bogdan-tirzioru/Powersupply/piesedisponibile.docx

1) INA 169NA

2) STM32F767ZIT

3) LT490CN8

4) MCP794124

5) MCP6491T

6) OPA134PA

7) MCP6001T

8) LM35CZ

9) ADC121S021

10) IRL640PBF

11) POT10K

12) MCP795W1O5

13) POWER REZISTOR 0.01

14) 4GBJ/4005

15) MCP6P22 1G AMP 21H
