bogdan-tirzioru/Powersupply/reaserch/alice/sapt2.docx

Orar:

Luni -

Marti 8-12 / 8-5

Miercuri 8-5

Joi 13-5/-

Vineri 8-12/8-5

- Revad partea electrica si o sa tin cont si de ce sfaturi mai primesc de la indrumatorul de licenta
- Testez partea de soft pentru buck
- Incep sa fac functionala partea de boost
- Maresc frecventa de lucru
