bogdan-tirzioru/Powersupply/reaserch/service_manual/HP_6234A_-_PWB_schematic.pdf

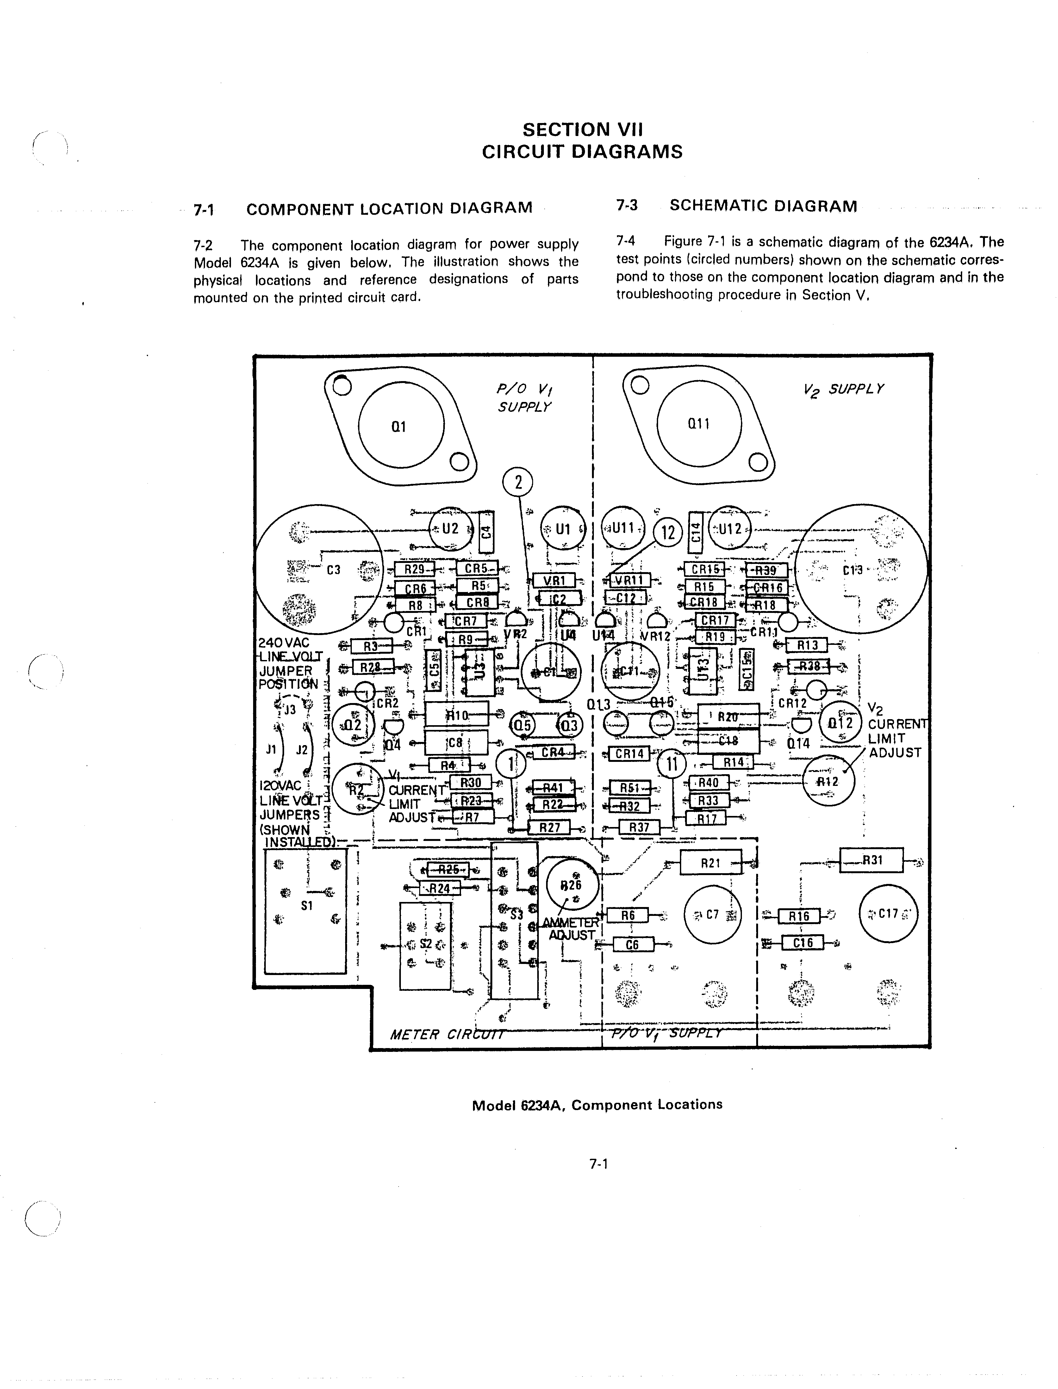
[picture p31: page 1]
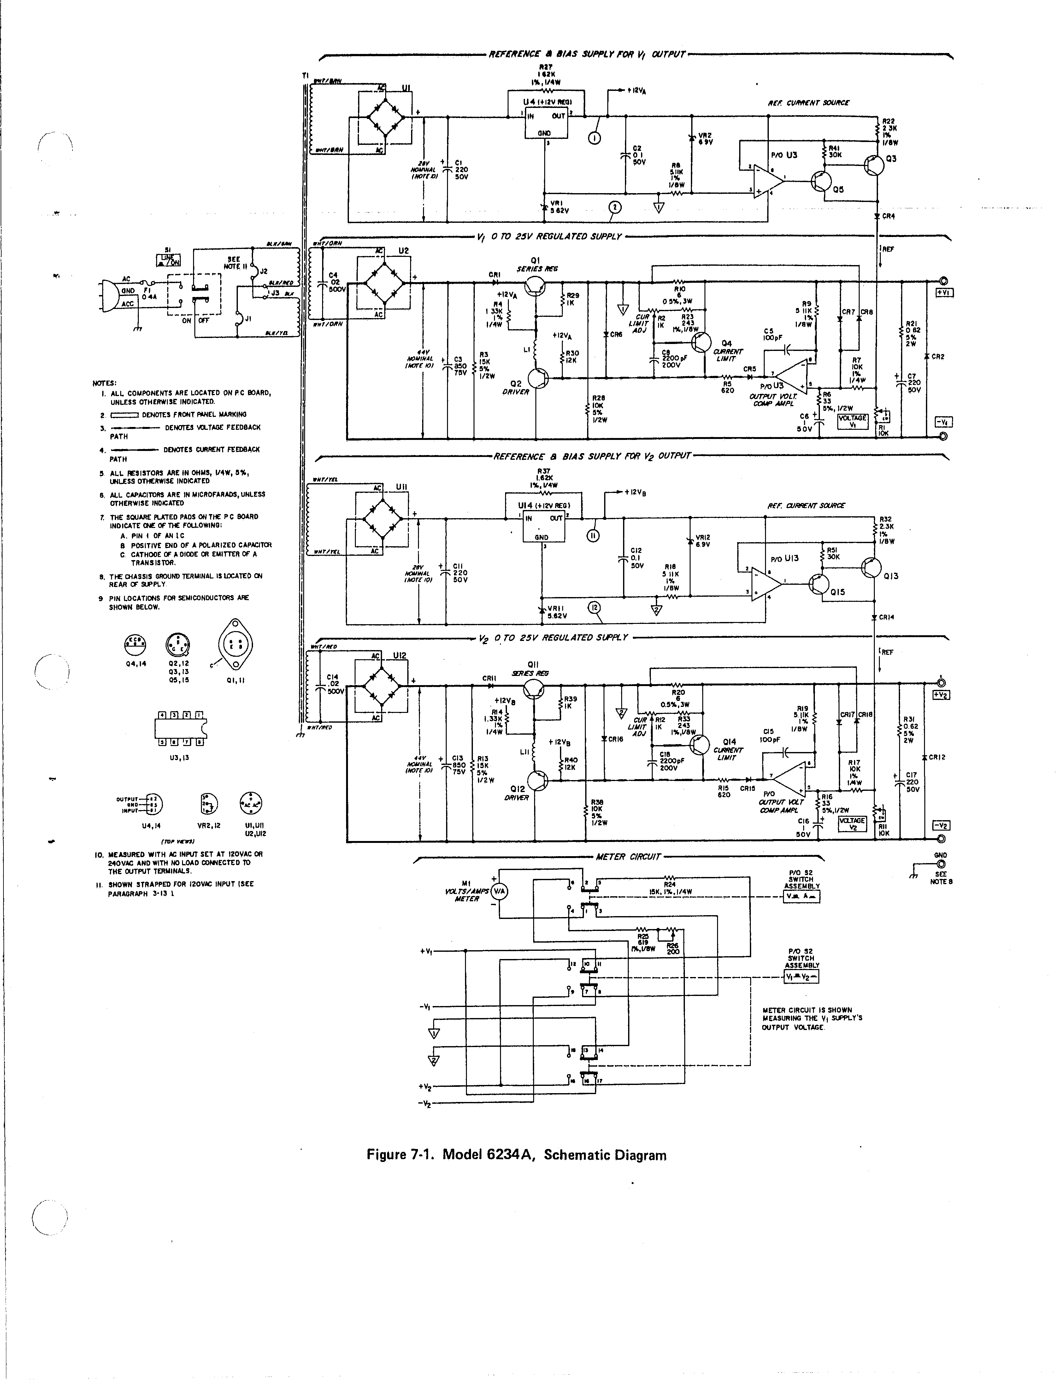
[picture p32: page 2]
