bogdan-tirzioru/Powersupply/AN/81038392_2620358008079881_7438287777852030976_n.jpg

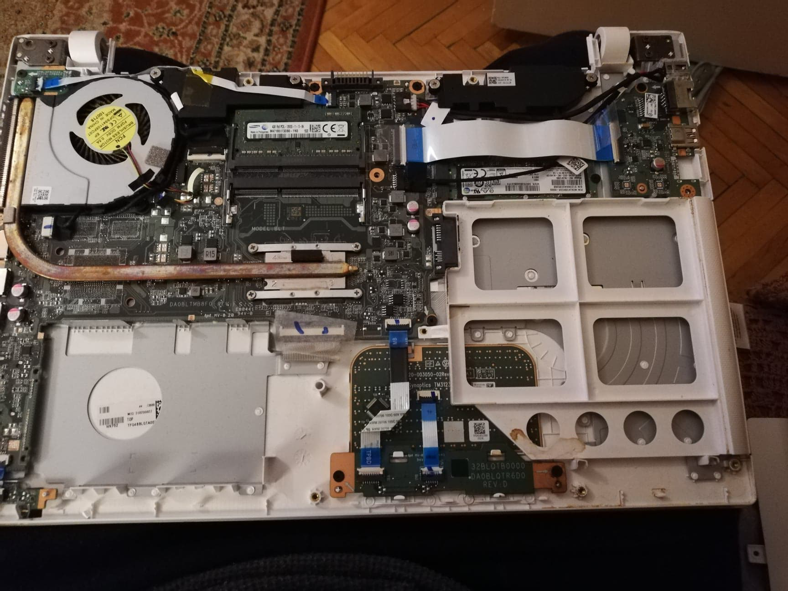
AN/81038392_2620358008079881_7438287777852030976_n.jpg
