bogdan-tirzioru/Powersupply/currentsense/Capture1.JPG

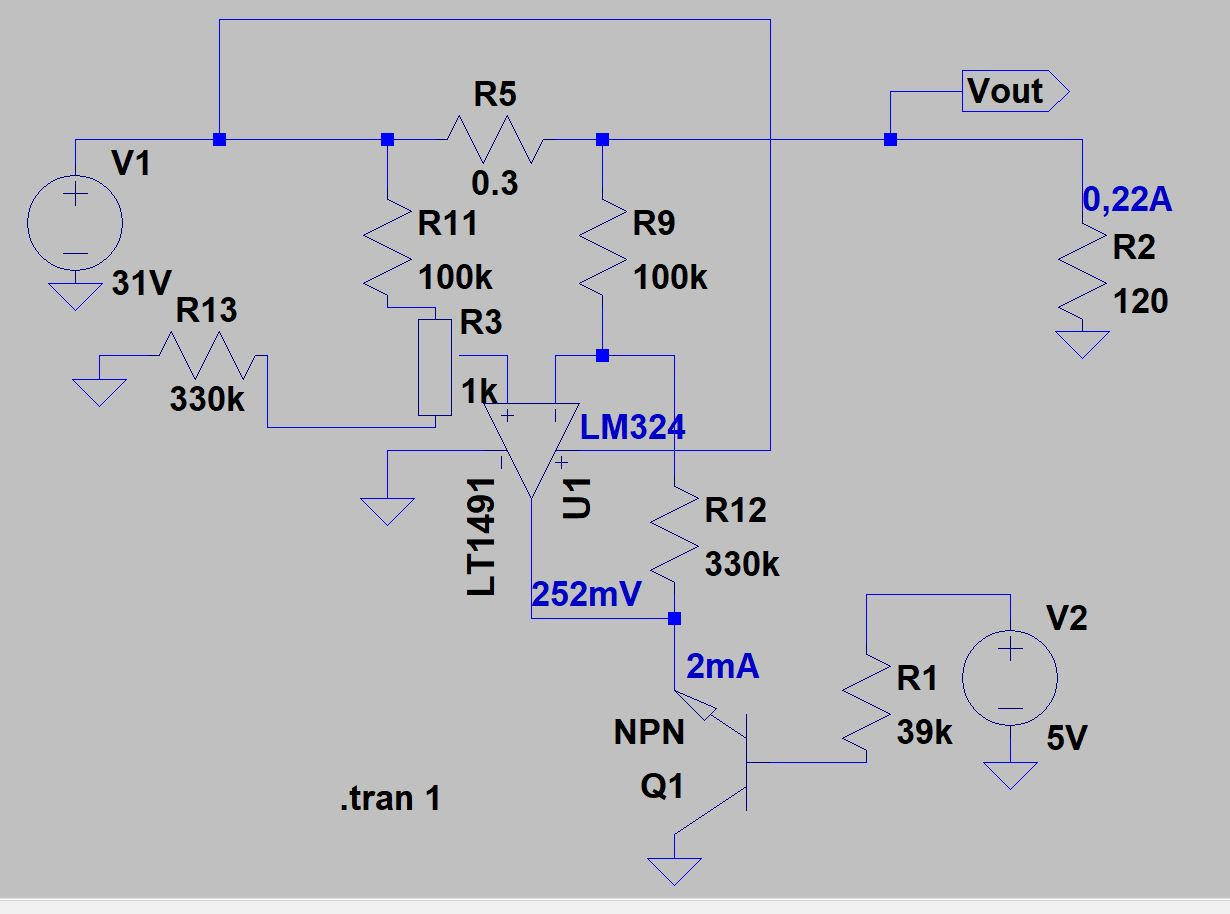
currentsense/Capture1.JPG
