bogdan-tirzioru/Powersupply/currentsense/Capture.JPG

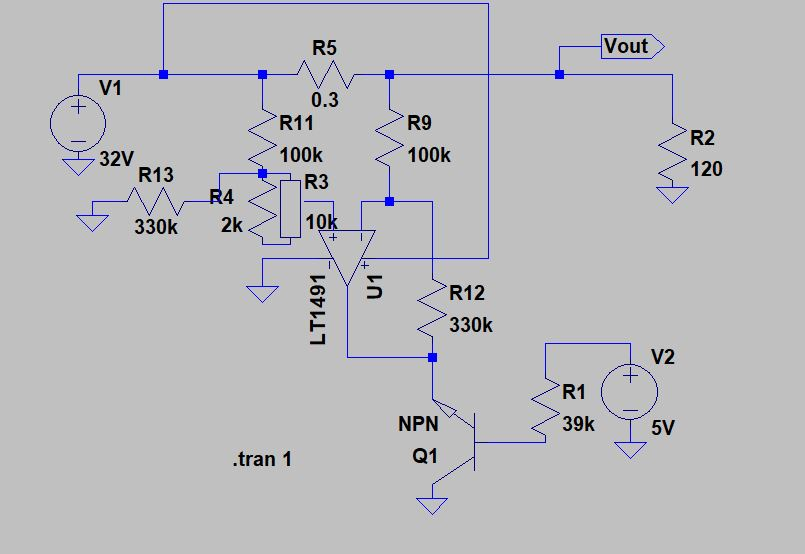
currentsense/Capture.JPG
