bogdan-tirzioru/Powersupply/reaserch/lm337/9978061434596733221.png

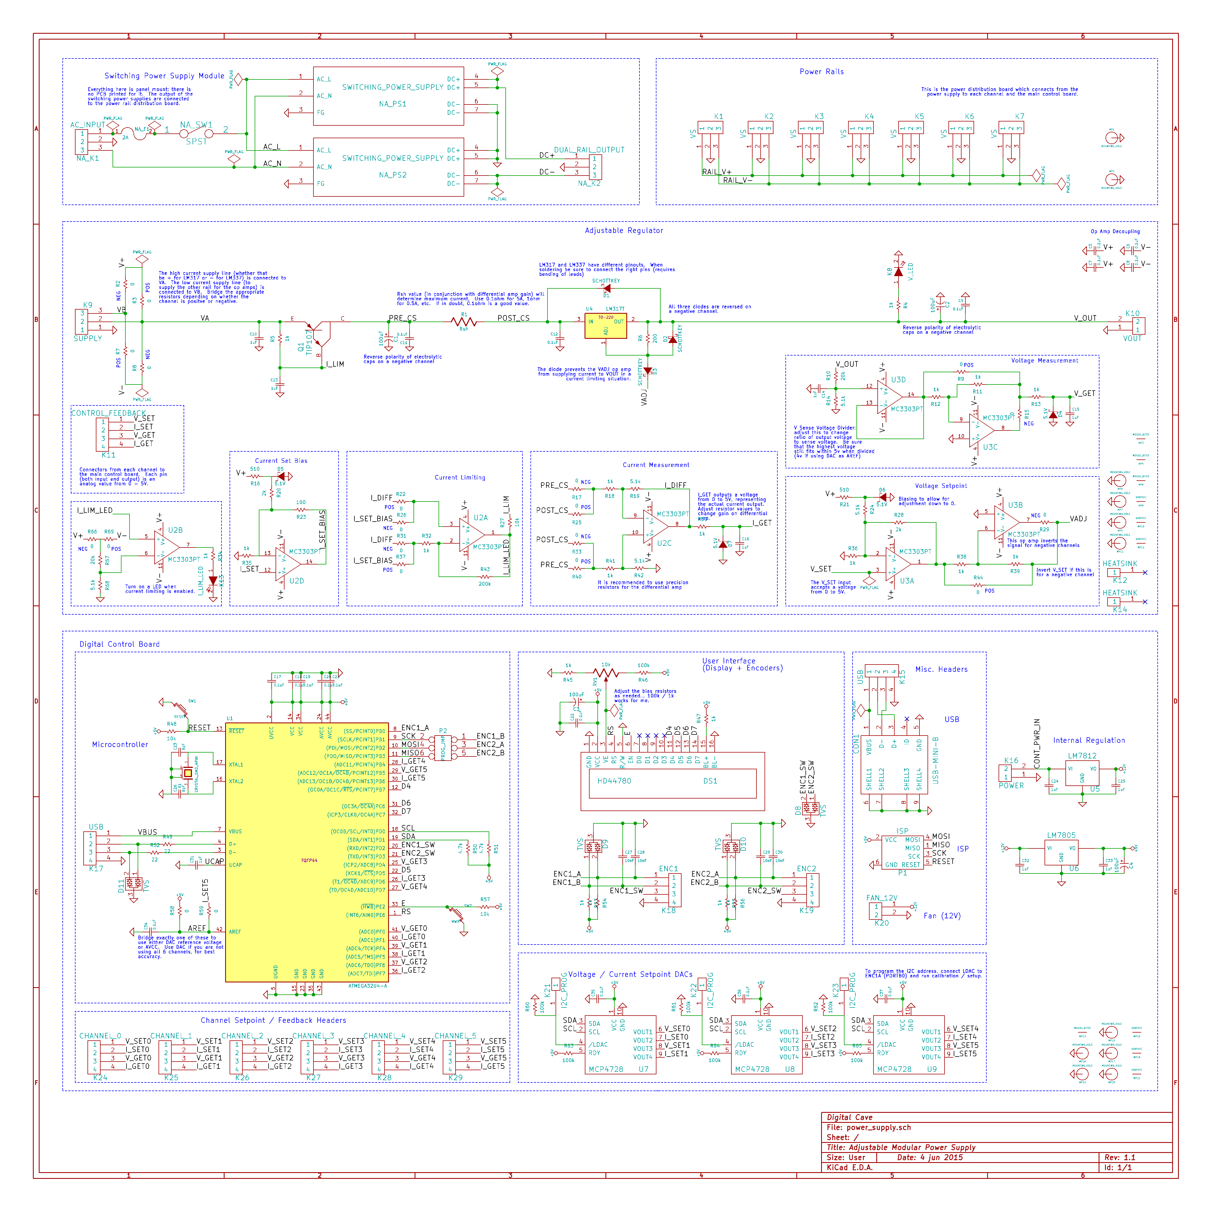
reaserch/lm337/9978061434596733221.png
