bogdan-tirzioru/Powersupply/reaserch/service_manual/HP_715A_Klystron_Power_Supply_Schematic.gif

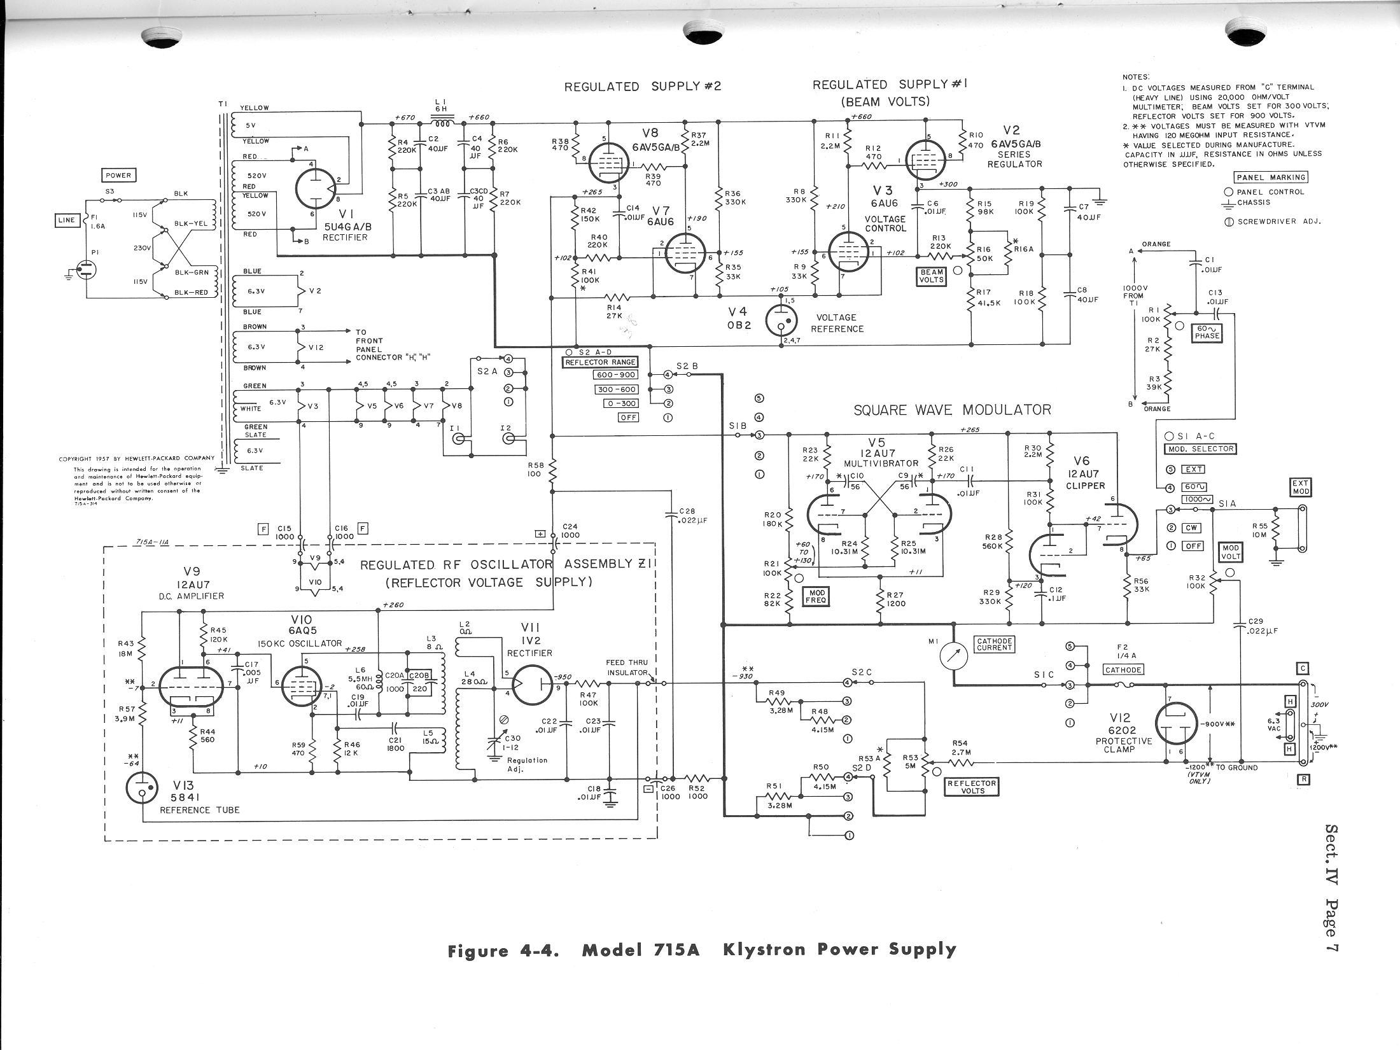
reaserch/service_manual/HP_715A_Klystron_Power_Supply_Schematic.gif
