bogdan-tirzioru/Powersupply/reaserch/service_manual/HP_6129_Schematic.gif

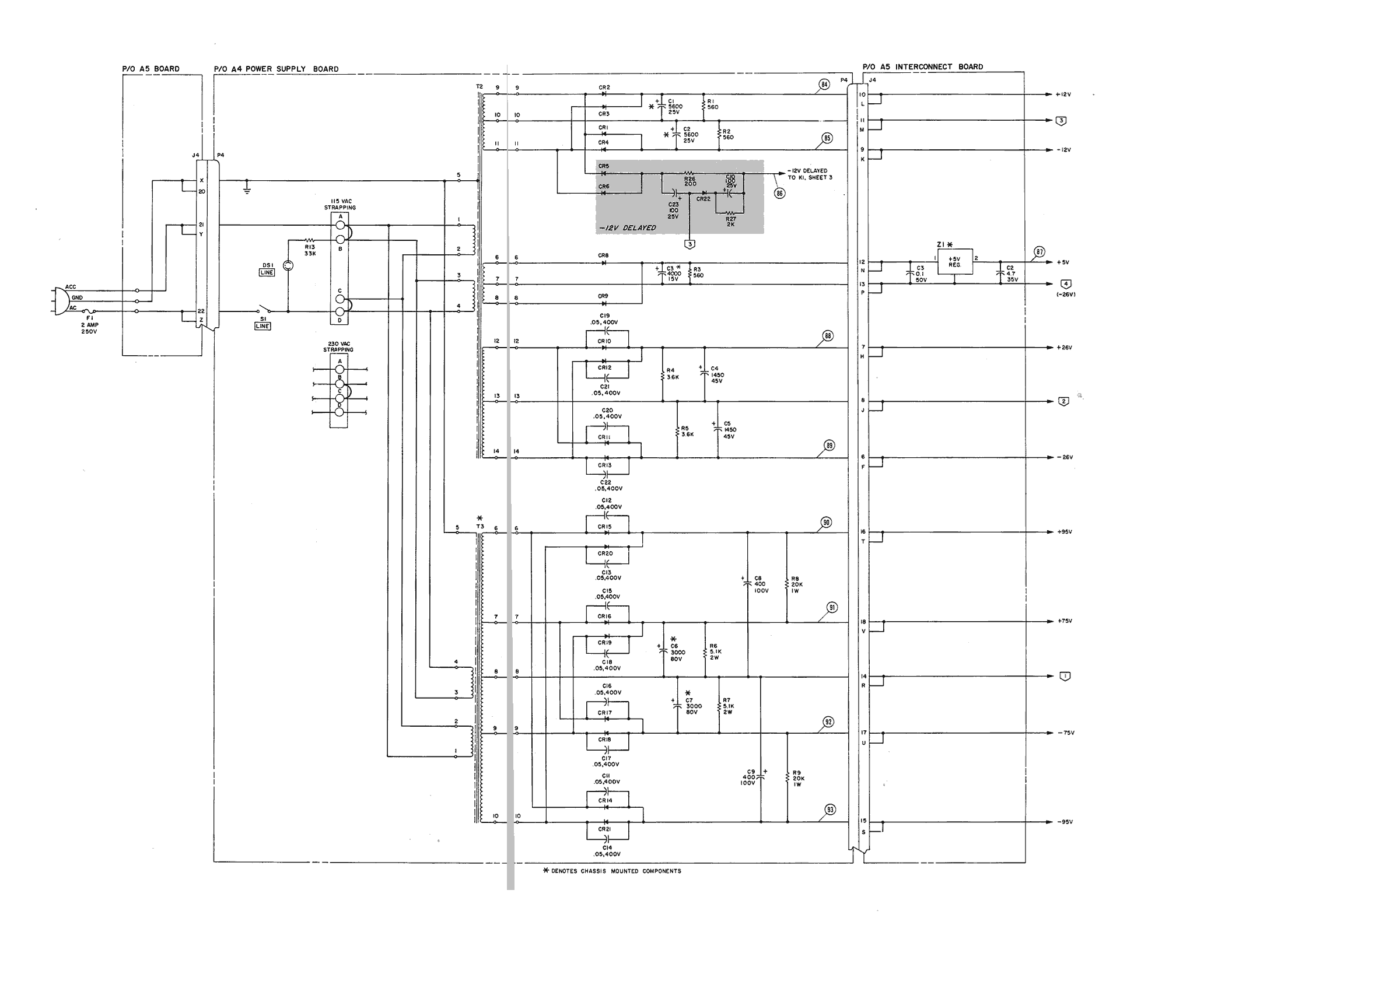
reaserch/service_manual/HP_6129_Schematic.gif
