bogdan-tirzioru/Powersupply/reaserch/psu-hw-master/Arduino shield/BOM/EEZ PSU Arduino shield+BP r3B4 BOM.pdf

EEZ PSU Arduino Shield BOM (r3B4, 2016-08-23) Project source code at https://github.com/eez-open
| | | | | | | | | | GBP/EUR ratio: | 1,19457
| | | | | | Farnell | | | TME
Qty | Part name | Package | Reference designator | Qty | Code | Unit price | Total | Code | Unit price | Total | Combined | THT SMD
1 2x3-pin socket | THT | MCU-ICSP | 1 7991983 | 0,605 | £0,61 | ZL262-6DG | 0,071 | 0,07 € | 0,071 € | 1
2 470n | 0805, 50V | C104, C109 | 2 2470492 | 0,043 | £0,09 | CL21B474KBFNNNG | 0,015 | 0,03 € | 0,031 € | 2
8 10n | 0805 | 8 1759246 | 0,011 | £0,09 | CL31B103KBCNNNC | 0,012 | 0,10 € | 0,096 € | 8
2 UPW1J150MED | SMD; Ø6.3x5.8mm | C106, C111 | 2 2326151 | 0,222 | £0,44 | UWT1H220MCL6GS | 0,088 | 0,18 € | 0,176 € | 2
2 10u | C107, C125 | 2 2362133 | 0,995 | £1,99 | CL32B106KBJNNNE | 0,203 | 0,41 € | 0,406 € | 2
27 100n | 0603 | 27 2496832 | 0,006 | £0,16 | CL10B104KO8NNNC | 0,004 | 0,12 € | 0,119 € | 27
1 47u | SMD, Ø6.3 x 5.8mm | C119 | 1 9695850 | 0,247 | £0,25 | EEEFK1V470P | 0,153 | 0,15 € | 0,153 € | 1
1 10u | SMD; Ø5 x 5.8mm | C120 | 1 1850112 | 0,206 | £0,21 | EEEFK1V100R | 0,200 | 0,20 € | 0,200 € | 1
1 EECS5R5H105 | THT | C127 | 1 9697497 | 2,780 | £2,78 | EECS5R5H105 | 2,190 | 2,19 € | 2,190 € | 1
1 22n | 0805 | C130 | 1 1759252 | 0,021 | £0,02 | CL21B223KBANNNC | 0,008 | 0,01 € | 0,008 € | 1
2 18p | 0805 | C131, C135 | 2 2320820 | 0,038 | £0,08 | CL21C180JBANNNC | 0,010 | 0,02 € | 0,019 € | 2
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
C113, C114, C115, C116, C117, C118, C121, C122, C123, C124, C126, C128, C129, C136, C137, C138, C139, C140, C141, C142, C143, C147, C149, C150, C151, C153, C156

LED_CC1, LED_CC2, LED_PROG1, LED_PROG2, LED_SP
LED_CV1, LED_CV2, LED_S1,
LED_S2

R134, R135, R137, R139, R141, R144, R145, R169, R171

4 180R | 0805 | R142, R155, R156, R158 | 4 2447583 | 0,005 | £0,02 | SMD0805-180R-1% | 0,008 | 0,03 € | 0,024 € | | 4
2 100K | 0805 | R143, R154 | 2 2352619 | 0,063 | £0,13 | SMD0805-100K-1% | 0,008 | 0,02 € | 0,016 € | | 2
4 49R9 | 0805 | R146, R148, R149, R150 | 4 2141727 | 0,016 | £0,06 | RC0805FR-0749R9 | 0,007 | 0,03 € | 0,029 € | | 4
5 10K | 0805 | R147, R153, R157, R170, R172 | 5 9237755 | 0,009 | £0,05 | RC0805FR-0710K | 0,007 | 0,03 € | 0,033 € | | 5
1 10R | 1206 | R151 | 1 9236643 | 0,013 | £0,01 | CRCW120610R0FKTABC | 0,014 | 0,01 € | 0,014 € | | 1
1 12K4 | 0805 | R152 | 1 2141850 | 0,002 | £0,00 | - | | | 0,002 € | | 1
2 750R | 0805 | R160, R161 | 2 9333525 | 0,016 | £0,03 | CRCW0805750RFKTABC | 0,012 | 0,02 € | 0,023 € | | 2
2 47K | 0805 | R162, R163 | 2 2447664 | 0,005 | £0,01 | RC0805FR-0747K | 0,007 | 0,01 € | 0,012 € | | 2
1 100R | 0805 | R164 | 1 1759246 | 0,011 | £0,01 | RC0805FR-07100R | 0,007 | 0,01 € | 0,007 € | | 1
2 5K1 | 0805 | R165, R166 | 2 9333320 | 0,016 | £0,03 | RC0805FR-075K1 | 0,007 | 0,01 € | 0,013 € | | 2
2 1K | 0805 | R167, R168 | 2 1099800 | 0,009 | £0,02 | RC0805FR-071K | 0,007 | 0,01 € | 0,013 € | | 2
2 4x10K | 1206; resistor array | RN1, RN2 | 2 1770137 | 0,088 | £0,18 | DR1206-10K-4/8 | 0,007 | 0,01 € | 0,013 € | | 2
1 LD-BZEN-0903 | THT | SP1 | 1 - | | | LD-BZEN-0903 | 0,508 | 0,51 € | 0,508 € | 1
1 A101SYCQ04 | THT | SW1 | 1 2292959 | 1,960 | £1,96 | - | | | 2,341 € | 1
1 1301.9316 | SMD; tactile switch | SW2 | 1 1217765 | 0,510 | £0,51 | 1301.9316 | 0,220 | 0,22 € | 0,220 € | | 1
1 MC000006 | | X12 | 1 2007972 | 1,530 | £1,53 | - | | | 1,828 € | 1
2 TSW-113-07-F-D | THT | X13, X15 | 2 2025182 | 1,640 | £3,28 | - | | | 3,918 € | 2
1 MC000005 | | X14 | 1 2007971 | 1,190 | £1,19 | - | | | 1,422 € | 1
1 9185067324 | THT | X16 | 1 1096984 | 0,745 | £0,75 | T821-1-10-S1 | 0,290 | 0,29 € | 0,290 € | 1
1 22-23-2021 | THT | X17 | 1 1462926 | 0,040 | £0,04 | MX-22-23-2021 | 0,070 | 0,07 € | 0,048 € | 1
1 MC34753 | THT | X18 | 1 1593431 | 0,331 | £0,33 | - | | | 0,395 € | 1
5 826629-8 | THT | | 5 1022256 | 0,084 | £0,42 | ZL201-08G | 0,065 | 0,32 € | 0,324 € | 5
1 22-23-2041 | THT | X19 | 1 1462920 | 0,130 | £0,13 | MX-22-23-2041 | 0,106 | 0,11 € | 0,106 € | 1
1 32,768kHz | THT | Y1 | 1 1611828 | 0,131 | £0,13 | 32.768K-TC38 | 0,144 | 0,14 € | 0,144 € | 1
1 25MHz | SMD, 11.5mm x 4.7mm | Y2 | 1 2467741 | 0,111 | £0,11 | 25.00M-SMDHC49S | 0,373 | 0,37 € | 0,133 € | | 1
2 SMAJ18A | DO-214AC | ZD10, ZD11 | 2 1749305 | 0,040 | £0,08 | P4SMAJ18A-DIO | 0,105 | 0,21 € | 0,095 € | | 2
1 BZX384-C4V3 | SOD-323 | ZD12 | 1 8735697 | 0,133 | £0,13 | BZT52C4V3-DIO | 0,019 | 0,02 € | 0,019 € | | 1
2 P4SMAJ48A | DO-214AC | ZD8, ZD9 | 2 1749310 | 0,157 | £0,31 | P4SMAJ48A-DIO | 0,102 | 0,20 € | 0,204 € | | 2
£51,74 | 20,89 € | 46,62 € 21 | 153

Not installed
1 826926-2 | THT | JP3 | 1 - | | | - | | | | - | -
1 NRF24L01 module | THT | WIFI | 1 - | | | - | | | | - | -
1 SSW-105-02-S-D | THT | X20 | 1 - | | | - | | | | - | -

Other
2 BS-244DSM-R | Binding post 4mm, red | J1, J4 | 2 1815818 | 2,120 | £4,24 | BS-244DSM-R | 1,120 | 2,24 € | 2,240 € | - | -
1 BS-244DSM-G | Binding post 4mm, green | J2 | 1 1815820 | 2,170 | £2,17 | BS-244DSM-G | 1,120 | 1,12 € | 1,120 € | - | -
2 BS-244DSM-B | Binding post 4mm, black | J3, J5 | 2 1815819 | 2,110 | £4,22 | BS-244DSM-B | 1,140 | 2,28 € | 2,280 € | - | -
1 Arduino Due | | | 1 - | | | Eckstein | 19,480 | 19,48 € | 19,480 € | - | -
1 3.2" TFT LCD | | | 1 - | | | Eckstein | 12,140 | 12,14 € | 12,140 € | - | -
1 USB adapter cable | | | 1 | | | | | | | - | -
2 NSR-08 | | 2 - | NSR-08 | 0,086 | 0,17 € | 0,171 € | - | -
1 NSR-05 | | 1 - | NSR-05 | 0,026 | 0,03 € | 0,026 € | - | -
21 NDR-T | | 21 - | NDR-T | 0,026 | 0,55 € | 0,554 € | - | -
9 | n/a | 9 - | TFM-M5X8/DR218 | 0,187 | 1,68 € | 1,681 € | - | -

THT, solder on bottom layer!

THT, solder on bottom layer!

MCU-ADCL, MCU-ADCH, MCU-COMM, MCU-PWML, MCU-PWMH

Search for micro usb 5pin male to 1x 5Pin Female 0.1" USB (e.g.
http://www.aliexpress.com/store/product/Free-Shipping-50CMmicro-usb-5pin-male-to-1x-5Pin-Female-0-1-USB-header-PCB/1171008_32233605468.ht ml)

Plug; female; PIN:8 w/o
terminals for Ethernet cable Plug; female; PIN:5 w/o
terminals for USB cable
Contact; female; 28÷22AWG; NSR/NDR; tinned
Screwed spacer sleeve;
M5; 8mm; brass

Extend binding post for PCB mounting

4 | n/a | 4 1733405 | 0,065 | £0,26 | DR316/3.2X5 | 0,057 | 0,23 € | 0,228 € | - | -
4 | n/a | 4 2494576 | 0,238 | £0,95 | - | | | 1,137 € | - | -
4 Plastic washer; round; M3 | | 4 - | | | B3/BN1074 | 0,008 | 0,03 € | 0,032 € | - | -
11 Light pipe for LED | n/a | 11 2293496 | 0,362 | £3,98 | PLP2-625 | 0,486 | 5,35 € | 4,757 € | - | -
| | | | £15,82 | | | 45,30 € | 45,85 €
All prices are net prices (without VAT)

Spacer sleeve; 5mm;
cylindrical; brass

5 mm between TFT display and front panel
Screwed spacer sleeve;
hexagonal; polyamide; M3

11 mm between TFT display and PCB

Round; Ø3mm; Front: convex; straight
