bogdan-tirzioru/Powersupply/reaserch/alice/To_Do_List_PowerSupply.xlsx

Sheet: TODOs
To Do List
Power Supply
No. | Date | Topic / Item | T | Description / Comment / Result | P | Due Date | Start Date | Completion Date | Status | Duration (mh) | Delay (md)
 |  |  |  | FIRST ROW
 |  |  | S |  | P |  |  |  | grau
 |  |  |  |  |  |  |  |  | grau
 |  |  | S |  | P |  |  |  | grau
1 |  | prototype | A | - Revad partea electrica si o sa tin cont si de ce sfaturi mai primesc de la indrumatorul de licenta [11.01] Dn Ursarul , revenim in al doilea semestru. Am luat legatura cu Costel Cristea HW developer. Documentatie primita. | 1 | 2017-12-23 |  | 2017-12-23 | grün
2 |  | prototype | A | - Testez partea de soft pentru buck | 1 | 2017-12-23 |  | 2017-12-23 | grün
3 |  | prototype | A | - Incep sa fac functionala partea de boost | 1 | 2017-12-24 |  |  | rot
4 |  | prototype | A | - Maresc frecventa de lucru - calcul din soft, modul de PWM( din datash pare ca se poate) | 1 | 2017-02-17 |  |  | rot
5 |  | prototype | A | -> Cristea Costel -> recalculezi piesele bobina si condesator pe partea de buck si boost. | 1 | 2017-02-17 |  |  | rot
6 |  | prototype | A | -> Cristea Costel -> actualizare schema licenta cu remarcile de la Costel | 1 | 2017-02-17 |  |  | rot
7 |  | licenta | A | primul draft e gata, inclusiv un drapt de layout. Costel a revizuit aceasta schema. | 1 | 2017-01-13 |  | 2017-12-23 | grün
8 |  | licenta | A | Partea scrisa pentru licenta, de tradus in limba romana. | 1 | 2017-02-17 |  |  | rot
9 |  | licenta | A | De luat template de licenta pentru carte scrisa de la profesor. | 1 | 2017-02-17 |  |  | rot
10 |  | licenta | D | Partea de boost test doar pe placa de licenta | 1 | 2017-01-11 |  |  | grau
11 |  | licenta | D | Labview pentru interfata cu calculatorul | 1 | 2017-01-11 |  |  | grau
 |  |  |  | LAST ROW

Sheet: Orar
Orar:
Luni -
Marti 8-12 / 8-5
Miercuri 8-5
Joi 13-5/-
Vineri 8-12/8-5
