bogdan-tirzioru/Powersupply/shopping_card/lista_parts2.PNG

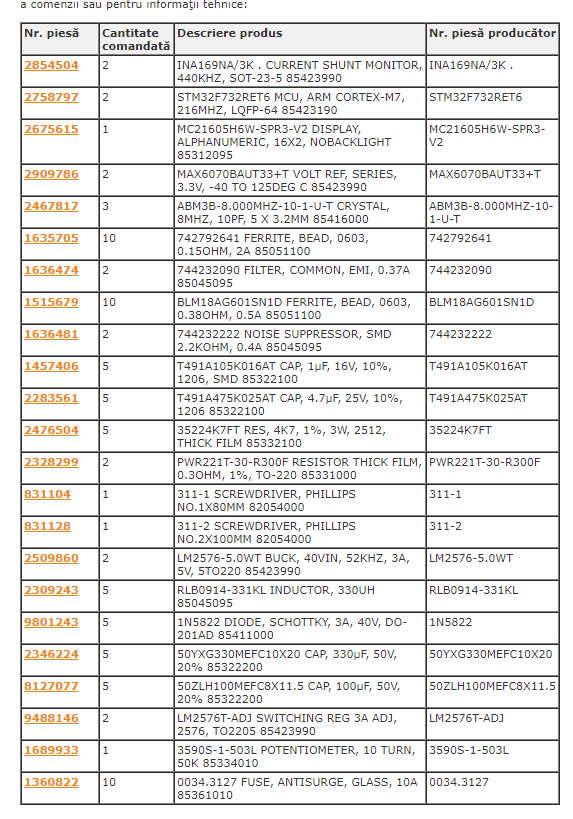
shopping_card/lista_parts2.PNG
