bogdan-tirzioru/Powersupply/reaserch/psu-hw-master/Mechanical/EEZ PSU H24005 enclosure r4.6.dxf

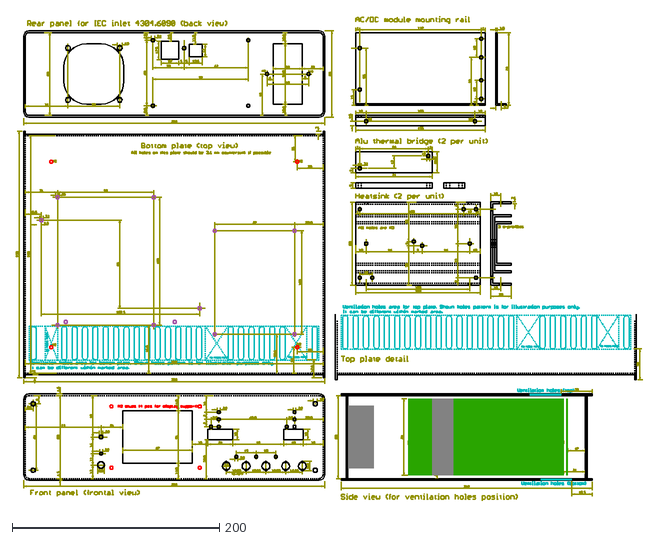
[picture p40: CAD file, 2020-10-24]
reaserch/psu-hw-master/Mechanical/EEZ PSU H24005 enclosure r4.6.dxf
603.5 x 466.7
