bogdan-tirzioru/Powersupply/reaserch/psu-hw-master/Mechanical/EEZ PSU H24005 enclosure r4.5a (for 4mm acryl).dxf

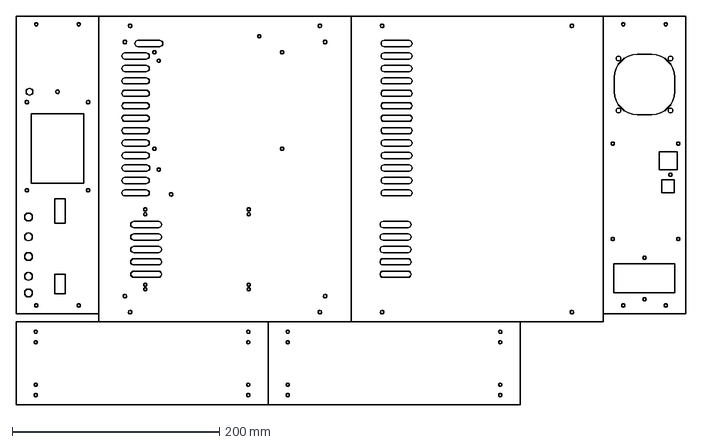
[picture p41: CAD file, 2020-10-24]
reaserch/psu-hw-master/Mechanical/EEZ PSU H24005 enclosure r4.5a (for 4mm acryl).dxf
646.0 x 375.0 mm
