bogdan-tirzioru/Powersupply/(list of files, cad)

Other CAD files:
powersupply_frimware_pic/software/power.obj
