bogdan-tirzioru/Powersupply/reaserch/service_manual/link.txt.txt

http://www.ko4bb.com/manuals/index.php?dir=HP_Agilent
