bogdan-tirzioru/Powersupply/reaserch/service_manual/rgh1254454039j.jpg

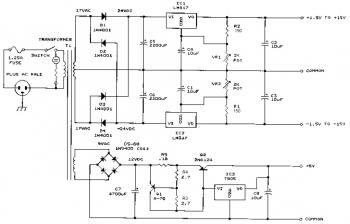
reaserch/service_manual/rgh1254454039j.jpg
