bogdan-tirzioru/Powersupply/reaserch/service_manual/U8002A.jpg

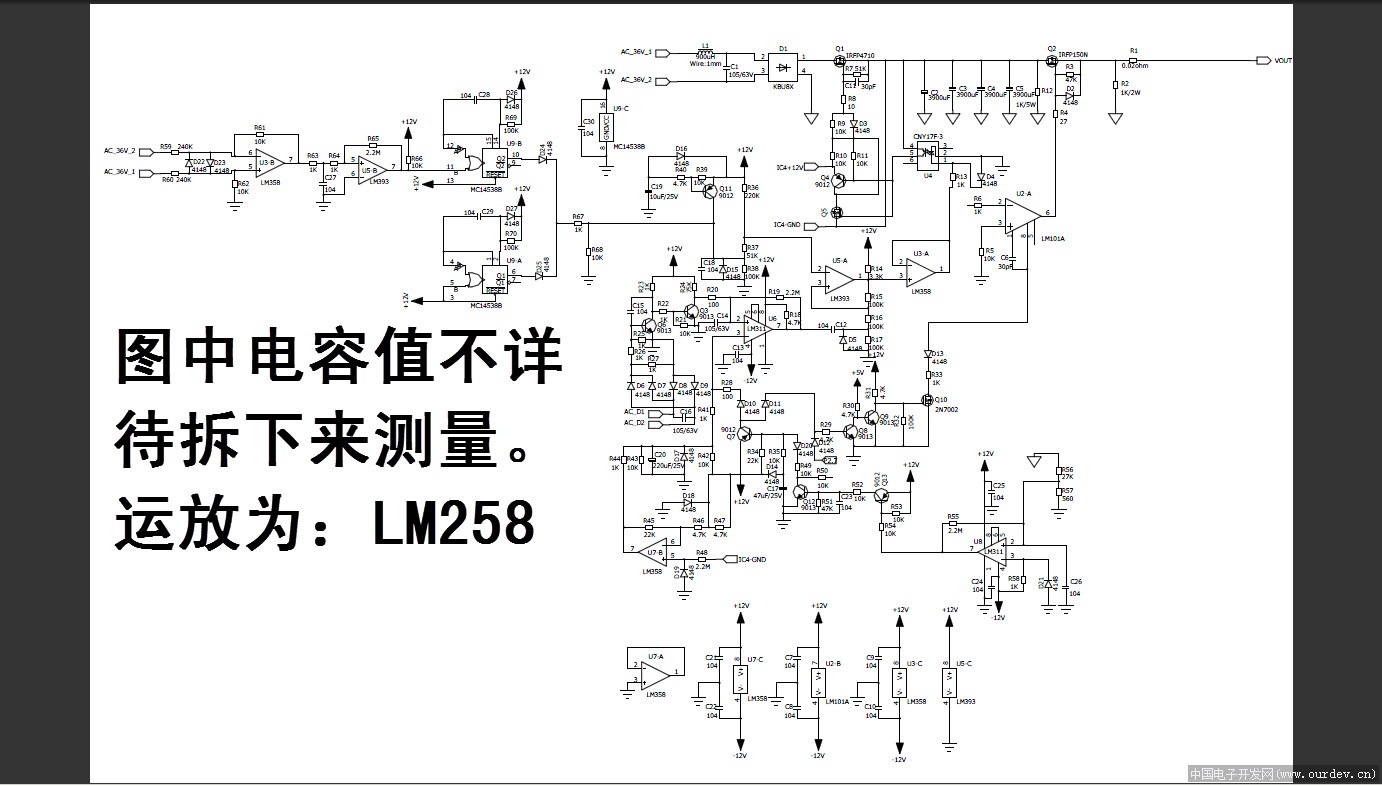
reaserch/service_manual/U8002A.jpg
