bogdan-tirzioru/Powersupply/testresults/sampleB/NewFile0_10V.bmp

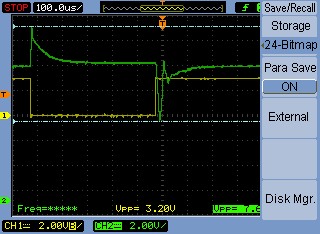
testresults/sampleB/NewFile0_10V.bmp
