bogdan-tirzioru/Powersupply/testresults/sampleB/NewFile1_10v.bmp

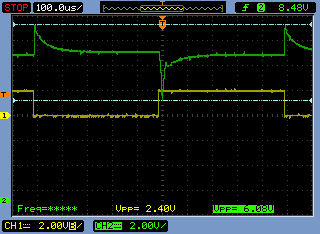
testresults/sampleB/NewFile1_10v.bmp
