bogdan-tirzioru/Powersupply/testresults/sampleB/NewFile2_10V.bmp

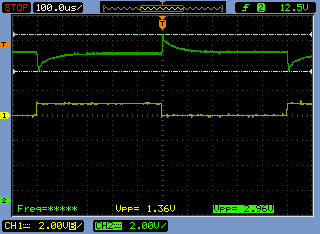
testresults/sampleB/NewFile2_10V.bmp
