bogdan-tirzioru/Powersupply/testresults/sampleB/NewFile3_5V.bmp

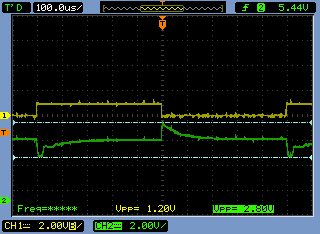
testresults/sampleB/NewFile3_5V.bmp
