bogdan-tirzioru/Powersupply/testresults/sampleB/NewFile5_5V.bmp

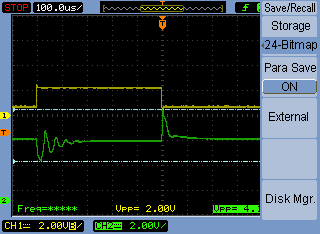
testresults/sampleB/NewFile5_5V.bmp
