bogdan-tirzioru/Powersupply/testresults/sampleB/NewFile6_20V.bmp

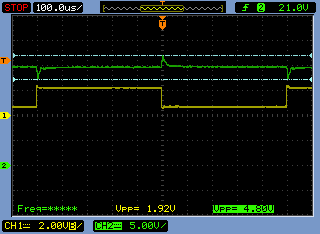
testresults/sampleB/NewFile6_20V.bmp
