bogdan-tirzioru/Powersupply/testresults/sampleB/NewFile8_20V.bmp

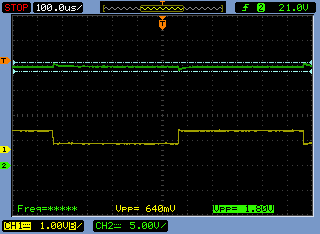
testresults/sampleB/NewFile8_20V.bmp
