bogdan-tirzioru/Powersupply/testresults/sampleB/NewFile9_3V.bmp

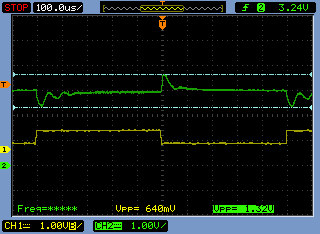
testresults/sampleB/NewFile9_3V.bmp
