bogdan-tirzioru/Powersupply/testresults/sampleB/NewFile11_3V.bmp

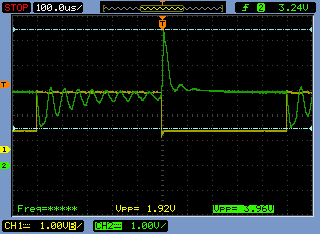
testresults/sampleB/NewFile11_3V.bmp
