bogdan-tirzioru/Powersupply/reaserch/service_manual/HP_6289A.changes.pdf

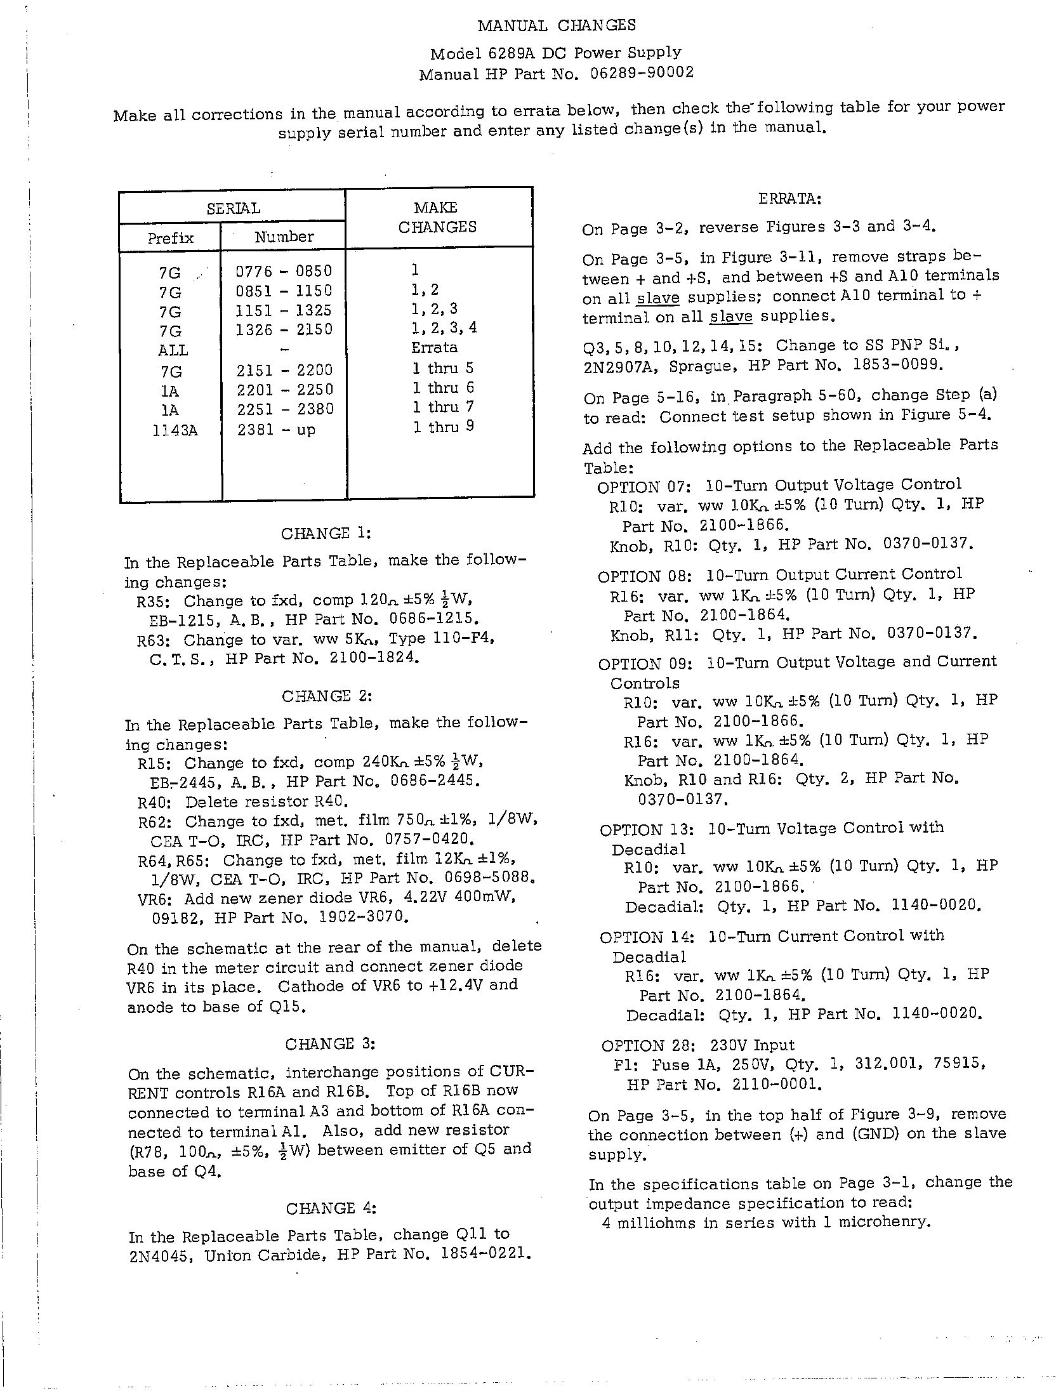
[picture p54: page 1]
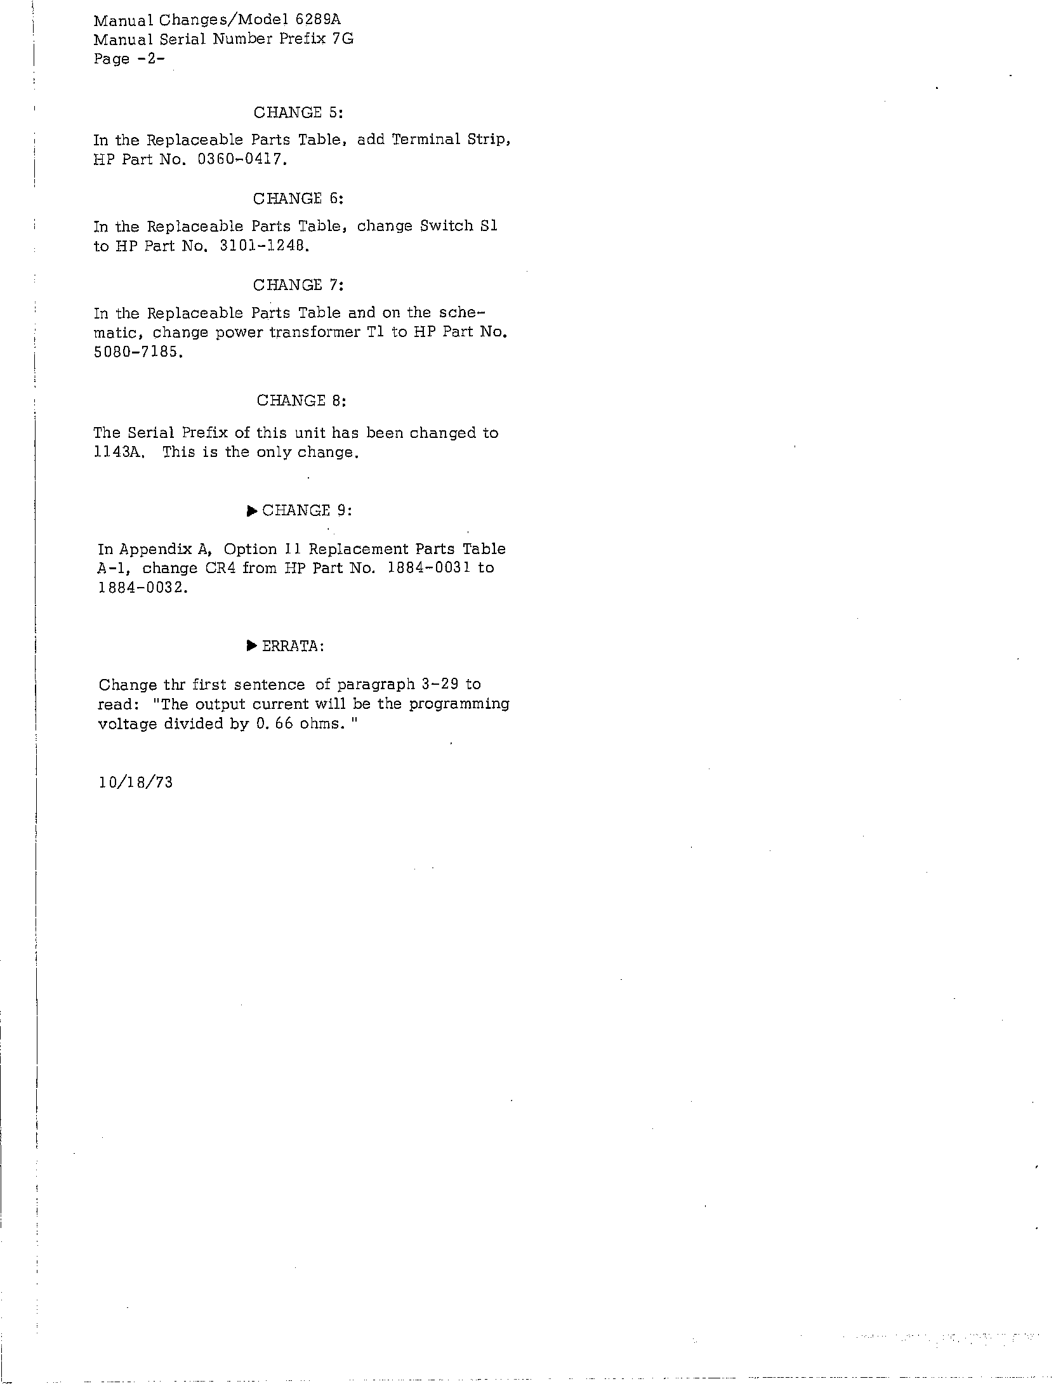
[picture p55: page 2]
