bogdan-tirzioru/Powersupply/factory/sampleB/Job2.PDF

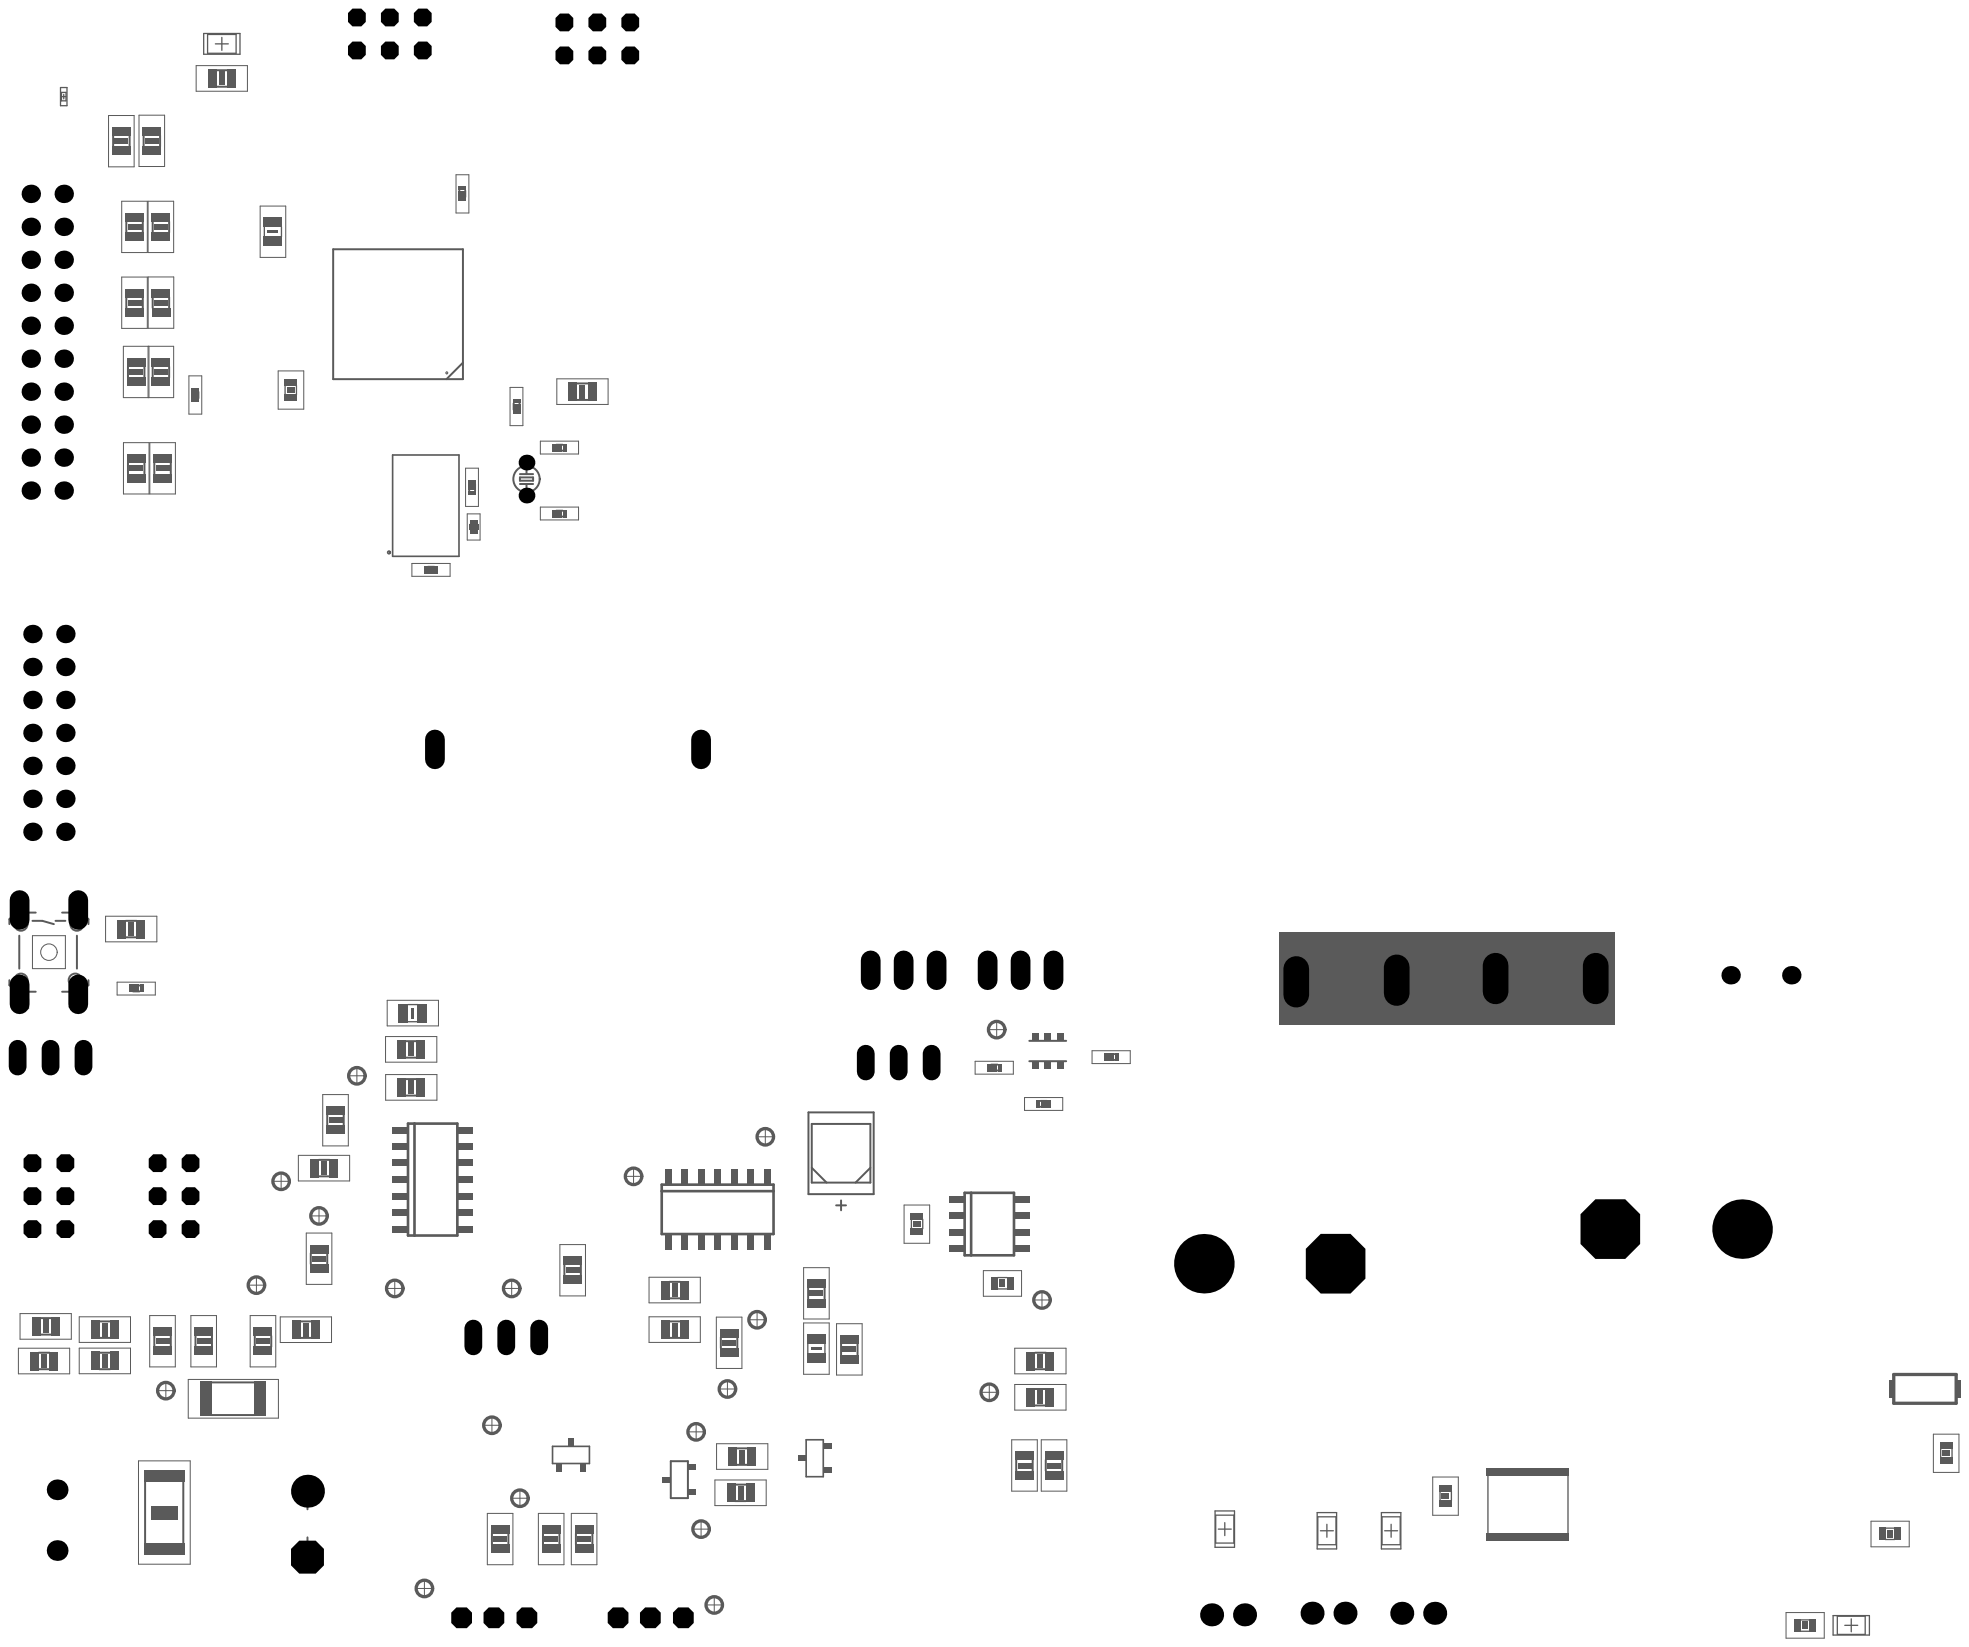
[picture p56: page 1]

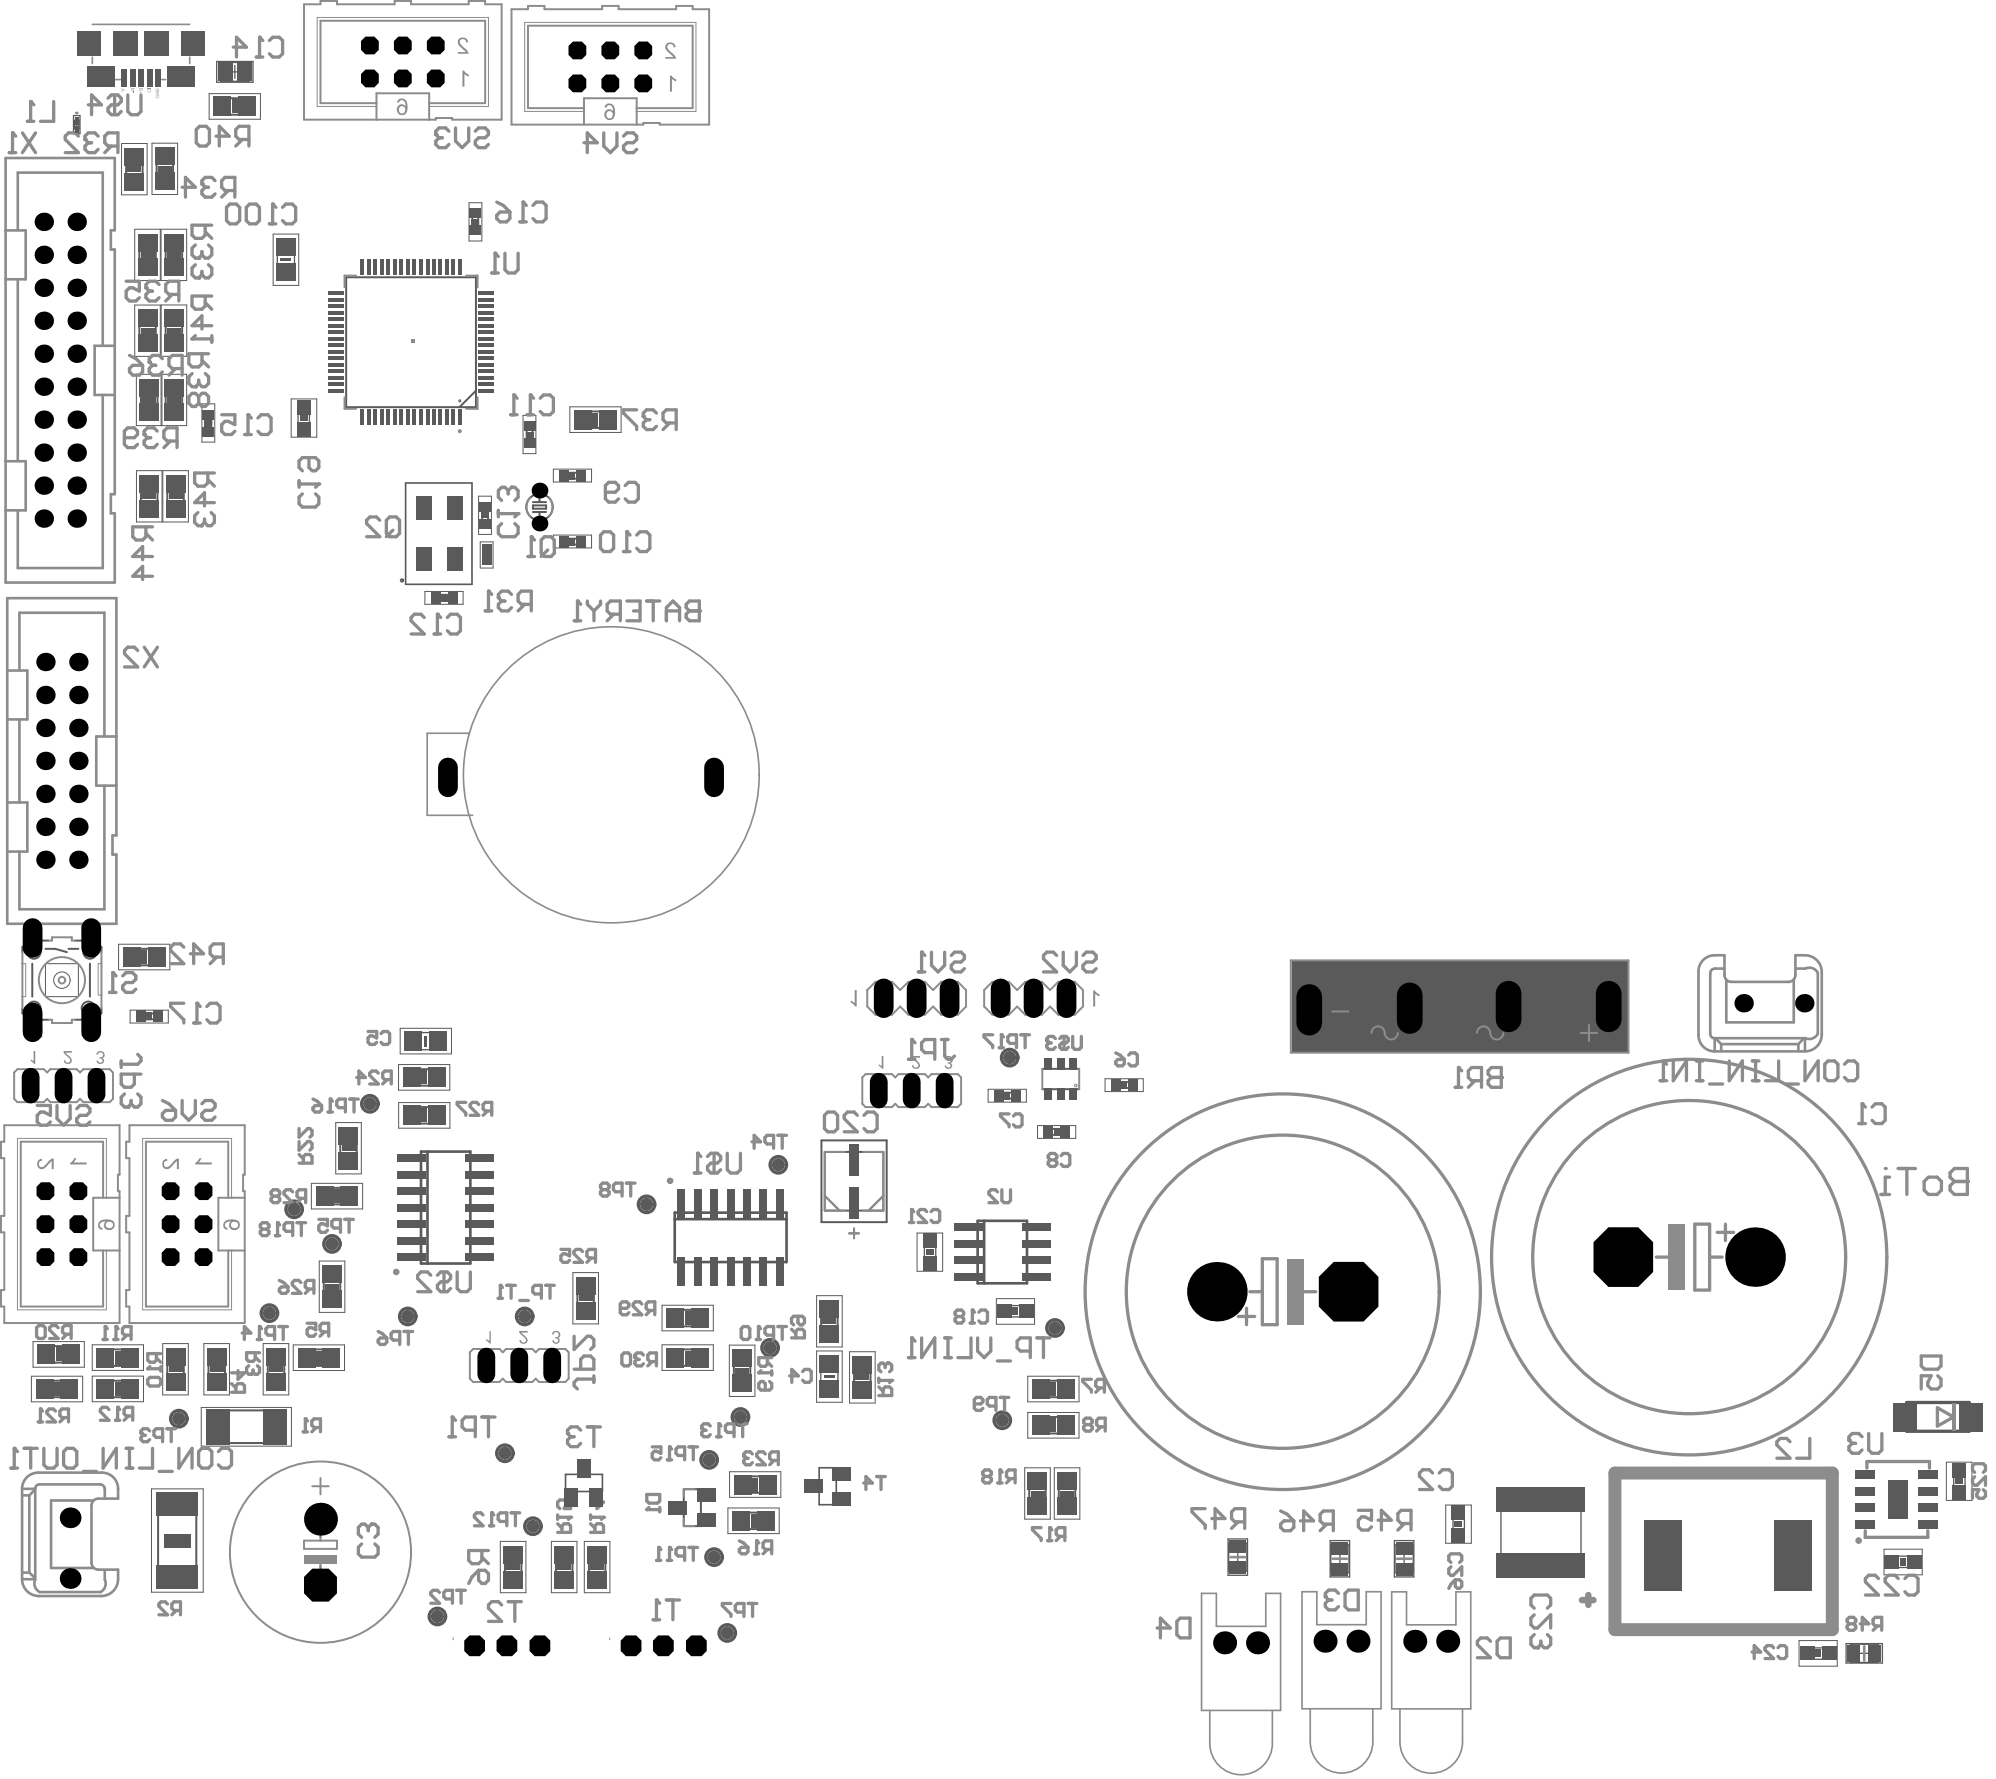
[picture p57: page 2]

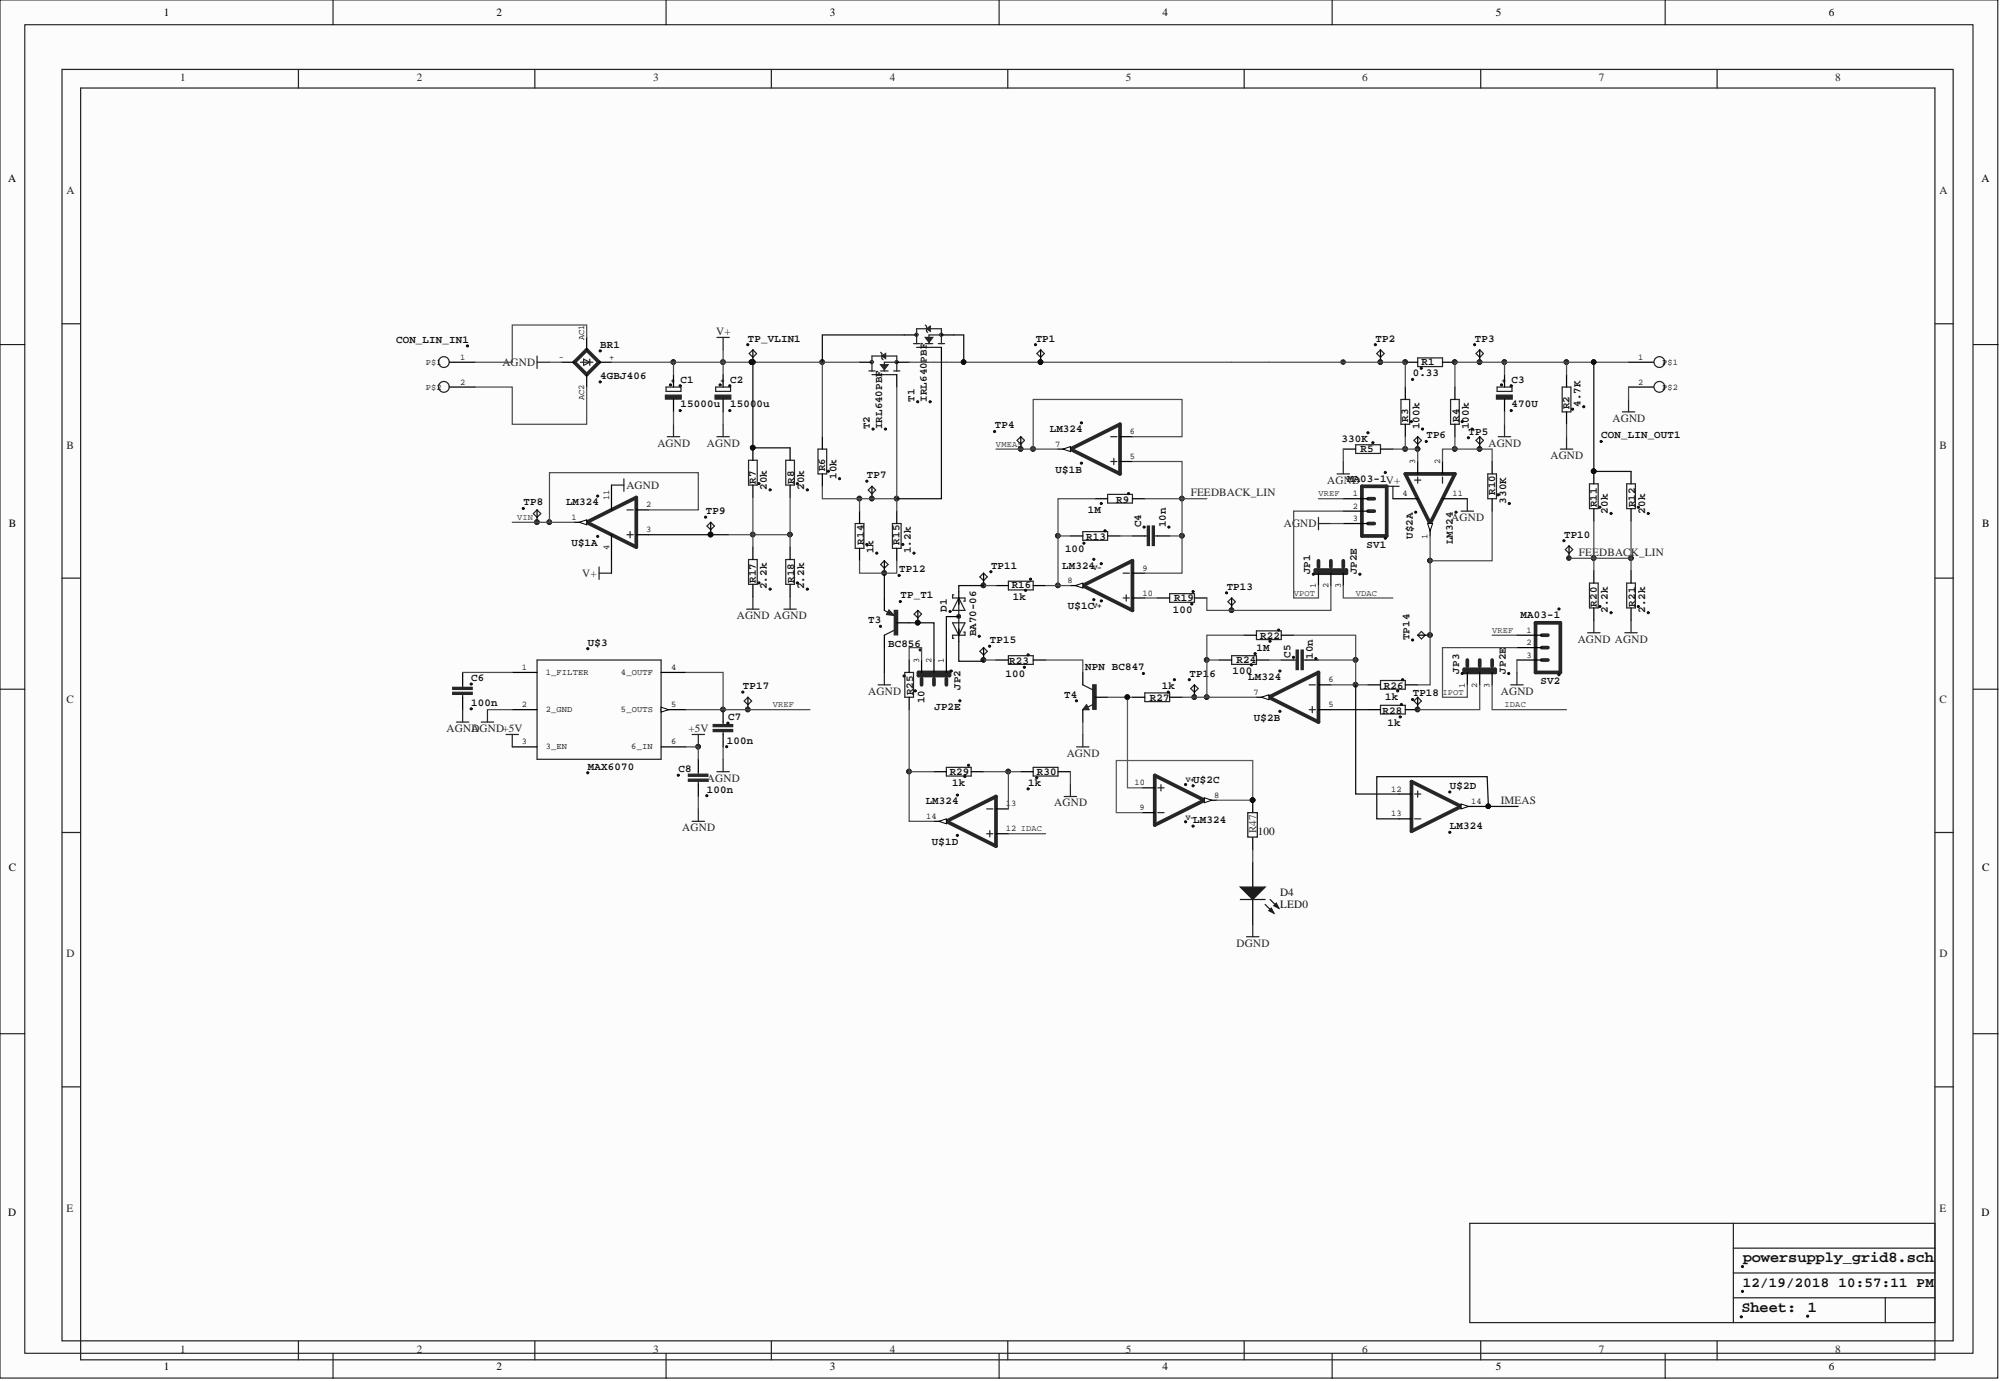
[picture p58: page 3]

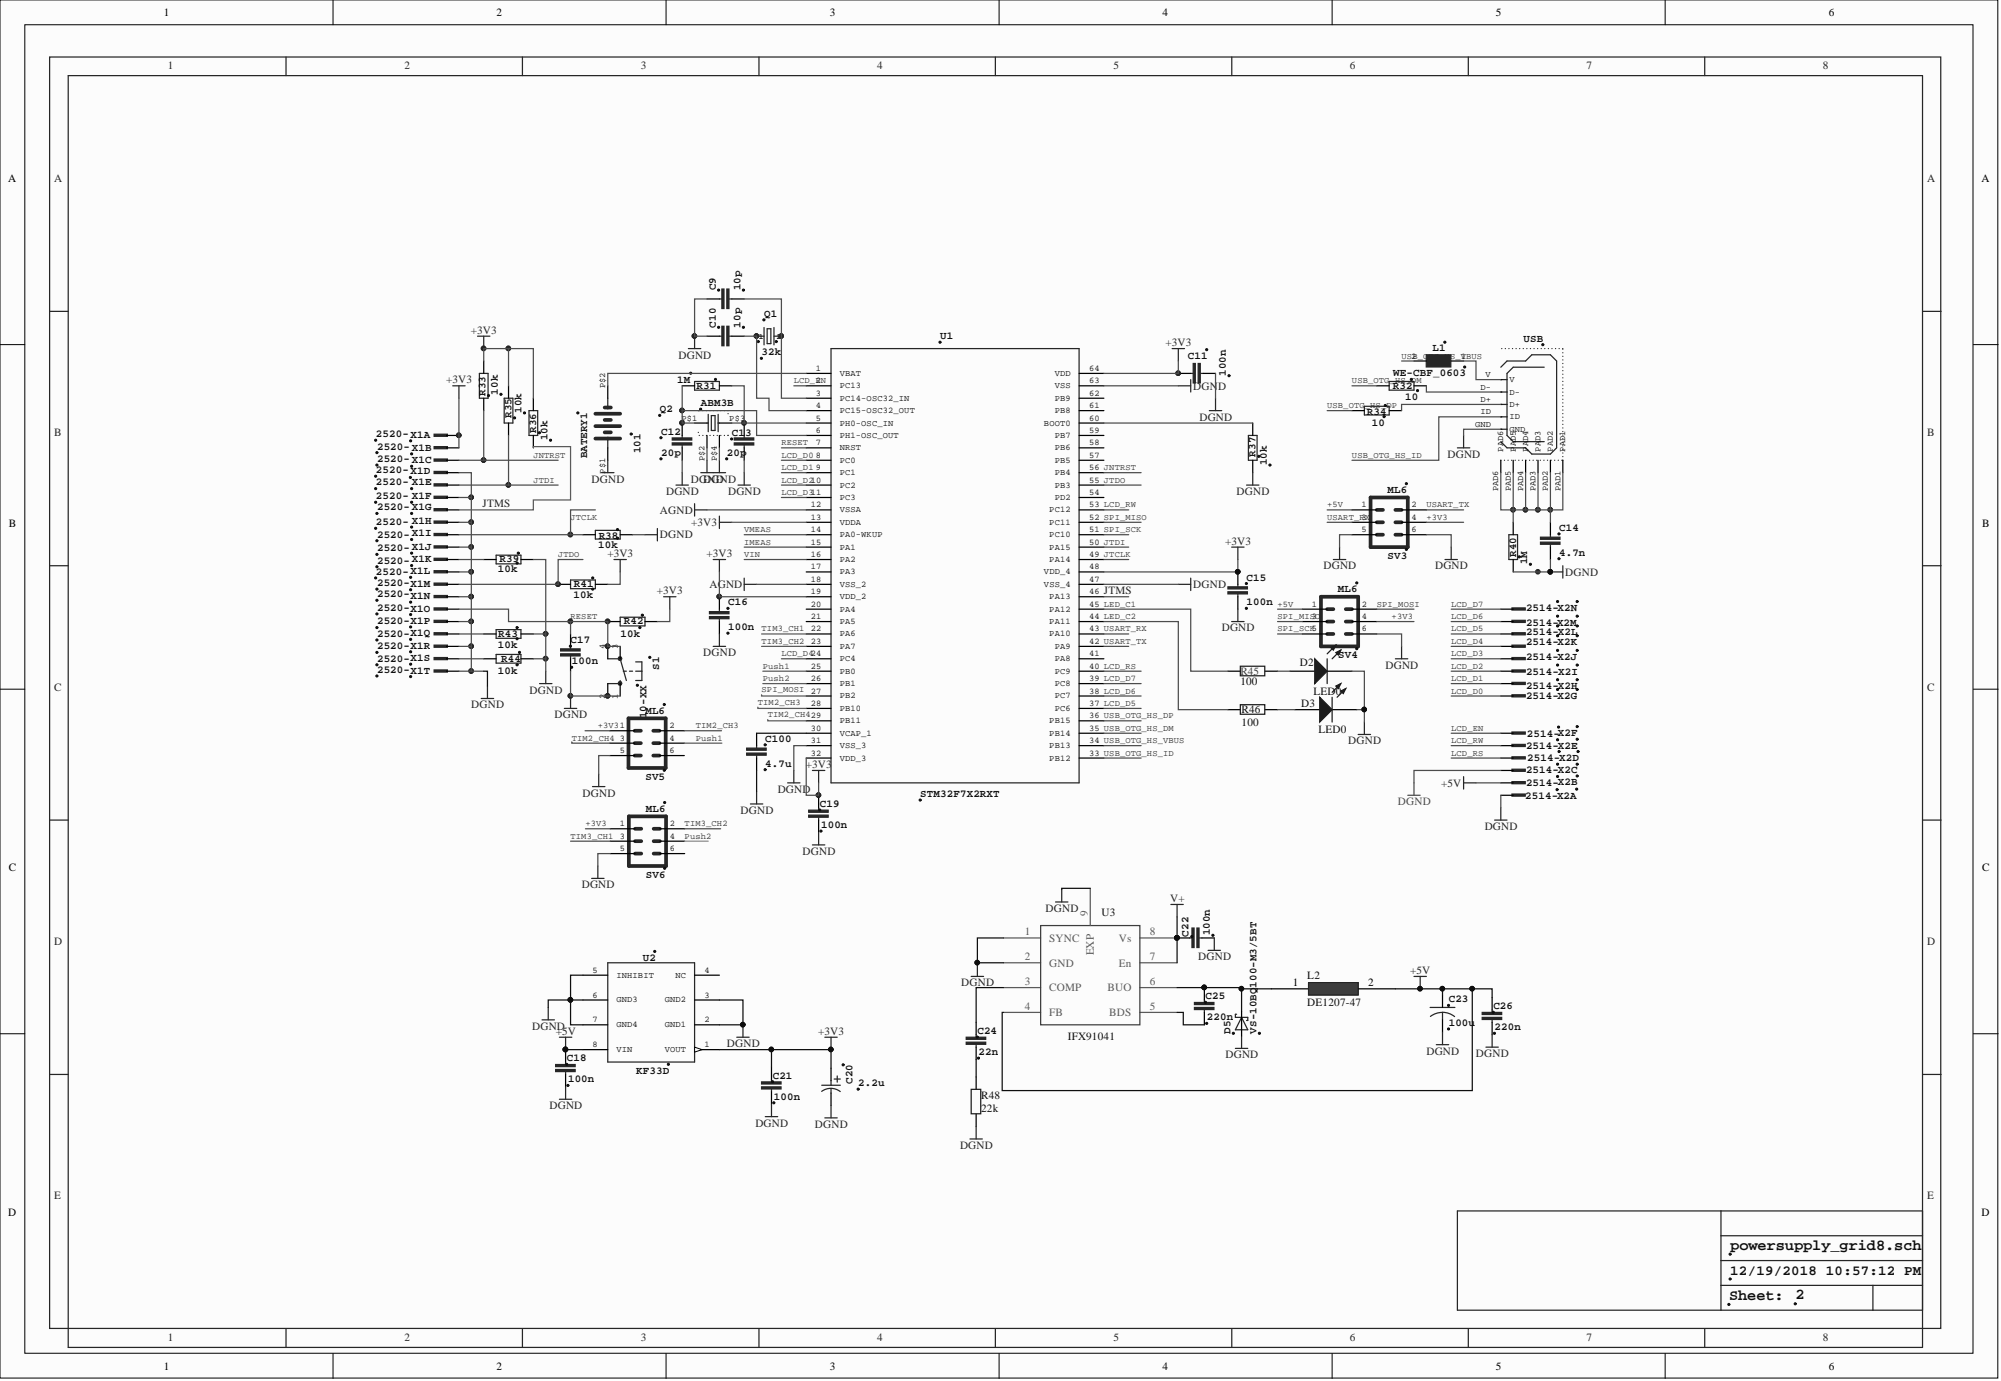
[picture p59: page 4]

LCD_EN | PC13 2

PC14-OSC32_IN 3 | D- D-10 D+ D+ USB_OTG_HS_DP

C13 | | | PH1-OSC_OUT 6

RESET | NRST 7

GND 2

GND3 6 | DGND
