bogdan-tirzioru/Powersupply/reaserch/psu-hw-master/Aux power/EEZ PSU AUX PS r5B9.pdf

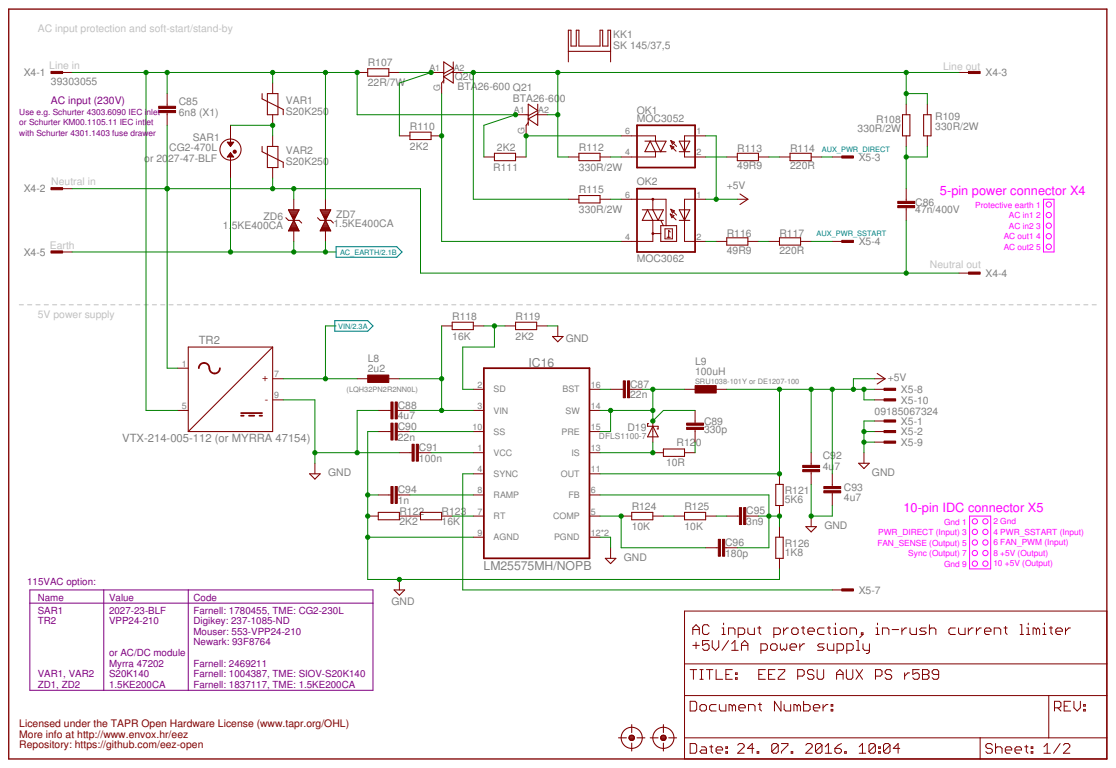
[picture p60: page 1]

AC input protection and soft-start/stand-by

BTA26-600

Use e.g. Schurter 4303.6090 IEC inlet or Schurter KM00.1105.11 IEC intlet with Schurter 4301.1403 fuse drawer

Protective earth 1 AC in1 2 5-pin power connector X4

PWR_DIRECT (Input) 3 FAN_SENSE (Output) 5 Sync (Output) 7

115VAC option: TR2 Name | Value | Code

SAR1 VAR1, VAR2 ZD1, ZD2 | 2027-23-BLF VPP24-210 or AC/DC module Myrra 47202 S20K140 1.5KE200CA | Farnell: 1780455, TME: CG2-230L Digikey: 237-1085-ND Mouser: 553-VPP24-210 Newark: 93F8764 Farnell: 2469211 Farnell: 1004387, TME: SIOV-S20K140 Farnell: 1837117, TME: 1.5KE200CA

Licensed under the TAPR Open Hardware License (www.tapr.org/OHL)
Repository: https://github.com/eez-open More info at http://www.envox.hr/eez
