bogdan-tirzioru/Powersupply/reaserch/psu-hw-master/Consolidated/EEZ PSU consolidated r5B9.pdf

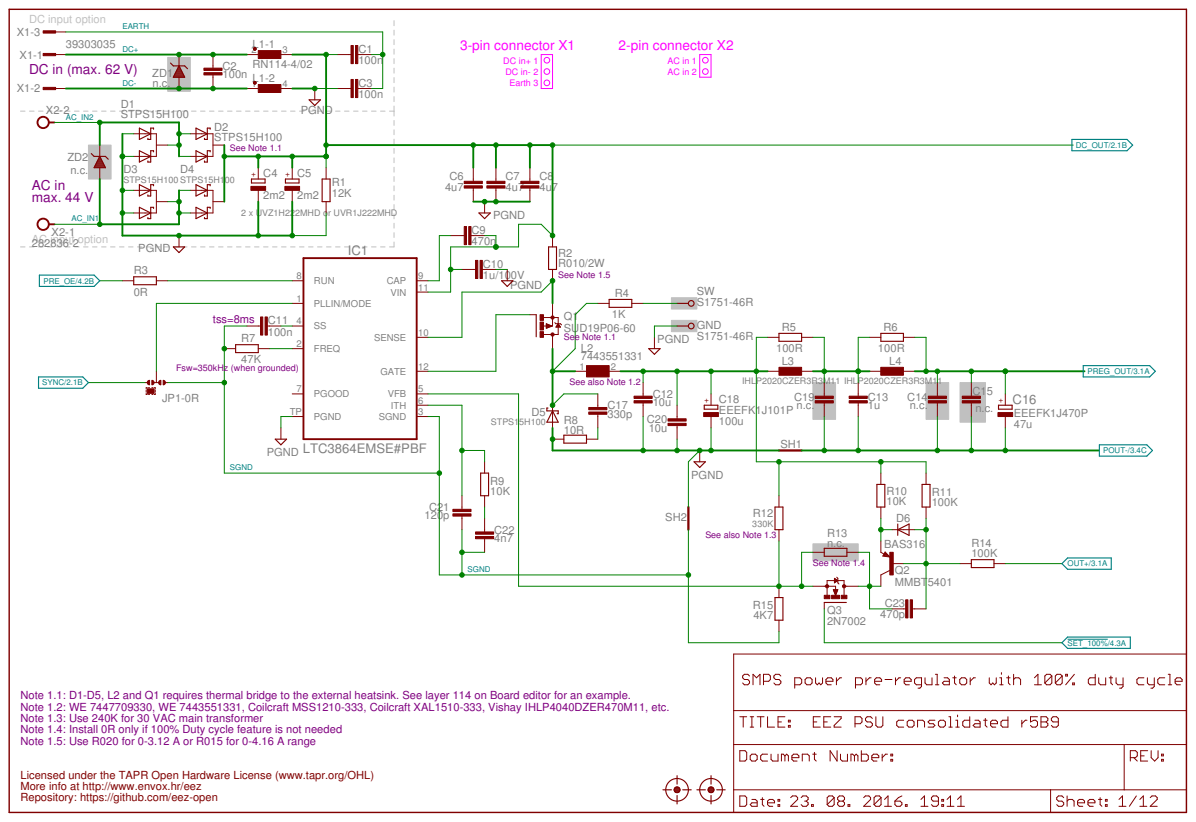
[picture p61: page 1]

DC in- 2 DC in+ 1 3-pin connector X1

Note 1.1: D1-D5, L2 and Q1 requires thermal bridge to the external heatsink. See layer 114 on Board editor for an example.
Note 1.2: WE 7447709330, WE 7443551331, Coilcraft MSS1210-333, Coilcraft XAL1510-333, Vishay IHLP4040DZER470M11, etc. Note 1.3: Use 240K for 30 VAC main transformer
Note 1.4: Install 0R only if 100% Duty cycle feature is not needed
Note 1.5: Use R020 for 0-3.12 A or R015 for 0-4.16 A range

Licensed under the TAPR Open Hardware License (www.tapr.org/OHL)
Repository: https://github.com/eez-open More info at http://www.envox.hr/eez

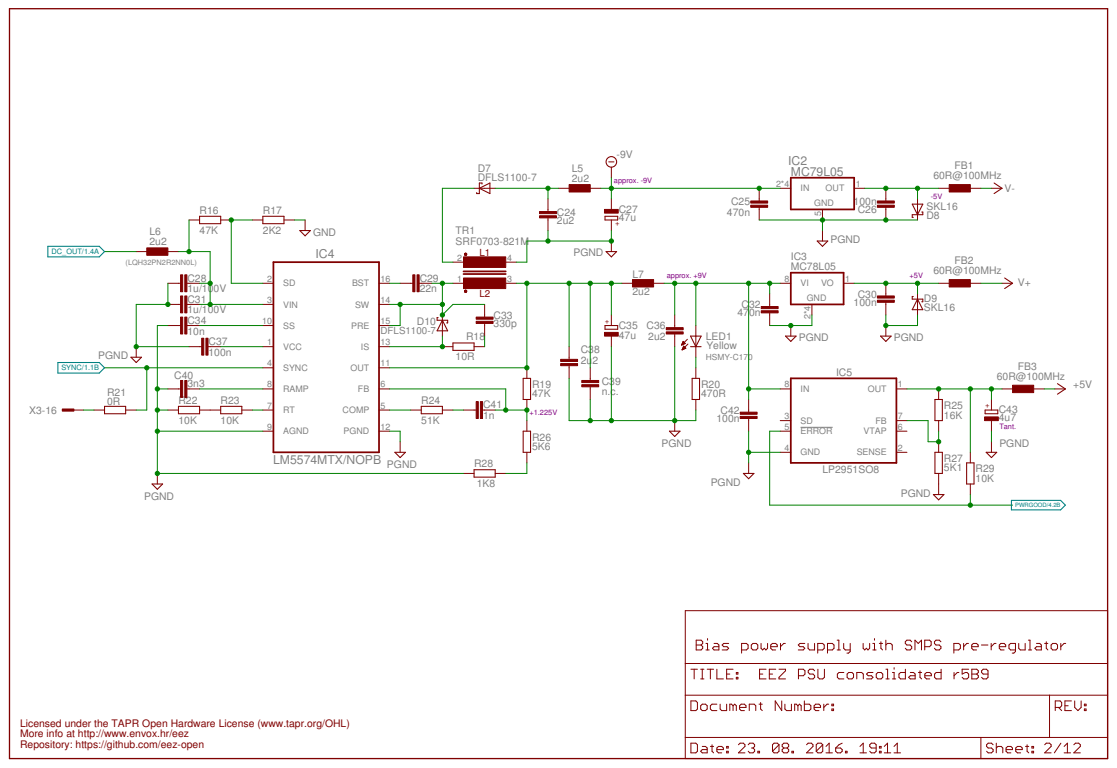
[picture p62: page 2]
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

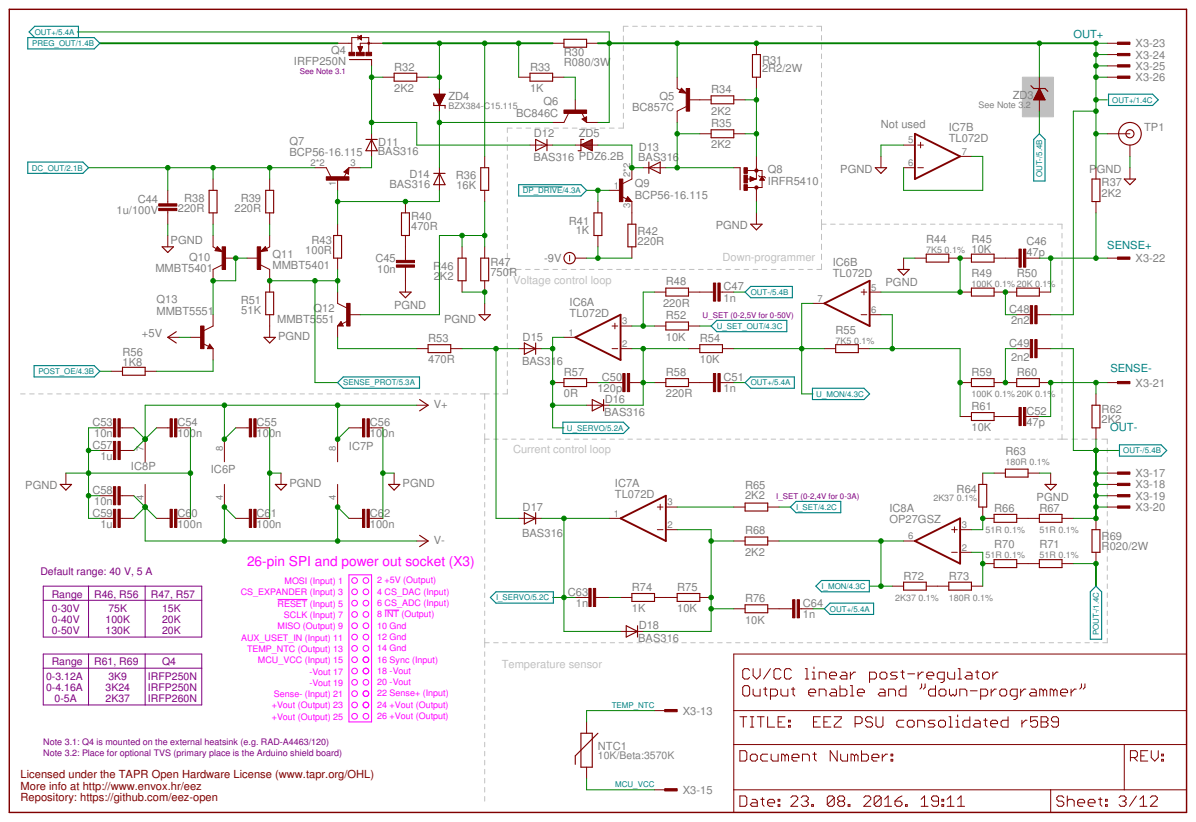
[picture p63: page 3]

18 -Vout 16 Sync (Input) 14 Gnd Sense- (Input) 21 +Vout (Output) 23 +Vout (Output) 25
-Vout 19 TEMP_NTC (Output) 13

0-3.12A 0-4.16A 0-5A | 3K9 3K24 2K37 | IRFP250N IRFP250N IRFP260N

24 +Vout (Output) 26 +Vout (Output) 22 Sense+ (Input) 20 -Vout

Note 3.1: Q4 is mounted on the external heatsink (e.g. RAD-A4463/120)
Note 3.2: Place for optional TVS (primary place is the Arduino shield board)
Licensed under the TAPR Open Hardware License (www.tapr.org/OHL)
Repository: https://github.com/eez-open More info at http://www.envox.hr/eez

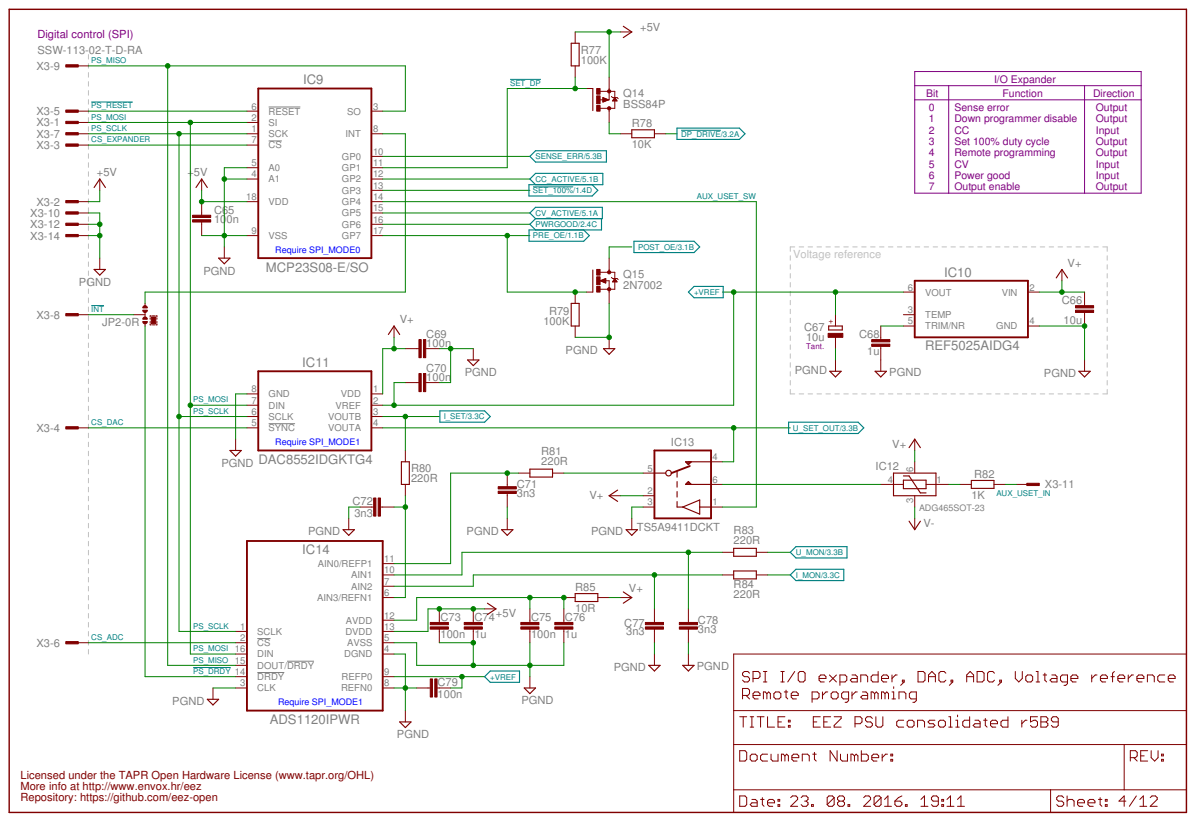
[picture p64: page 4]

Down programmer disable CC
Set 100% duty cycle Remote programming
Power good
Output enable

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

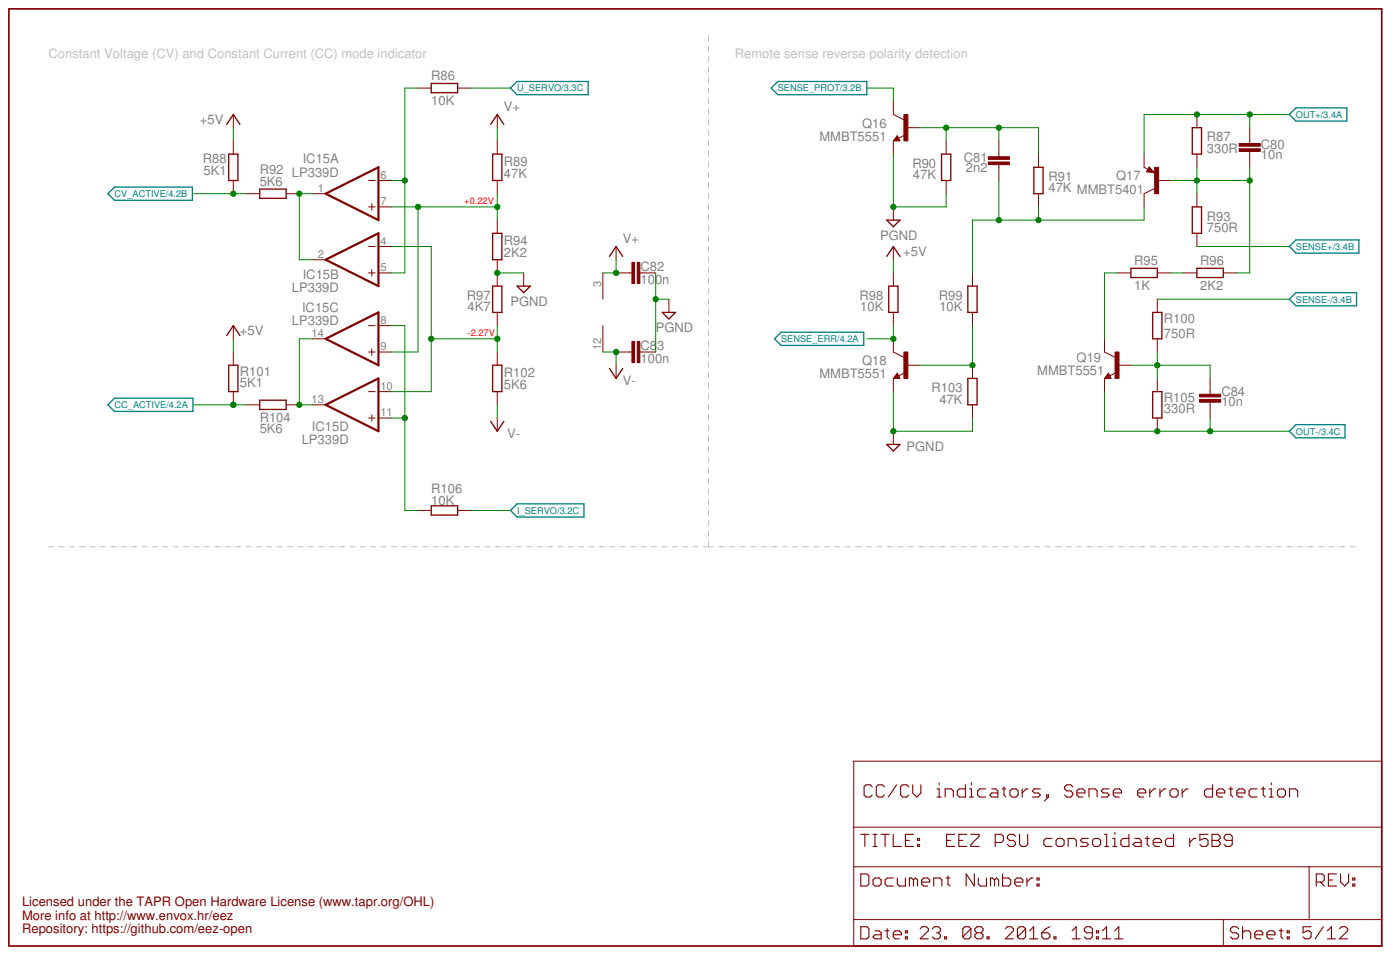
[picture p65: page 5]
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

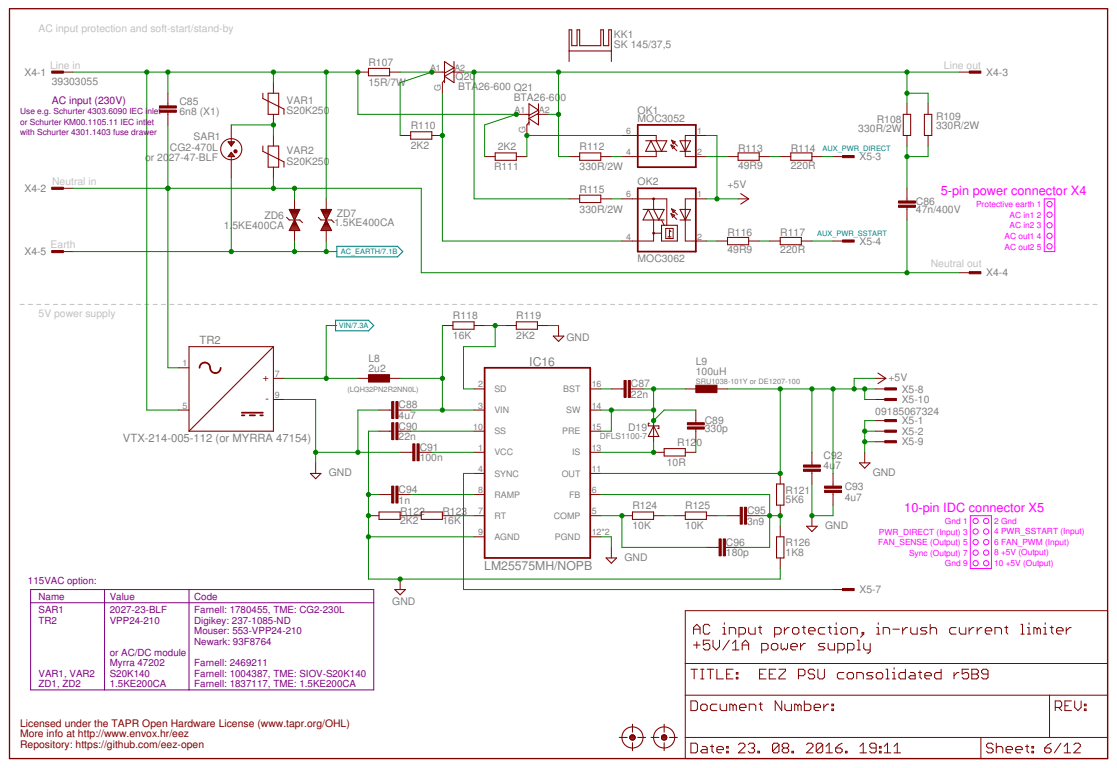
[picture p66: page 6]

AC input protection and soft-start/stand-by

BTA26-600

Use e.g. Schurter 4303.6090 IEC inlet or Schurter KM00.1105.11 IEC intlet with Schurter 4301.1403 fuse drawer

Protective earth 1 AC in1 2 5-pin power connector X4

PWR_DIRECT (Input) 3 FAN_SENSE (Output) 5 Sync (Output) 7

115VAC option: TR2 Name | Value | Code

SAR1 VAR1, VAR2 ZD1, ZD2 | 2027-23-BLF VPP24-210 or AC/DC module Myrra 47202 S20K140 1.5KE200CA | Farnell: 1780455, TME: CG2-230L Digikey: 237-1085-ND Mouser: 553-VPP24-210 Newark: 93F8764 Farnell: 2469211 Farnell: 1004387, TME: SIOV-S20K140 Farnell: 1837117, TME: 1.5KE200CA

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

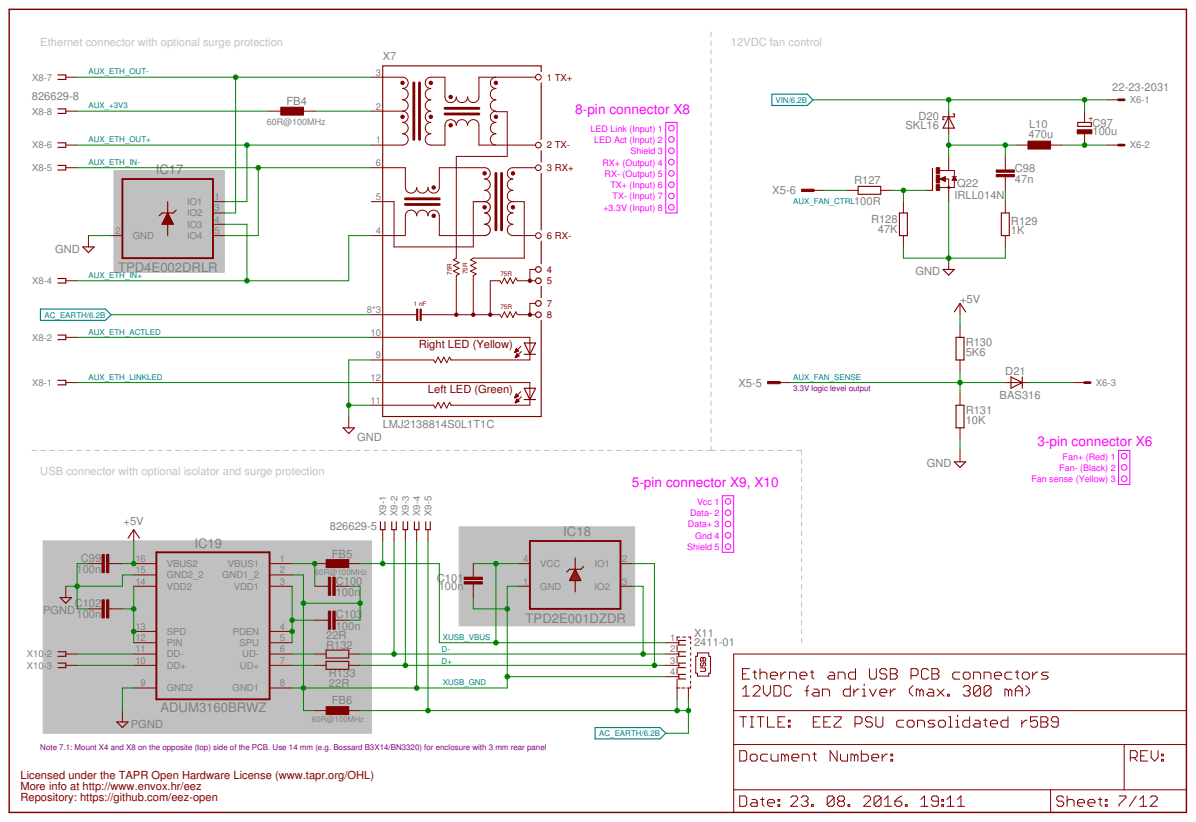
[picture p67: page 7]

LED Link (Input) 1
LED Act (Input) 2 RX+ (Output) 4 RX- (Output) 5 Shield 3

Fan- (Black) 2 Fan+ (Red) 1 3-pin connector X6

USB connector with optional isolator and surge protection

Shield 5 Vcc 1 Data+ 3 Gnd 4

8 | | XUSB_GND

PGND | FB6

Note 7.1: Mount X4 and X8 on the opposite (top) side of the PCB. Use 14 mm (e.g. Bossard B3X14/BN3320) for enclosure with 3 mm rear panel
Licensed under the TAPR Open Hardware License (www.tapr.org/OHL)
Repository: https://github.com/eez-open More info at http://www.envox.hr/eez

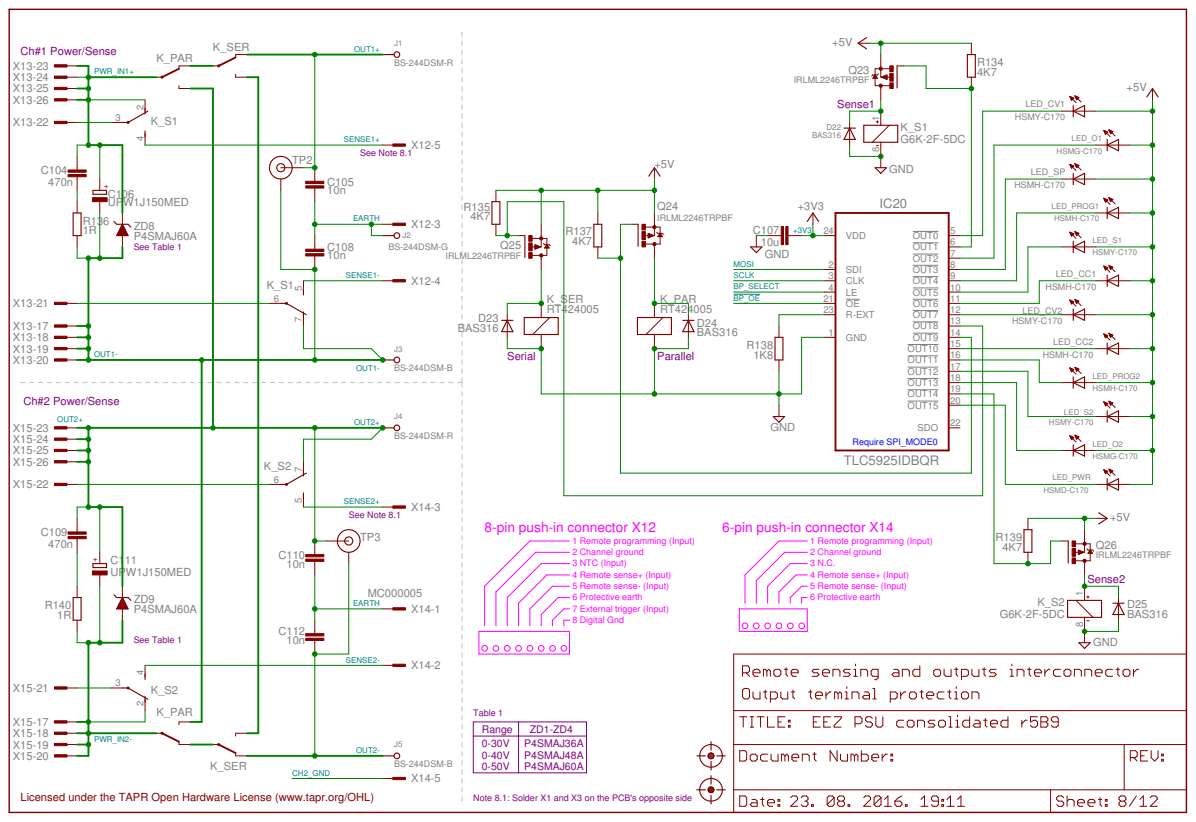
[picture p68: page 8]

8-pin push-in connector X12

1 Remote programming (Input)
5 Remote sense- (Input) 2 Channel ground

3 NTC (Input)
4 Remote sense+ (Input) 6 Protective earth

7 External trigger (Input) 8 Digital Gnd

Range | ZD1-ZD4
0-30V 0-40V 0-50V | P4SMAJ36A P4SMAJ48A P4SMAJ60A

Licensed under the TAPR Open Hardware License (www.tapr.org/OHL)

Note 8.1: Solder X1 and X3 on the PCB's opposite side

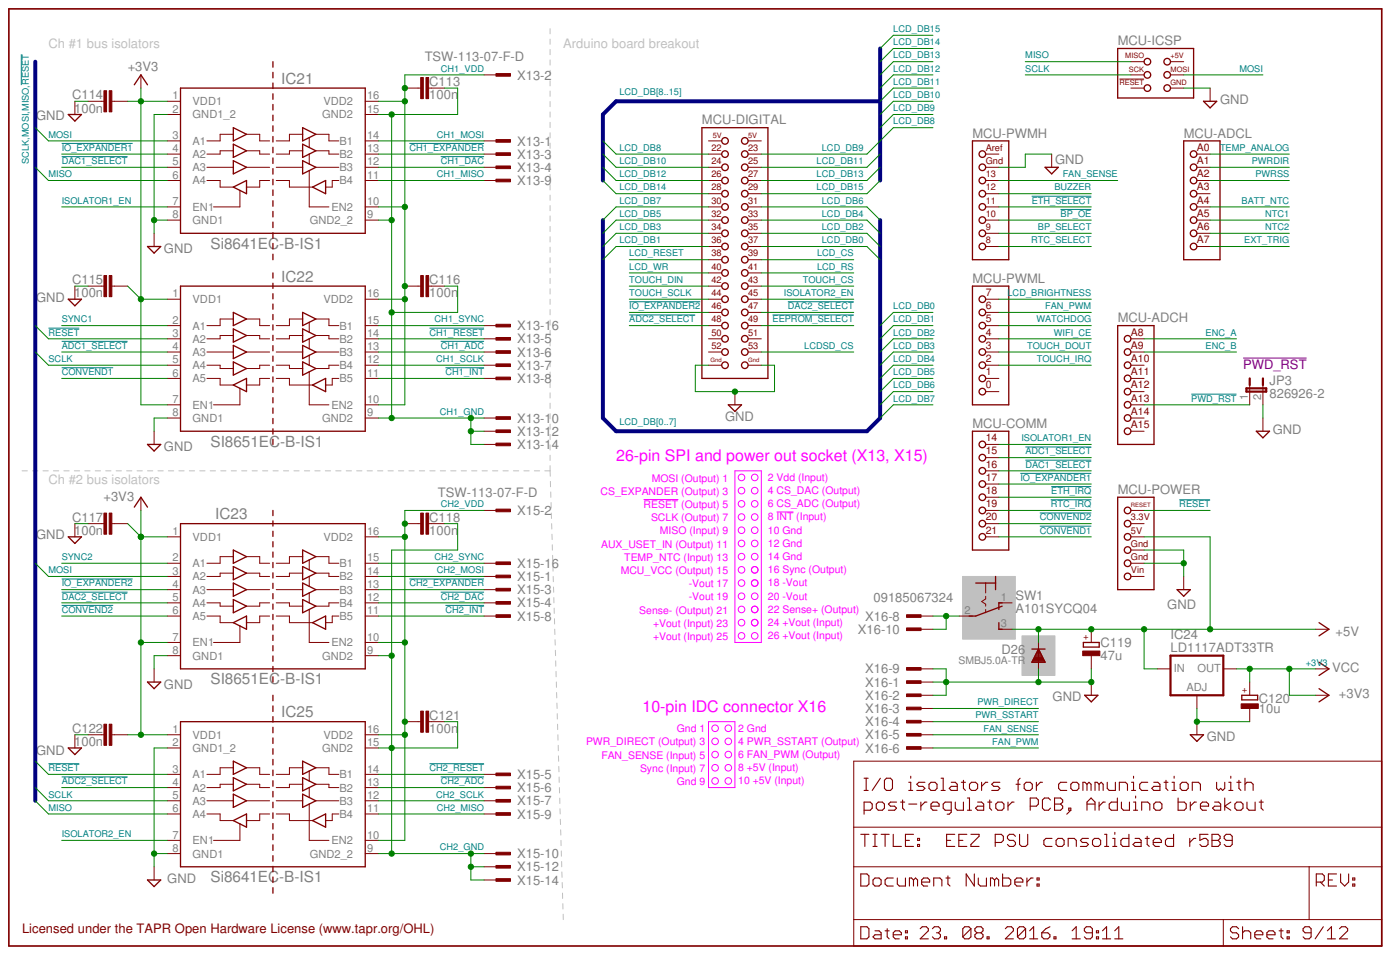
[picture p69: page 9]

SCLK,MOSI,MISO,RESET

2 Vdd (Input) SCLK (Output) 7

18 -Vout 16 Sync (Output) 14 Gnd

24 +Vout (Input) 26 +Vout (Input) 22 Sense+ (Output) 20 -Vout

Sense- (Output) 21 +Vout (Input) 23 +Vout (Input) 25

IC24 LD1117ADT33TR

PWR_DIRECT (Output) 3 FAN_SENSE (Input) 5 10-pin IDC connector X16

Licensed under the TAPR Open Hardware License (www.tapr.org/OHL)

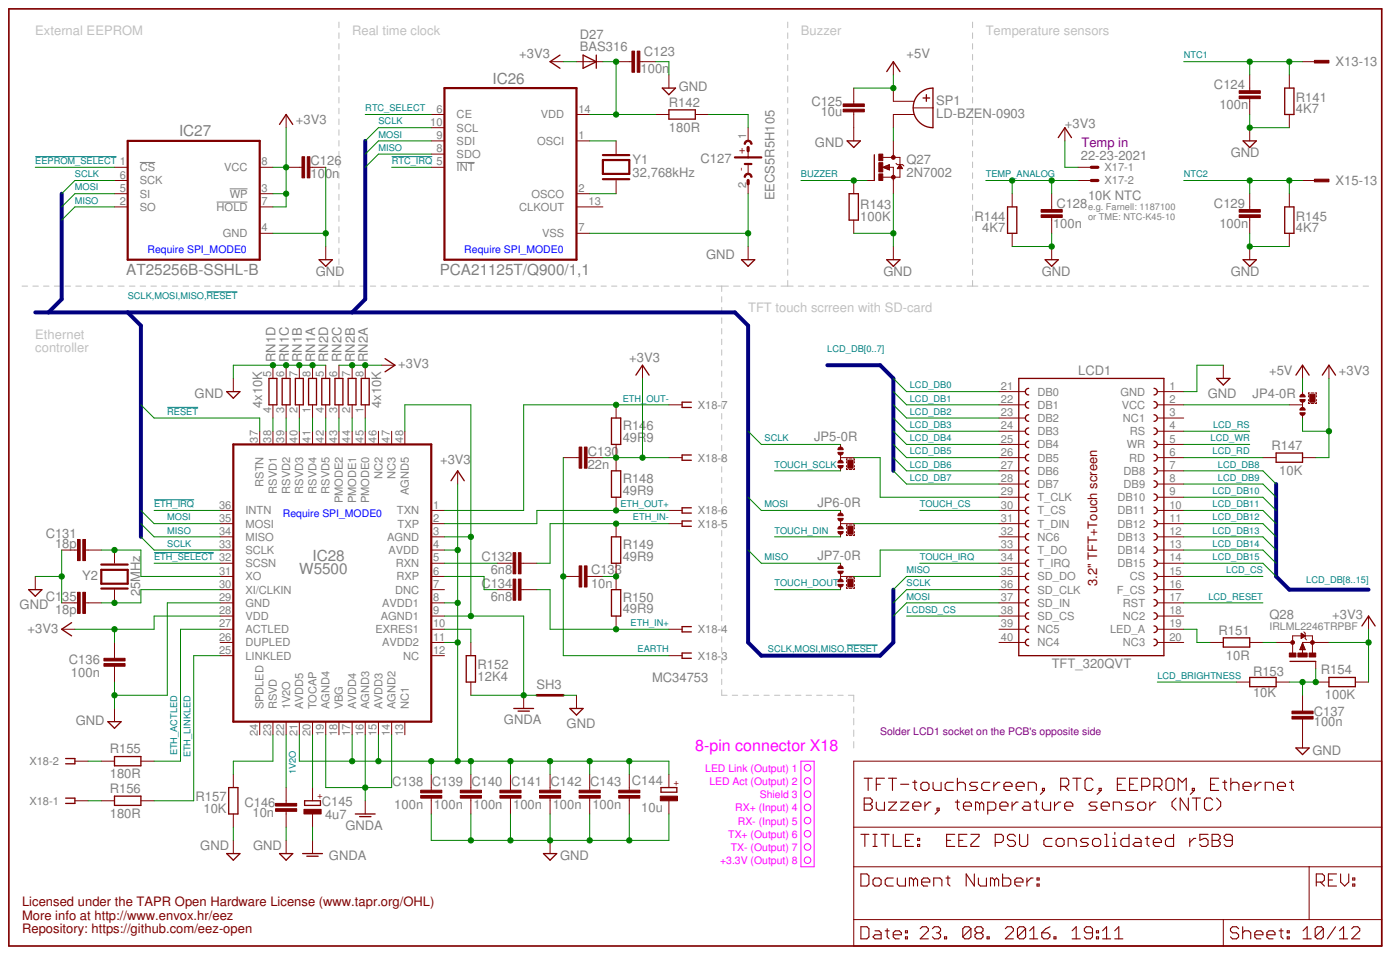
[picture p70: page 10]

SCLK,MOSI,MISO,RESET

TFT touch scrreen with SD-card

Solder LCD1 socket on the PCB's opposite side

LED Link (Output) 1
LED Act (Output) 2 RX+ (Input) 4 RX- (Input) 5 Shield 3

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

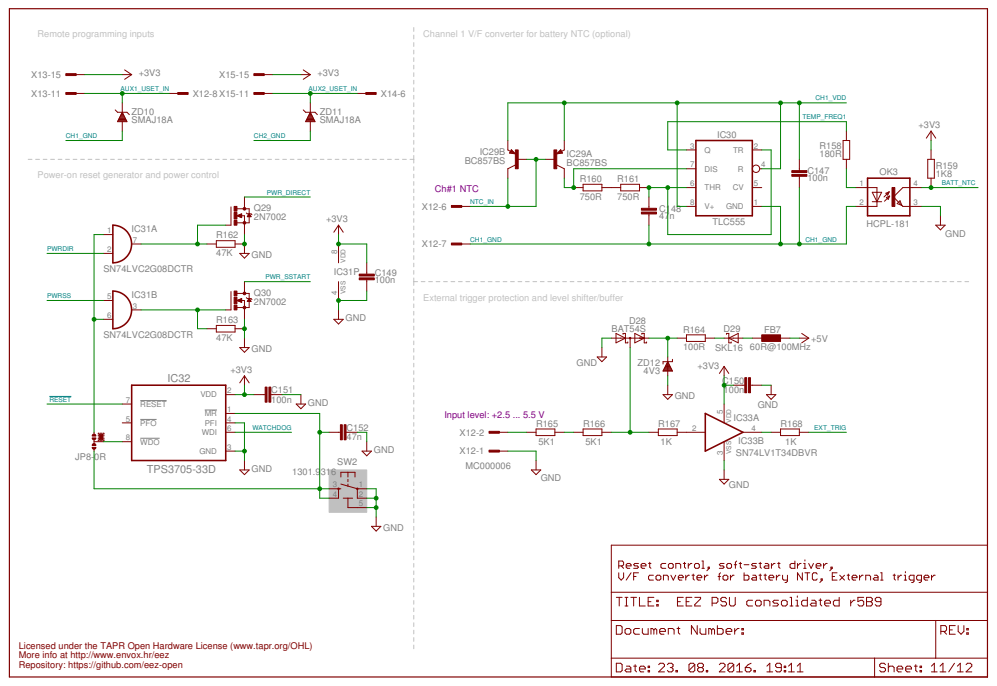
[picture p71: page 11]

Channel 1 V/F converter for battery NTC (optional)

TEMP_FREQ1

Power-on reset generator and power control

External trigger protection and level shifter/buffer

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

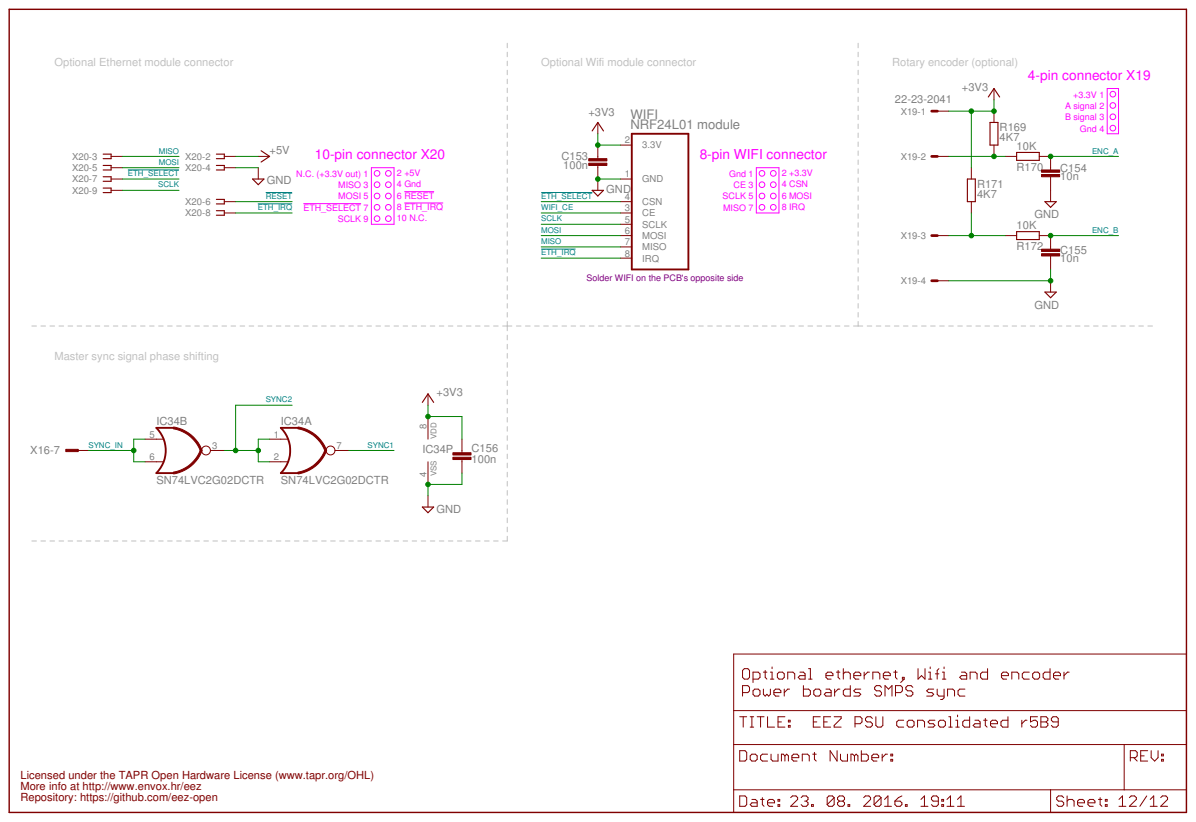
[picture p72: page 12]

N.C. (+3.3V out) 1 MISO 3 10-pin connector X20

Solder WIFI on the PCB's opposite side

Master sync signal phase shifting

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
