bogdan-tirzioru/Powersupply/reaserch/psu-hw-master/Power board/EEZ PSU power board r5B9.pdf

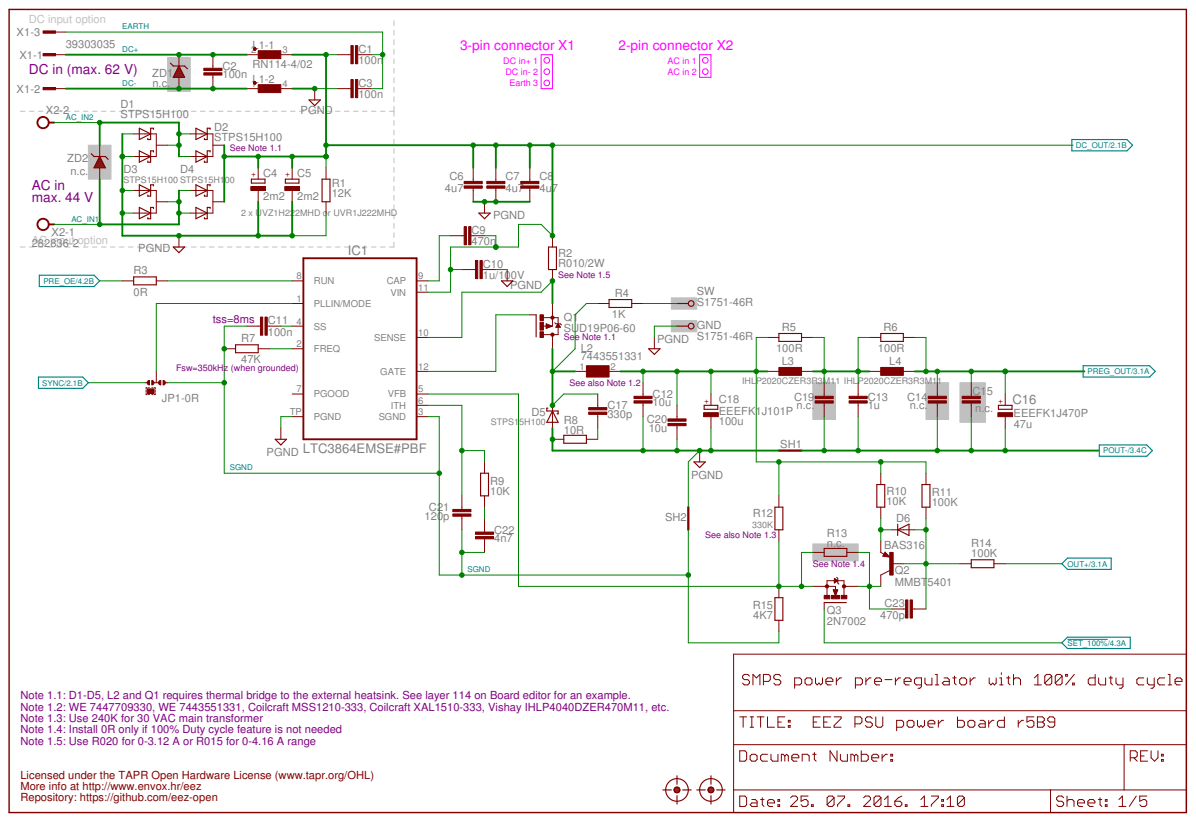
[picture p73: page 1]

DC in- 2 DC in+ 1 3-pin connector X1

Note 1.1: D1-D5, L2 and Q1 requires thermal bridge to the external heatsink. See layer 114 on Board editor for an example.
Note 1.2: WE 7447709330, WE 7443551331, Coilcraft MSS1210-333, Coilcraft XAL1510-333, Vishay IHLP4040DZER470M11, etc. Note 1.3: Use 240K for 30 VAC main transformer
Note 1.4: Install 0R only if 100% Duty cycle feature is not needed
Note 1.5: Use R020 for 0-3.12 A or R015 for 0-4.16 A range

Licensed under the TAPR Open Hardware License (www.tapr.org/OHL)
Repository: https://github.com/eez-open More info at http://www.envox.hr/eez

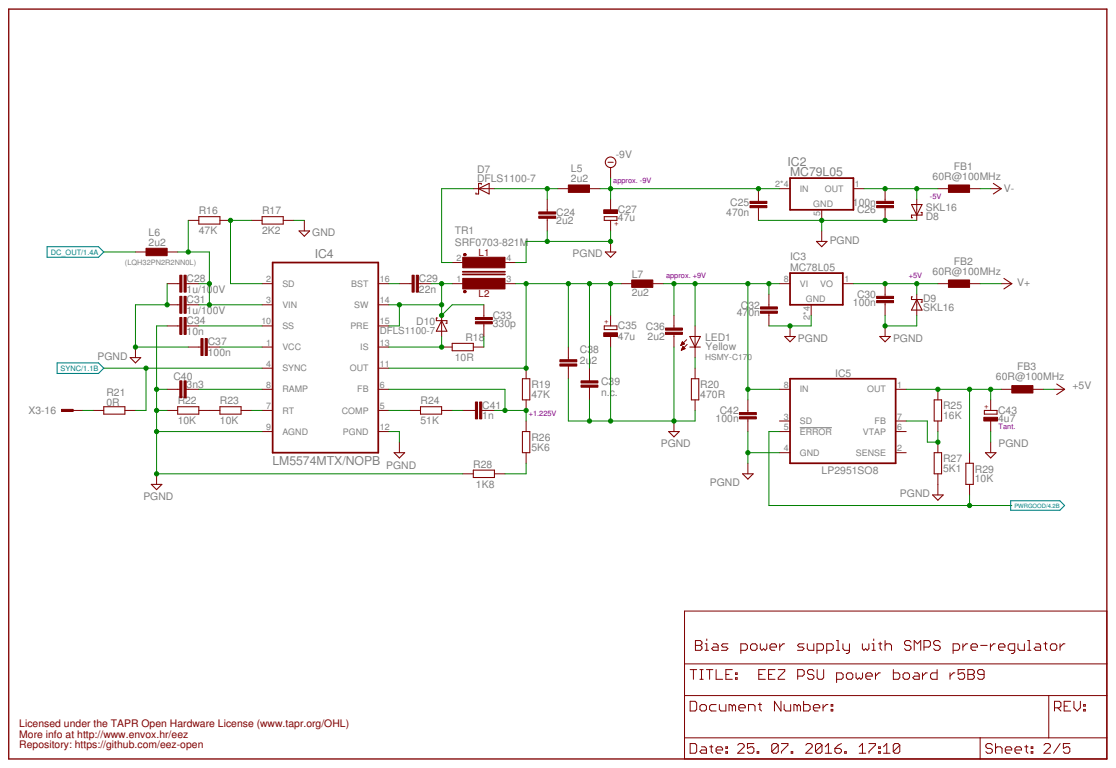
[picture p74: page 2]
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

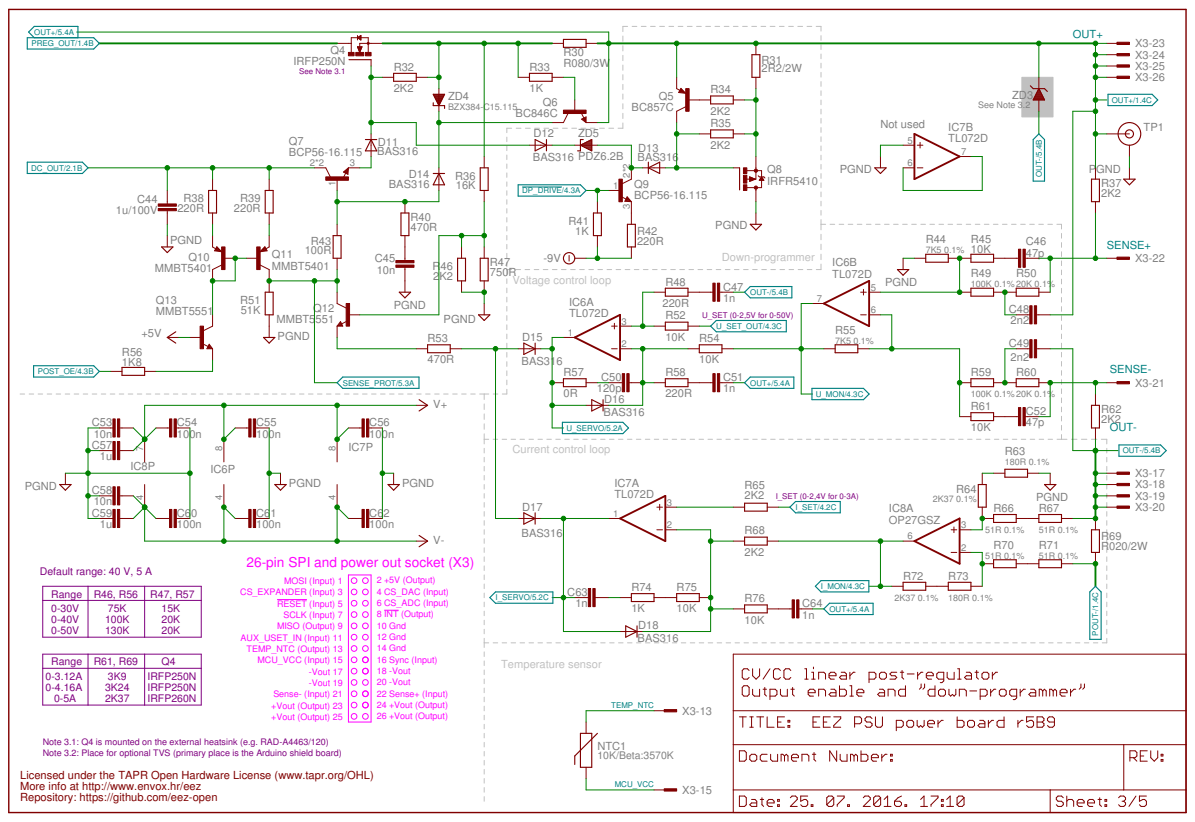
[picture p75: page 3]

18 -Vout 16 Sync (Input) 14 Gnd Sense- (Input) 21 +Vout (Output) 23 +Vout (Output) 25
-Vout 19 TEMP_NTC (Output) 13

0-3.12A 0-4.16A 0-5A | 3K9 3K24 2K37 | IRFP250N IRFP250N IRFP260N

24 +Vout (Output) 26 +Vout (Output) 22 Sense+ (Input) 20 -Vout

Note 3.1: Q4 is mounted on the external heatsink (e.g. RAD-A4463/120)
Note 3.2: Place for optional TVS (primary place is the Arduino shield board)
Licensed under the TAPR Open Hardware License (www.tapr.org/OHL)
Repository: https://github.com/eez-open More info at http://www.envox.hr/eez

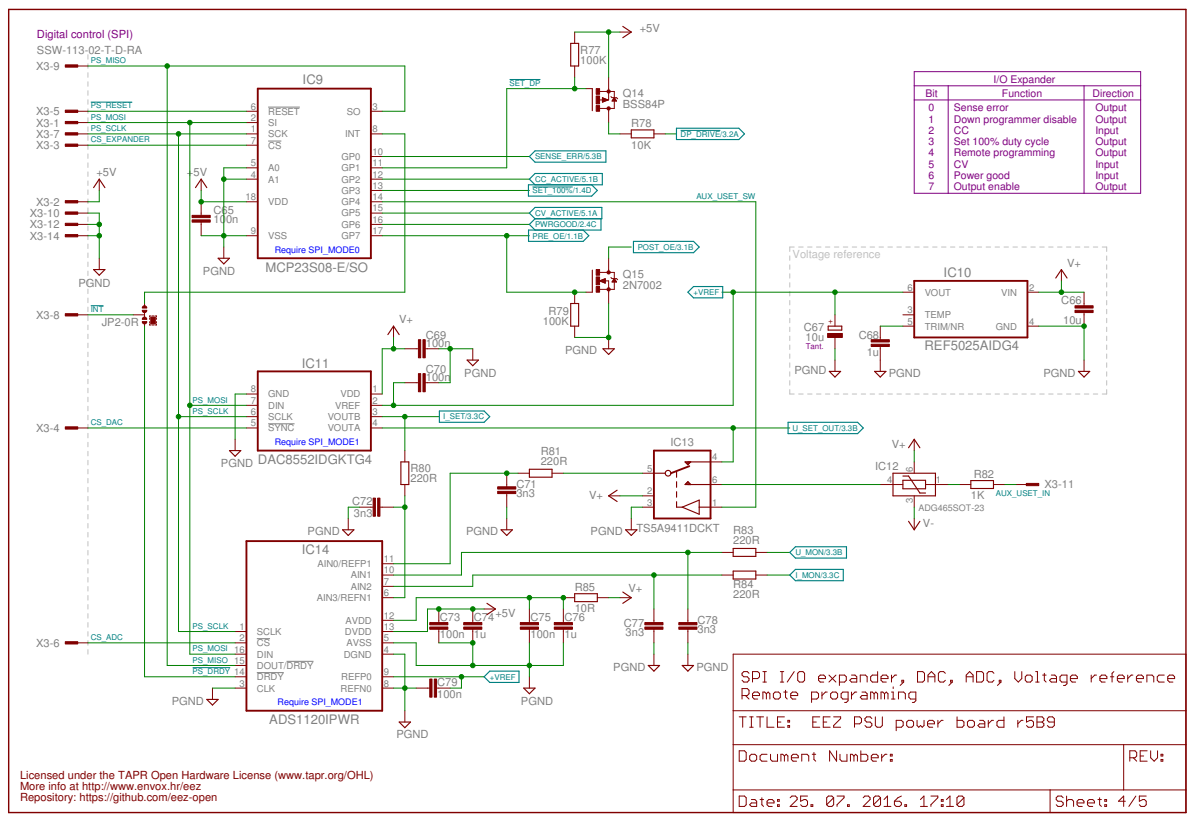
[picture p76: page 4]

Down programmer disable CC
Set 100% duty cycle Remote programming
Power good
Output enable

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

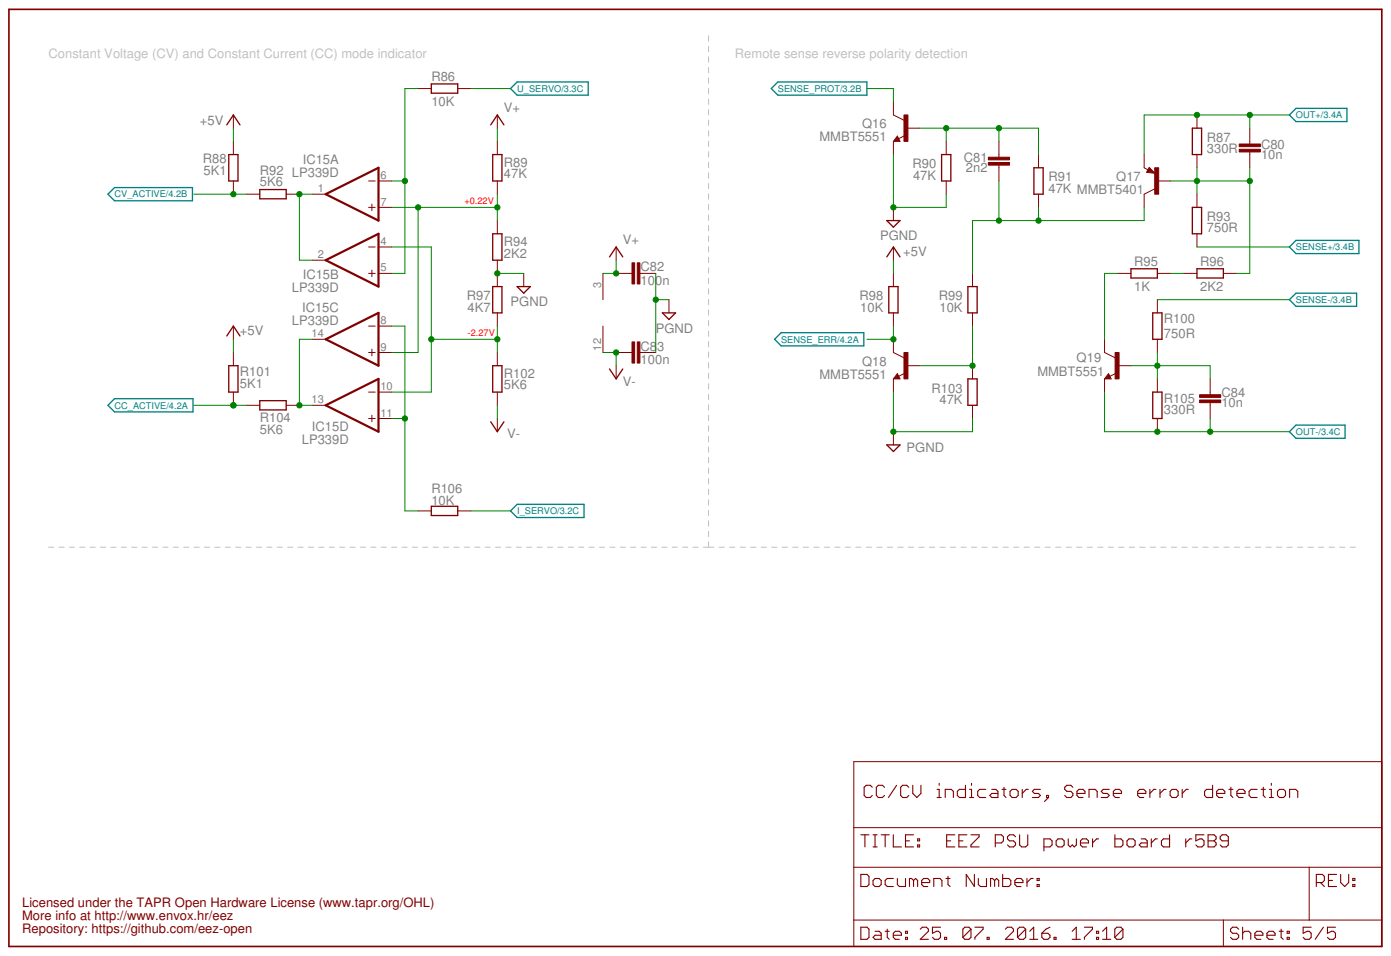
[picture p77: page 5]
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
