bogdan-tirzioru/Powersupply/shopping_card/Farnell element14powersupply.pdf

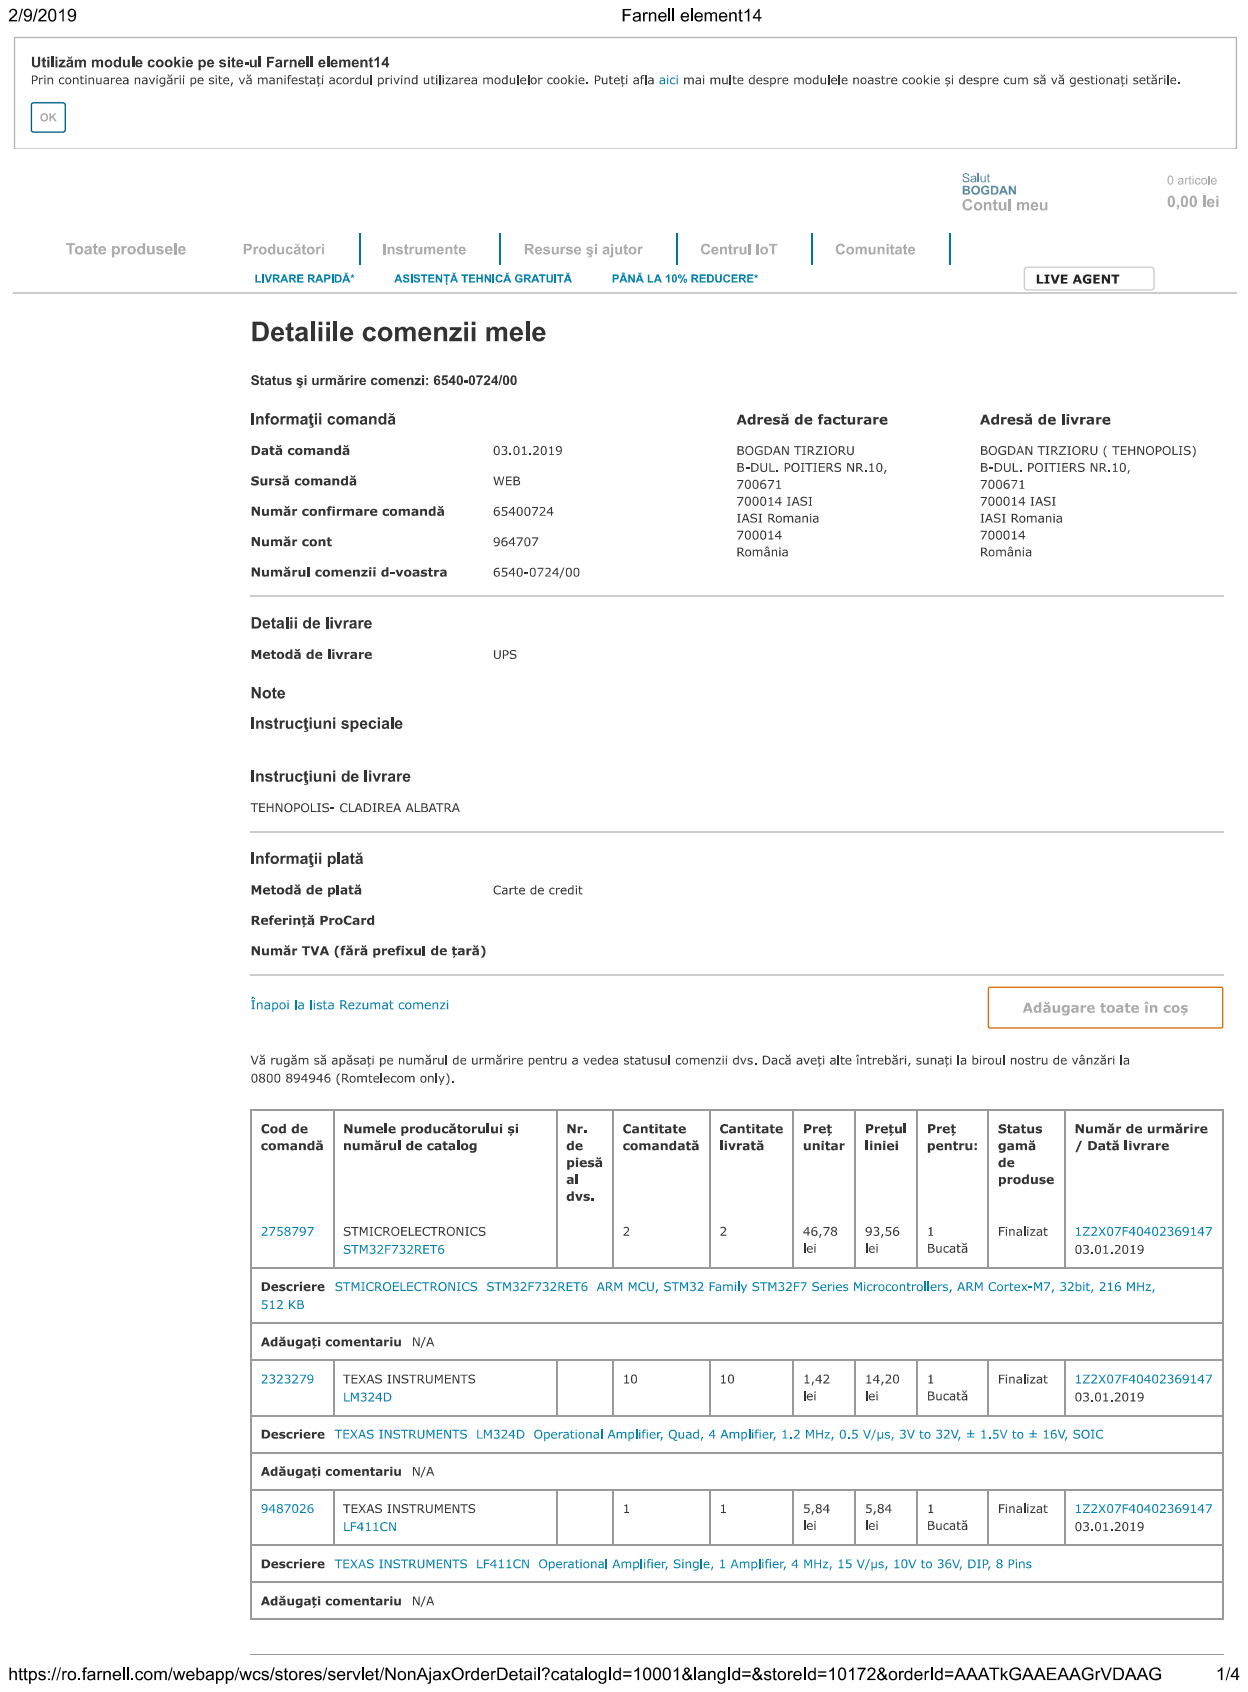
[picture p78: page 1]

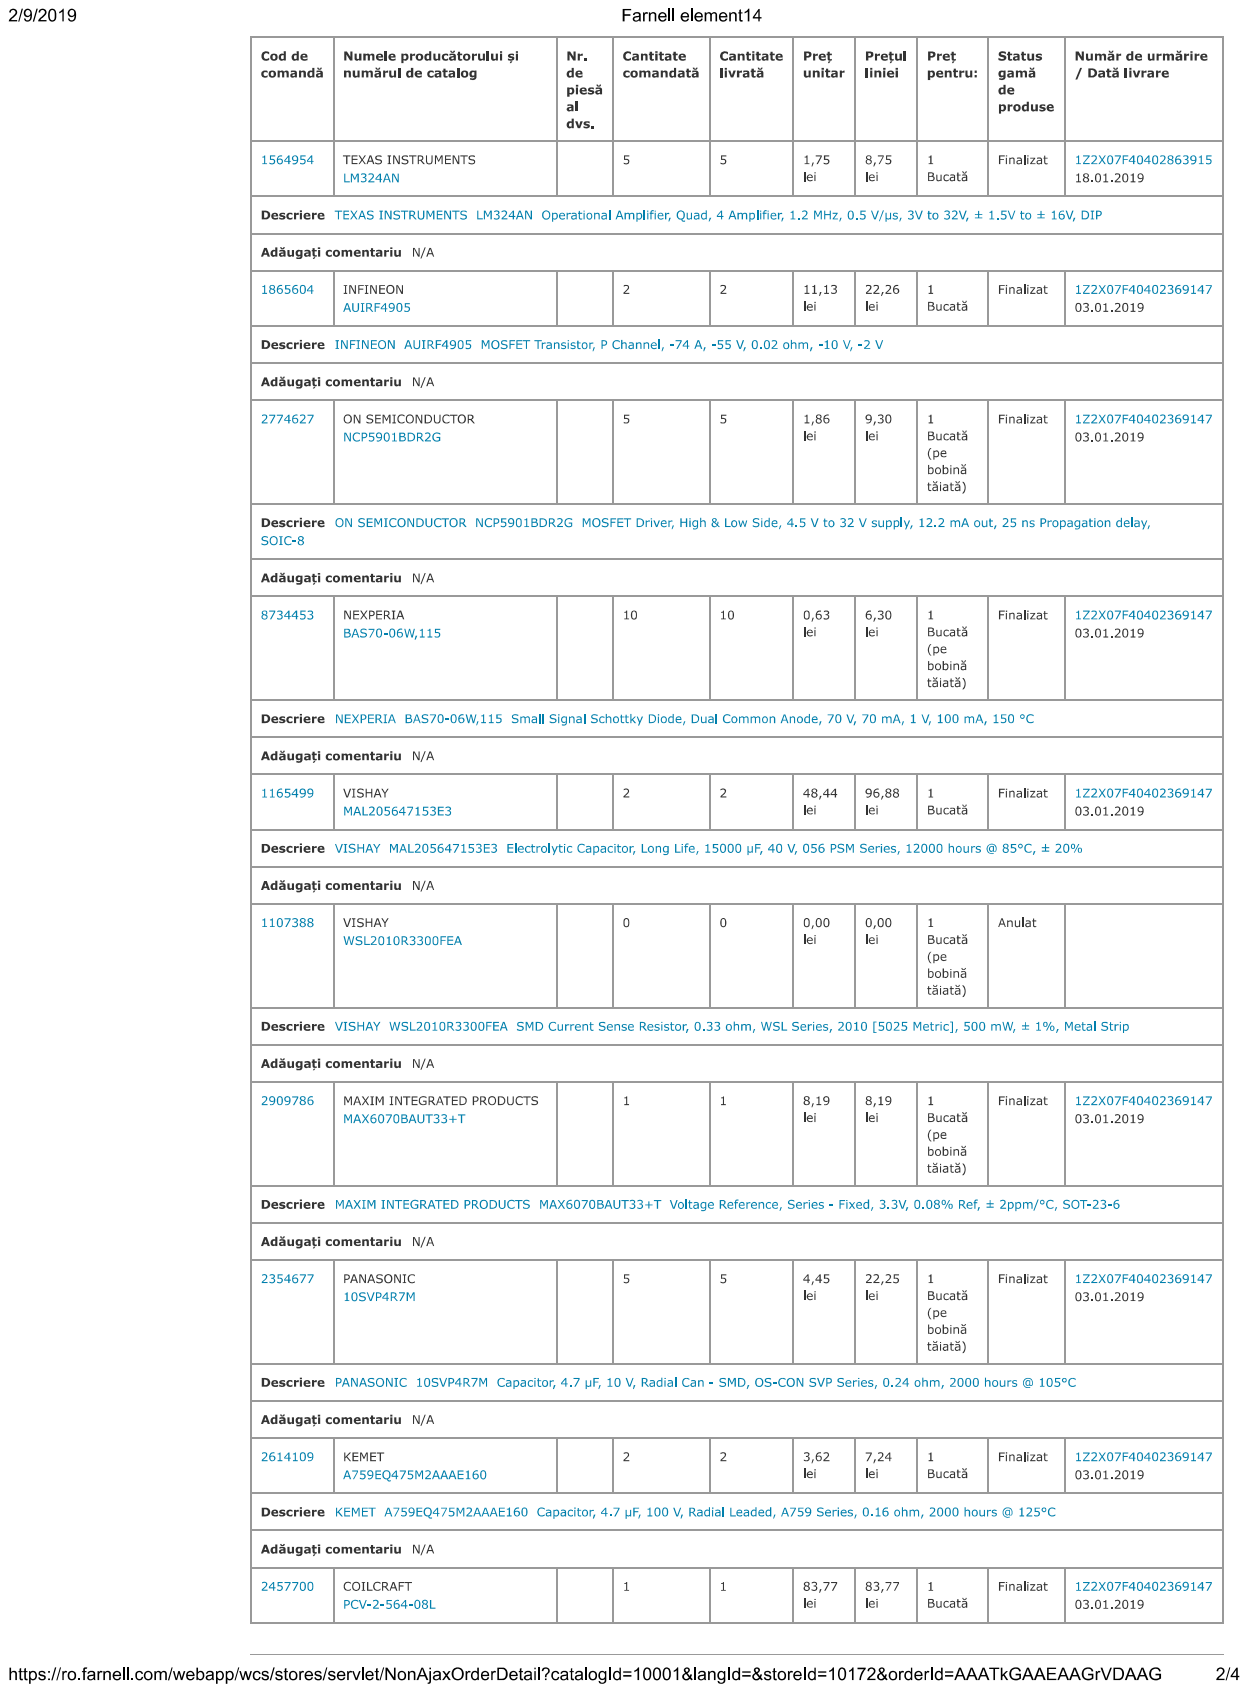
[picture p79: page 2]

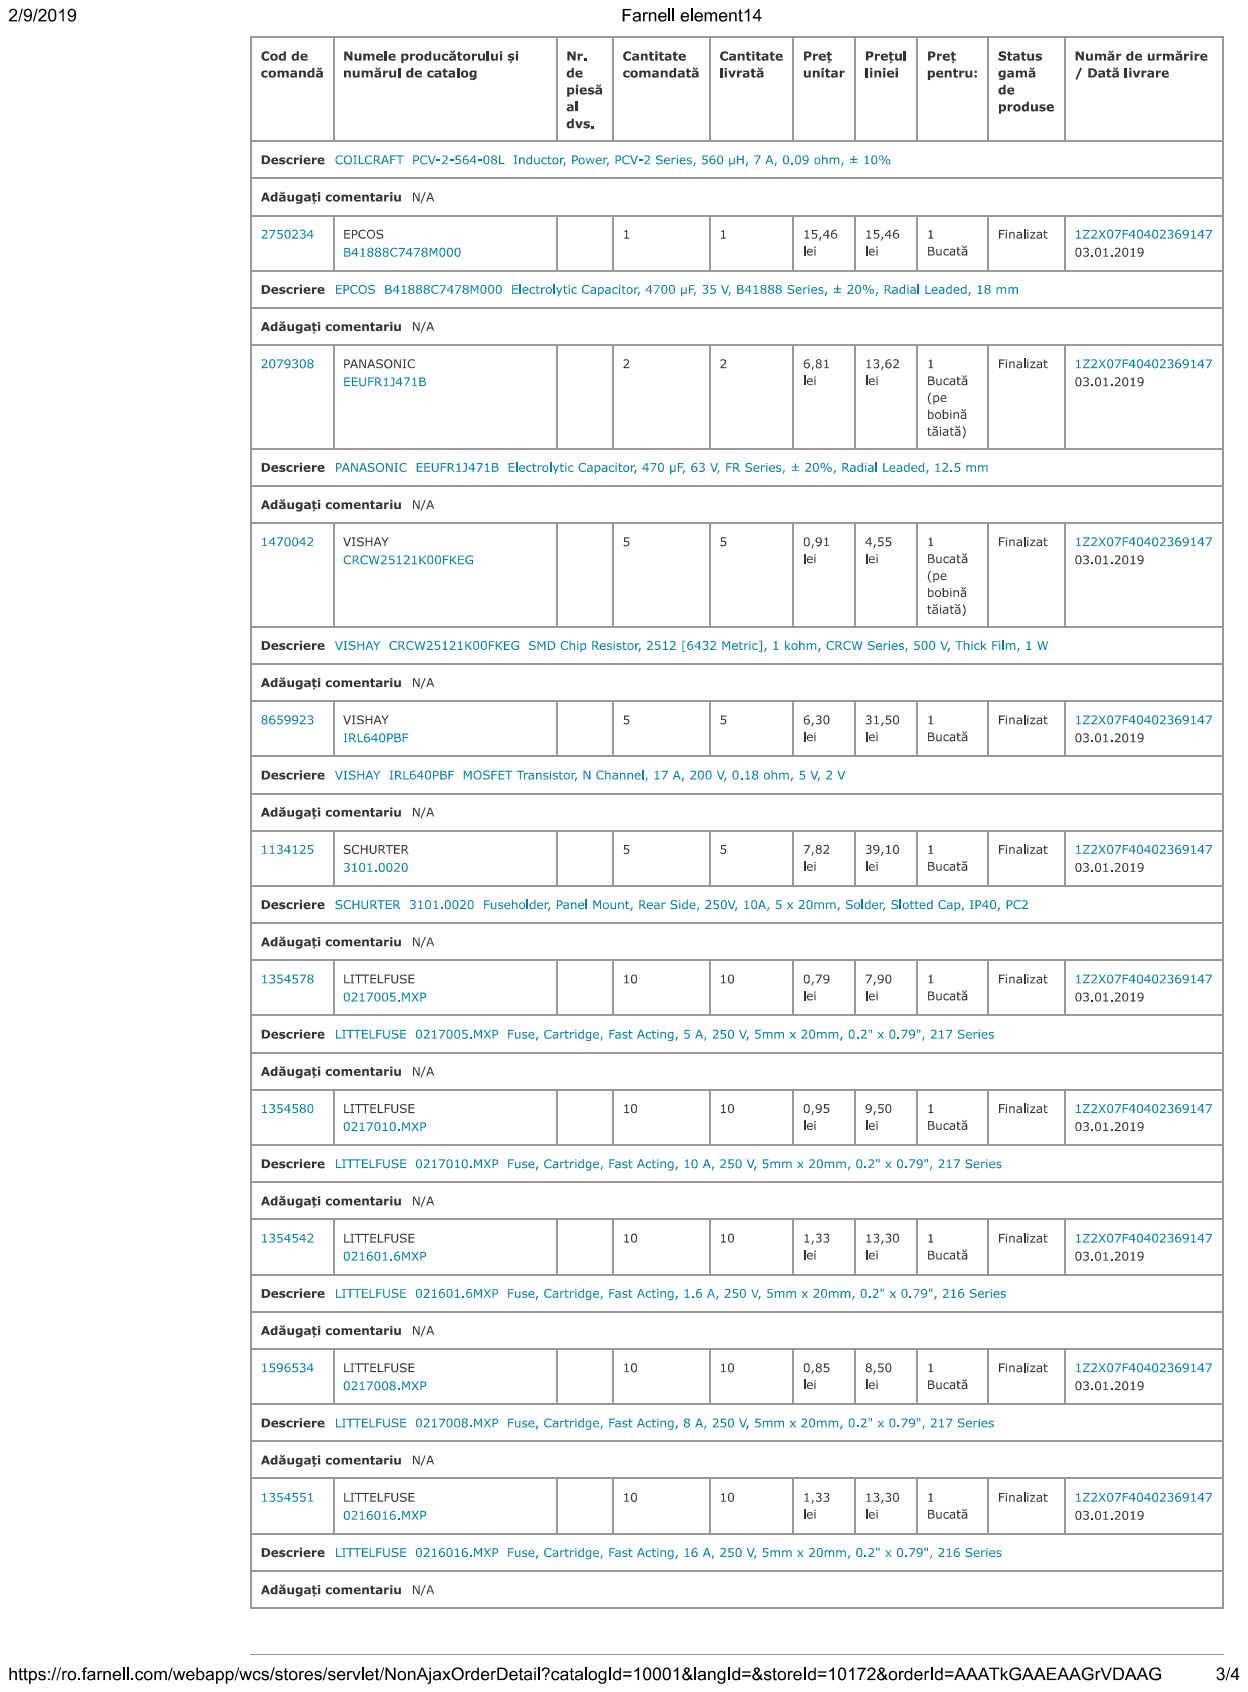
[picture p80: page 3]

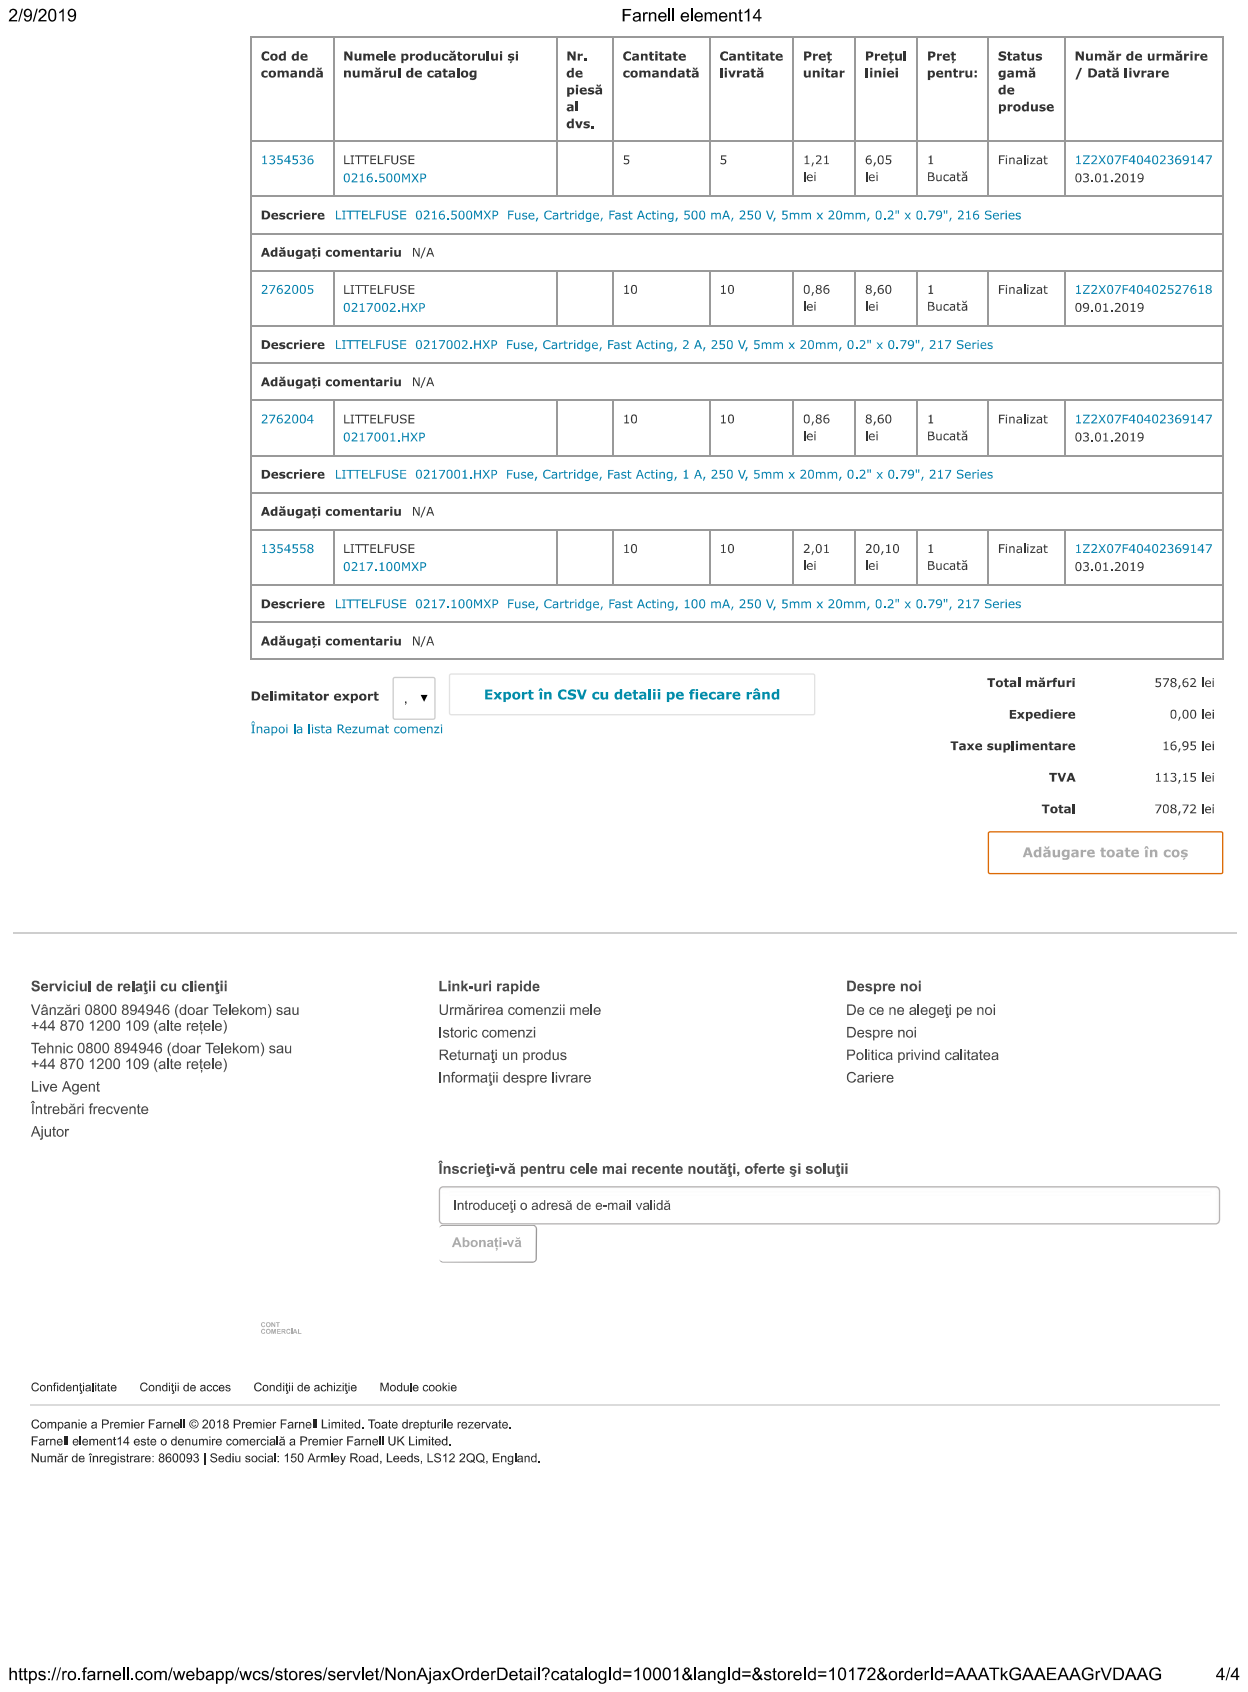
[picture p81: page 4]
