bogdan-tirzioru/Powersupply/reaserch/ourdev_641803UM8FLW.pdf

IC21

IC18

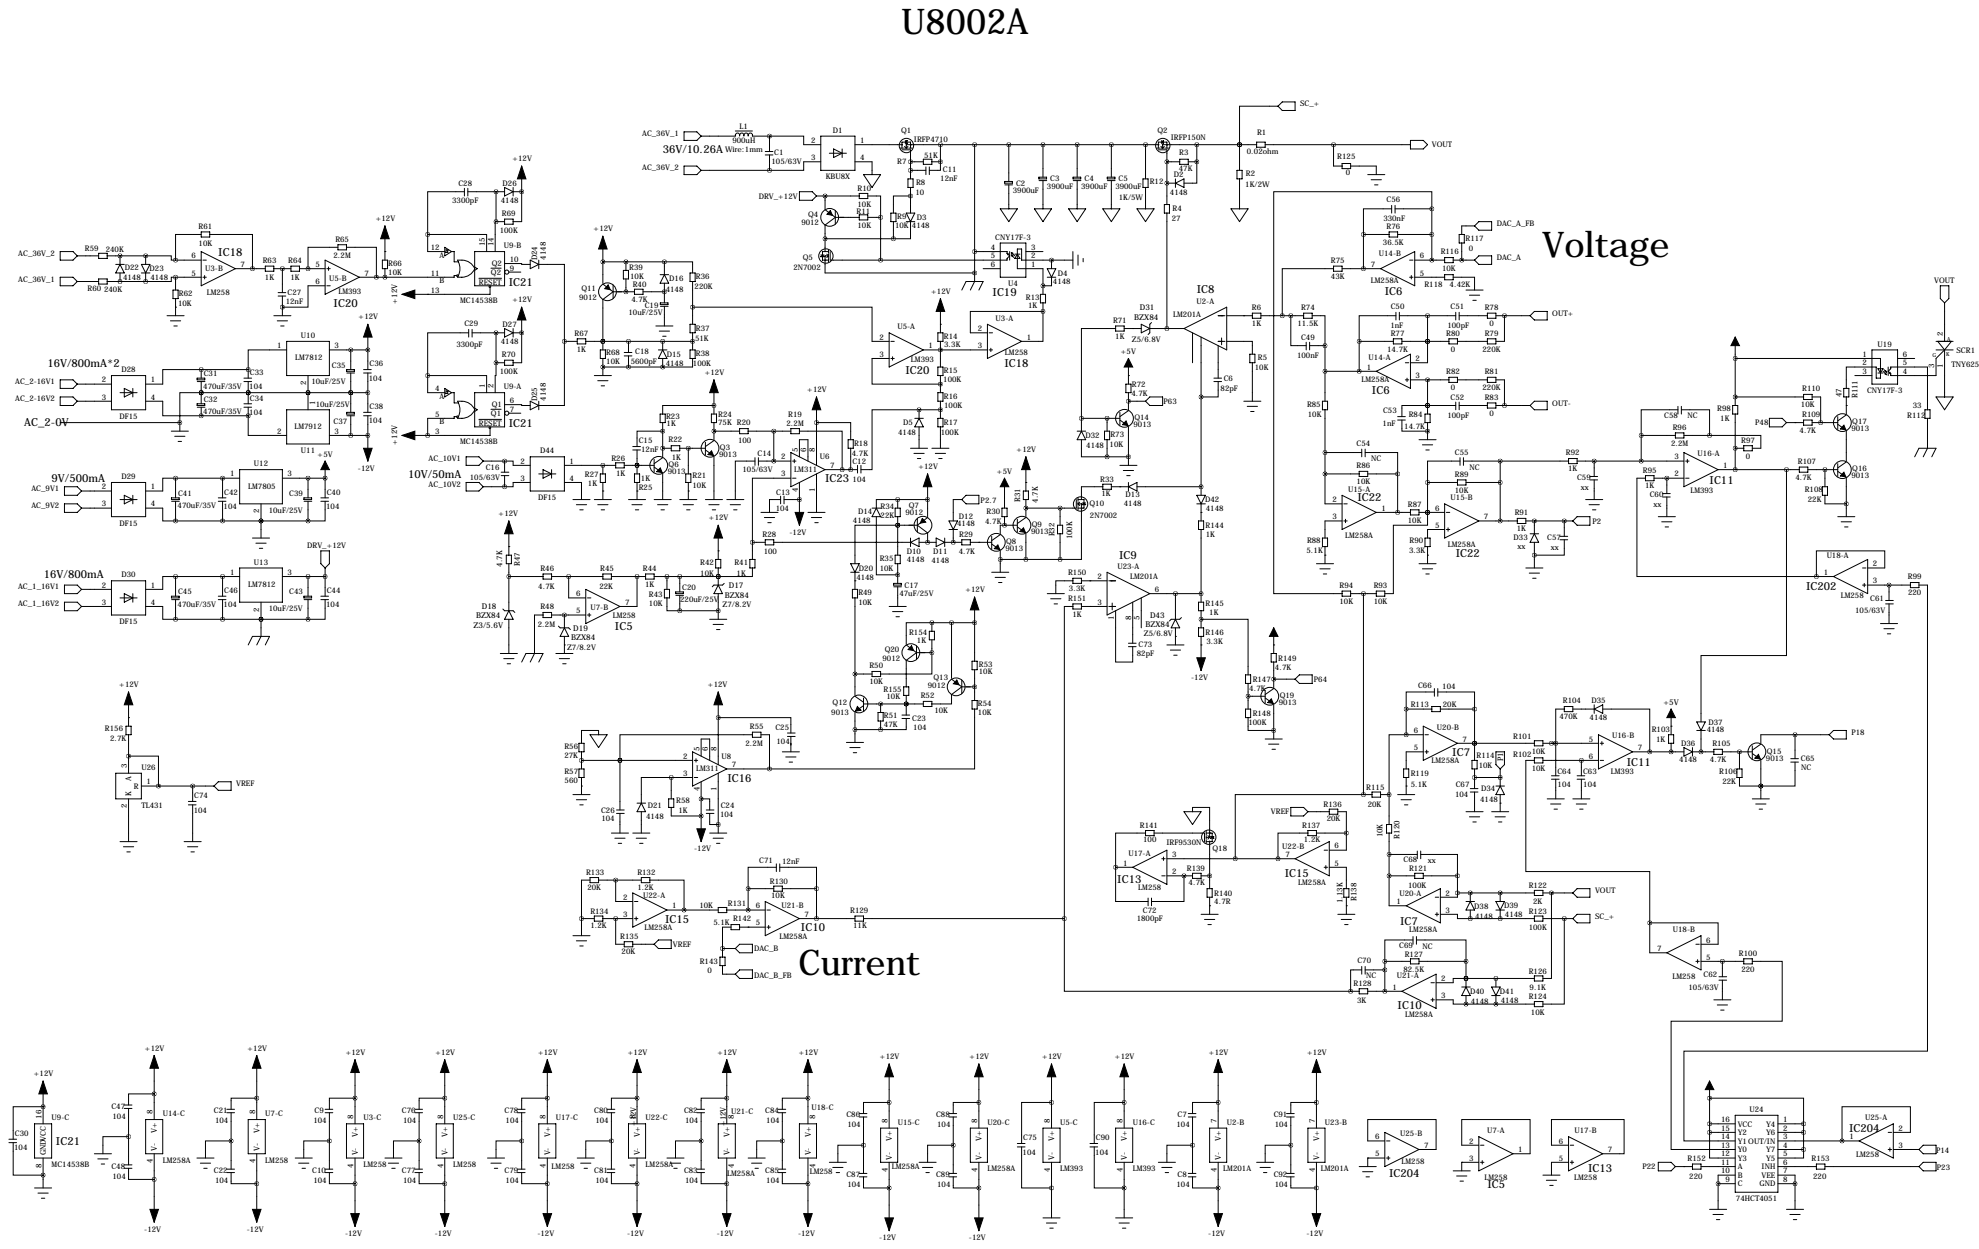
[picture p82: page 1]

23 | PA0 24 | PA1 25 | PA2 26 | PA3 29 | PA4 30 | PA5 31 | PA6 32 | PA7 67 | PA8 68 | PA9 69 | PA10 70 | PA11 71 | PA12 72 | PA13 76 | PA14 77 | PA15
35 | PB0 36 | PB1 37 | PB2 89 | PB3 90 | PB4 91 | PB5 92 | PB6 93 | PB7 95 | PB8 96 | PB9 47 | PB10 48 | PB11 51 | PB12 52 | PB13 53 | PB14 54 | PB15
12 | OSC_IN 13 | OSC_OUT 14 | RST#
94 | BOOT0
73 | NC

9
PC15
8
PC14
7
PC13 | 80 PC12 | 79 PC11 | 78 PC10 | 66 PC9 | 65 PC8 | 64 PC7 | 63 PC6 | 34 PC5 | 33 PC4 | 18 PC3 | 17 PC2 | 16 PC1 | 15 PC0
62 PD15 | 61 PD14 | 60 PD13 | 59 PD12 | 58 PD11 | 57 PD10 | 56 PD9 | 55 PD8 | 88 PD7 | 87 PD6 | 86 PD5 | 85 PD4 | 84 PD3 | 83 PD2 | 82 PD1 | 81 PD0
46 PE15 | 45 PE14 | 44 PE13 | 43 PE12 | 42 PE11 | 41 PE10 | 40 PE9 | 39 PE8 | 38 PE7 | 5

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
PE2 | 98 PE1 | 97 PE0

U1-A

STM32F103XC

21 | VREF+ 22 | VDDA 11 | VDD_5 28 | VDD_4 50 | VDD_1 75 | VDD_2 100 | VDD_3 6

VBAT

20 VREF- | 19 VSSA
74 VSS_2 | 99 VSS_3 | 49 VSS_1 | 27 VSS_4 | 10 VSS_5

U1-B

STM32F103XC
