bogdan-tirzioru/Powersupply/reaserch/PS2803_V3.pdf

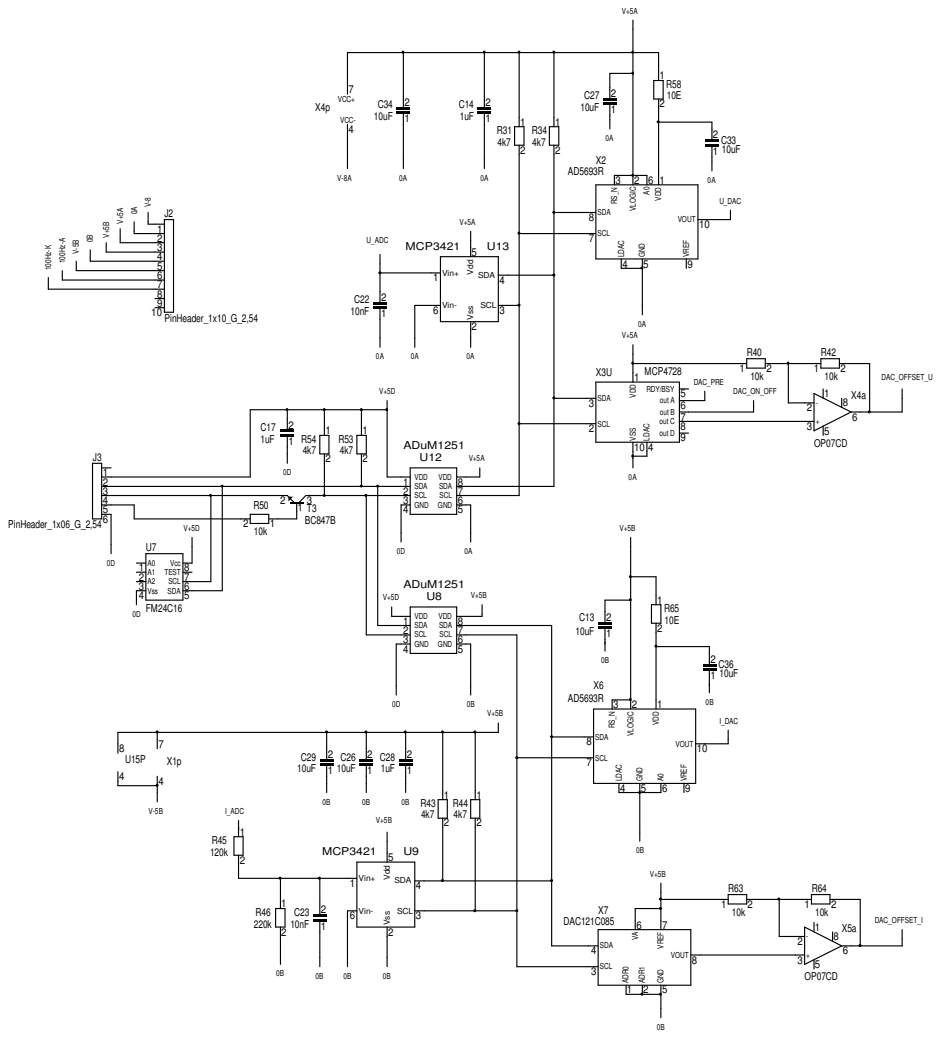
[picture p83: page 1]
