bogdan-tirzioru/Powersupply/reaserch/PS2803_V3_main.pdf

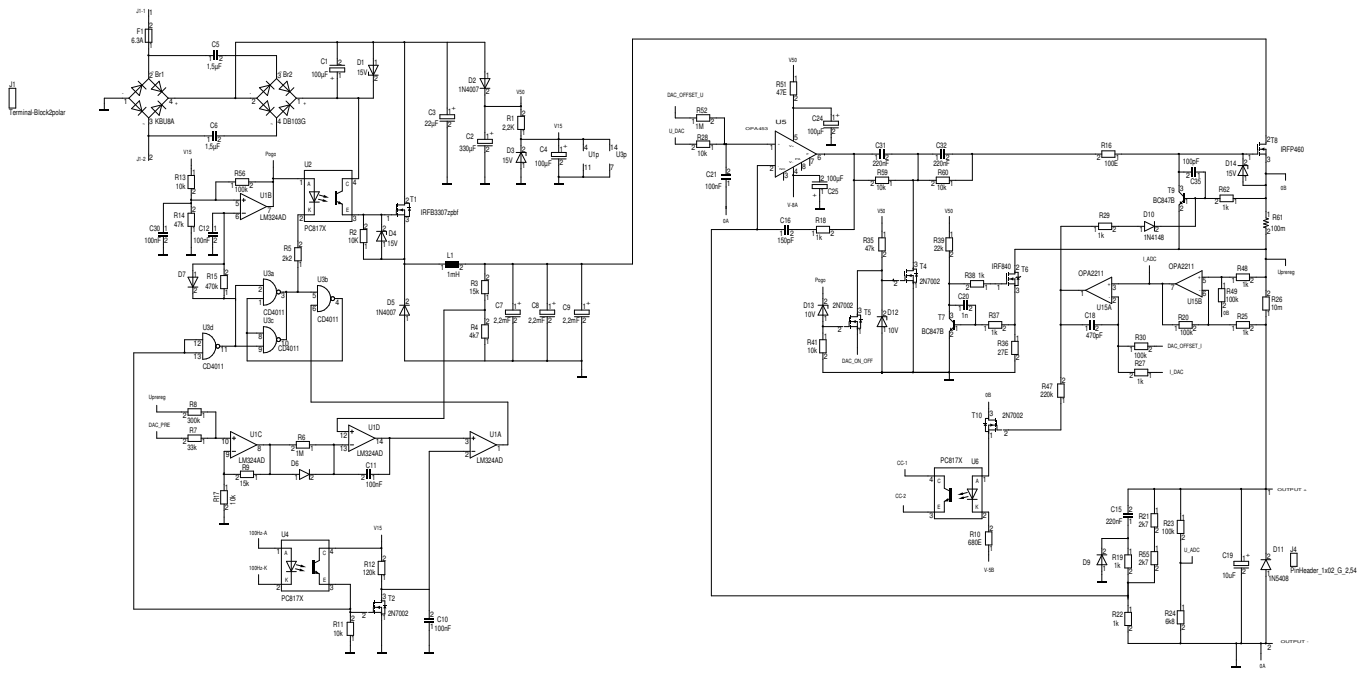
[picture p84: page 1]
