bogdan-tirzioru/Powersupply/power.asc

C1: cap; 10n
C2: cap; 10n
D2: schottky; 1N5819
M1: nmos; IRL530NS_L
Q1: pnp; BC557B
Q2: pnp; BC557B
R1: res; 10k
R2: res; 1k
R3: res; 33k
R4: res; 100
R5: res; 0.330
R6: res; 1.1k
R7: res; 1.2k
R8: res; 10k
R9: res; 100k
R10: res; 1Meg
R11: res; 100k
R12: res; 1Meg
R13: res; 1Meg
R14: res; 2.2k
R15: res; 1k
R16: res; 1Meg
R17: res; 100
R18: res; 100
R19: res; 1k
R20: res; 10
U1: LM324
U2: LM324
U3: LM324
V1: voltage; 35V
V2: voltage; 2.5
V3: voltage; 2.5
Named nets: 0
.dc V2 0 3 0.01
;tran 0.5
