bogdan-tirzioru/Powersupply/power01.asc

C1: cap; 10n
C2: cap; 10n
D2: schottky; 1N5819
L1: ind; 1m; Rser=20
M1: nmos; IRL530NS_L
Q1: pnp; BC557B
Q2: pnp; BC557B
R1: res; 10k
R2: res; 1k
R3: res; 33k
R4: res; 100
R5: res; 0.27
R6: res; 1.1k
R7: res; 1.2k
R8: res; 10k
R9: res; 100k
R10: res; 1Meg
R11: res; 100k
R12: res; 300k
R13: res; 300k
R14: res; 1k
R16: res; 1Meg
R17: res; 100
R18: res; 100
R19: res; 1k
U1: LM324
U2: LM324
U3: LM324
V1: voltage; 50V
V2: voltage; 2.5; AC 1.5 0
V3: voltage; 0.5
Named nets: 0
;dc V2 0 3 0.5 R20 0 50 1
.tran 0.1
;tf V(n003) V2
;op V(n003) V2
;ac lin 100 0.1 1k
