bogdan-tirzioru/Powersupply/power_sim/power.asc

C1: cap; 2.2n
C2: polcap; 10µ; V=6.3 Irms=0 Rser=4 Lser=0 mfg="AVX" pn="TAJA106M006" type="Tantalum"
C3: cap; 220p
D1: diode; 1N4148
D2: zener; EDZV20B
M1: nmos; IRFH5406
Q1: pnp; BC857C
R1: res; 10k
R2: res; 1k
R3: res; 10k
R4: res; 5
R5: res; 1k
R6: res; 2.2k
R7: res; 1.5Meg
R8: res; 0.1
R9: res; 1k
R10: res; 200
U1: LT1017
V1: voltage; SINE(33 2 50)
V2: voltage; SINE(2.5 2.5 3)
Named nets: 0
;dc V2 0 5 0.01
;ac oct 1000 0.1 50k
.tran 0.5
;tf 1 V1
