bogdan-tirzioru/Powersupply/power_sim/power_ac.asc

C1: cap; 2.2n
C2: polcap; 10µ; V=6.3 Irms=0 Rser=4 Lser=0 mfg="AVX" pn="TAJA106M006" type="Tantalum"
C3: cap; 120p
D1: diode; 1N4148
D2: zener; EDZV20B
L1: ind; 50µ
M1: nmos; IRFH5406
Q1: pnp; BC857C
Q2: pnp; BC557B
R1: res; 10k
R2: res; 1k
R3: res; 1k
R4: res; 100k
R5: res; 1k
R6: res; 2.2k
R7: res; 1.5Meg
R8: res; 0.1
R9: res; 750
R10: res; 0
R11: res; 100k
R12: res; 100k
R13: res; 1k
R14: res; 1k
R15: res; 1.2k
R16: res; 1k
R17: res; 1k
R18: res; 100k
R19: res; 1k
R20: res; 100
U1: LM224_ON
U2: LT1018
U4: LM224_ON
V1: voltage; 33; AC 30
V2: voltage; SINE(2.5 2.5 5)
V3: voltage; 1
Named nets: 0
;dc V2 0 5 0.1
;ac dec 100 0.1 10Meg
.tran 1
;tf V(n003) V1 list 0.5
;noise V(n003) V1 list 0.5
