bogdan-tirzioru/Powersupply/power_sim/powerspiplly.asc

C1: cap; 2.2n
D1: diode; 1N4148
M1: pmos; IRF7343P
Q1: pnp; BC557B
R1: res; 10Meg
R2: res; 10k
R3: res; 1k
R4: res; 10k
R5: res; 10k
R6: res; 100
R7: res; 1Meg
U1: LT1716
V1: voltage; SINE(10 10 50)
V2: voltage; 20
V3: voltage; 20v
Named nets: 0, Vout
.tran 1
;dc V1 0 20 0.01
