bogdan-tirzioru/Powersupply/reaserch/spice/buck.asc

C1: cap; 47µ
D1: schottky; BAT54
L1: ind; 100µ
M1: pmos; IRF7205
R1: res; 100
V1: voltage; 32
V2: voltage; PULSE(0 32 0 0 0 1u 50u)
Named nets: 0
.tran 0 110m 100m
