bogdan-tirzioru/Powersupply/reaserch/spice/power_ac3.asc

C1: cap; 2.2n
C3: cap; 120p
C4: cap; 100n
C5: cap; 10p
D1: schottky; BAT54
L1: ind; 50µ
M1: nmos; IRFH5406
Q1: pnp; BC857C
Q2: pnp; BC557B
R1: res; 10k
R2: res; 1k
R3: res; 1k
R4: res; 9.1k
R5: res; 1k
R6: res; 4.7k
R7: res; 1.5Meg
R8: res; 0.22
R9: res; 100
R10: res; 0
R11: res; 9.1k
R12: res; 100k
R14: res; 130; tol=1 pwr=0.1
R17: res; 10k
R19: res; 1k
R20: res; 10
R21: res; 100k
U1: LM224_ON
U2: LM224_ON
U3: LM224_ON
V1: voltage; 33; AC 30
V2: voltage; 5.
V3: voltage; 0.5
V4: voltage; 40
Named nets: 0
.dc V2 0 5 0.1
;ac oct 10 4 100
;tran 0 0.1 0 0.01
;tf V(n003) V1 list 0.5
;noise V(n003) V1 list 0.5
