bogdan-tirzioru/Powersupply/(list of files, drawings)

Other design files:
en.nucleo_144pins_sch (1)/NUCLEO-144pins_Altium_Schematics-Layout/Connectors.SchDoc
en.nucleo_144pins_sch (1)/NUCLEO-144pins_Altium_Schematics-Layout/Ethernet.SchDoc
en.nucleo_144pins_sch (1)/NUCLEO-144pins_Altium_Schematics-Layout/MB1137.PcbLib
en.nucleo_144pins_sch (1)/NUCLEO-144pins_Altium_Schematics-Layout/MB1137.PrjPCB
en.nucleo_144pins_sch (1)/NUCLEO-144pins_Altium_Schematics-Layout/MB1137.SchDoc
en.nucleo_144pins_sch (1)/NUCLEO-144pins_Altium_Schematics-Layout/MB1137.SCHLIB
en.nucleo_144pins_sch (1)/NUCLEO-144pins_Altium_Schematics-Layout/MCU_144.SchDoc
en.nucleo_144pins_sch (1)/NUCLEO-144pins_Altium_Schematics-Layout/ST_LINK_V2-1.SCHDOC
en.nucleo_144pins_sch (1)/NUCLEO-144pins_Altium_Schematics-Layout/USB.SchDoc
factory/sampleA/powersupply_grid8.PrjPcb
factory/sampleA/powersupply_grid8_0.SchDoc
factory/sampleA/powersupply_grid8_1.SchDoc
factory/sampleB/powersupply_grid8.PrjPcb
factory/sampleB/powersupply_grid8_0.SchDoc
factory/sampleB/powersupply_grid8_1.SchDoc
factory/sampleB/powersuppy.PcbDoc
powersupply_grid8.PrjPcb/4GBJ406F.PCBLIB
powersupply_grid8.PrjPcb/4GBJ406F.SCHLIB
powersupply_grid8.PrjPcb/B41888C7478M000.PCBLIB
powersupply_grid8.PrjPcb/B41888C7478M000.SCHLIB
powersupply_grid8.PrjPcb/Copy of powersuppy.PcbDoc
powersupply_grid8.PrjPcb/DE1207.PcbLib
powersupply_grid8.PrjPcb/diode_sk.SCHLIB
powersupply_grid8.PrjPcb/IFX91041.PcbLib
powersupply_grid8.PrjPcb/IFX91041.SchLib
powersupply_grid8.PrjPcb/Imported 4GBJ406F.PrjPcb/4GBJ406F.PCBLIB
powersupply_grid8.PrjPcb/Imported 4GBJ406F.PrjPcb/4GBJ406F.PrjPcb
powersupply_grid8.PrjPcb/Imported 4GBJ406F.PrjPcb/4GBJ406F.SCHLIB
powersupply_grid8.PrjPcb/Imported B41888C7478M000.PrjPcb/B41888C7478M000.PCBLIB
powersupply_grid8.PrjPcb/Imported B41888C7478M000.PrjPcb/B41888C7478M000.PrjPcb
powersupply_grid8.PrjPcb/Imported B41888C7478M000.PrjPcb/B41888C7478M000.SCHLIB
powersupply_grid8.PrjPcb/Imported con-3m.PrjPcb/con-3m.PCBLIB
powersupply_grid8.PrjPcb/Imported con-3m.PrjPcb/con-3m.PrjPcb
powersupply_grid8.PrjPcb/Imported con-3m.PrjPcb/con-3m.SCHLIB
powersupply_grid8.PrjPcb/Imported con-harting-ml.PrjPcb/con-harting-ml.PCBLIB
powersupply_grid8.PrjPcb/Imported con-harting-ml.PrjPcb/con-harting-ml.PrjPcb
powersupply_grid8.PrjPcb/Imported con-harting-ml.PrjPcb/con-harting-ml.SCHLIB
powersupply_grid8.PrjPcb/Imported con-lstb.PrjPcb/con-lstb.PCBLIB
powersupply_grid8.PrjPcb/Imported con-lstb.PrjPcb/con-lstb.PrjPcb
powersupply_grid8.PrjPcb/Imported con-lstb.PrjPcb/con-lstb.SCHLIB
powersupply_grid8.PrjPcb/Imported crystal.PrjPcb/crystal.PCBLIB
powersupply_grid8.PrjPcb/Imported crystal.PrjPcb/crystal.PrjPcb
powersupply_grid8.PrjPcb/Imported crystal.PrjPcb/crystal.SCHLIB
powersupply_grid8.PrjPcb/Imported crystal_my.PrjPcb/crystal_my.PCBLIB
powersupply_grid8.PrjPcb/Imported crystal_my.PrjPcb/crystal_my.PrjPcb
powersupply_grid8.PrjPcb/Imported crystal_my.PrjPcb/crystal_my.SCHLIB
powersupply_grid8.PrjPcb/Imported diode.PrjPcb/diode.PCBLIB
powersupply_grid8.PrjPcb/Imported diode.PrjPcb/diode.PrjPcb
powersupply_grid8.PrjPcb/Imported diode.PrjPcb/diode.SCHLIB
powersupply_grid8.PrjPcb/Imported jumper.PrjPcb/jumper.PCBLIB
powersupply_grid8.PrjPcb/Imported jumper.PrjPcb/jumper.PrjPcb
powersupply_grid8.PrjPcb/Imported jumper.PrjPcb/jumper.SCHLIB
powersupply_grid8.PrjPcb/Imported KF33BD-TR.PrjPcb/KF33BD-TR.PCBLIB
powersupply_grid8.PrjPcb/Imported KF33BD-TR.PrjPcb/KF33BD-TR.PrjPcb
powersupply_grid8.PrjPcb/Imported KF33BD-TR.PrjPcb/KF33BD-TR.SCHLIB
powersupply_grid8.PrjPcb/Imported linear.PrjPcb/linear.PCBLIB
powersupply_grid8.PrjPcb/Imported linear.PrjPcb/linear.PrjPcb
powersupply_grid8.PrjPcb/Imported linear.PrjPcb/linear.SCHLIB
powersupply_grid8.PrjPcb/Imported my_battery.PrjPcb/my_battery.PCBLIB
powersupply_grid8.PrjPcb/Imported my_battery.PrjPcb/my_battery.PrjPcb
powersupply_grid8.PrjPcb/Imported my_battery.PrjPcb/my_battery.SCHLIB
powersupply_grid8.PrjPcb/Imported Panasonic-EEEFT_EEEH.PrjPcb/Panasonic-EEEFT_EEEH.PCBLIB
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
