bogdan-tirzioru/Powersupply/reaserch/psu-hw-master/Power board/Eagle files/EEZ PSU power board r5B9.brd

## EAGLE design reaserch/psu-hw-master/Power board/Eagle files/EEZ PSU power board r5B9.brd (2020-10-24)

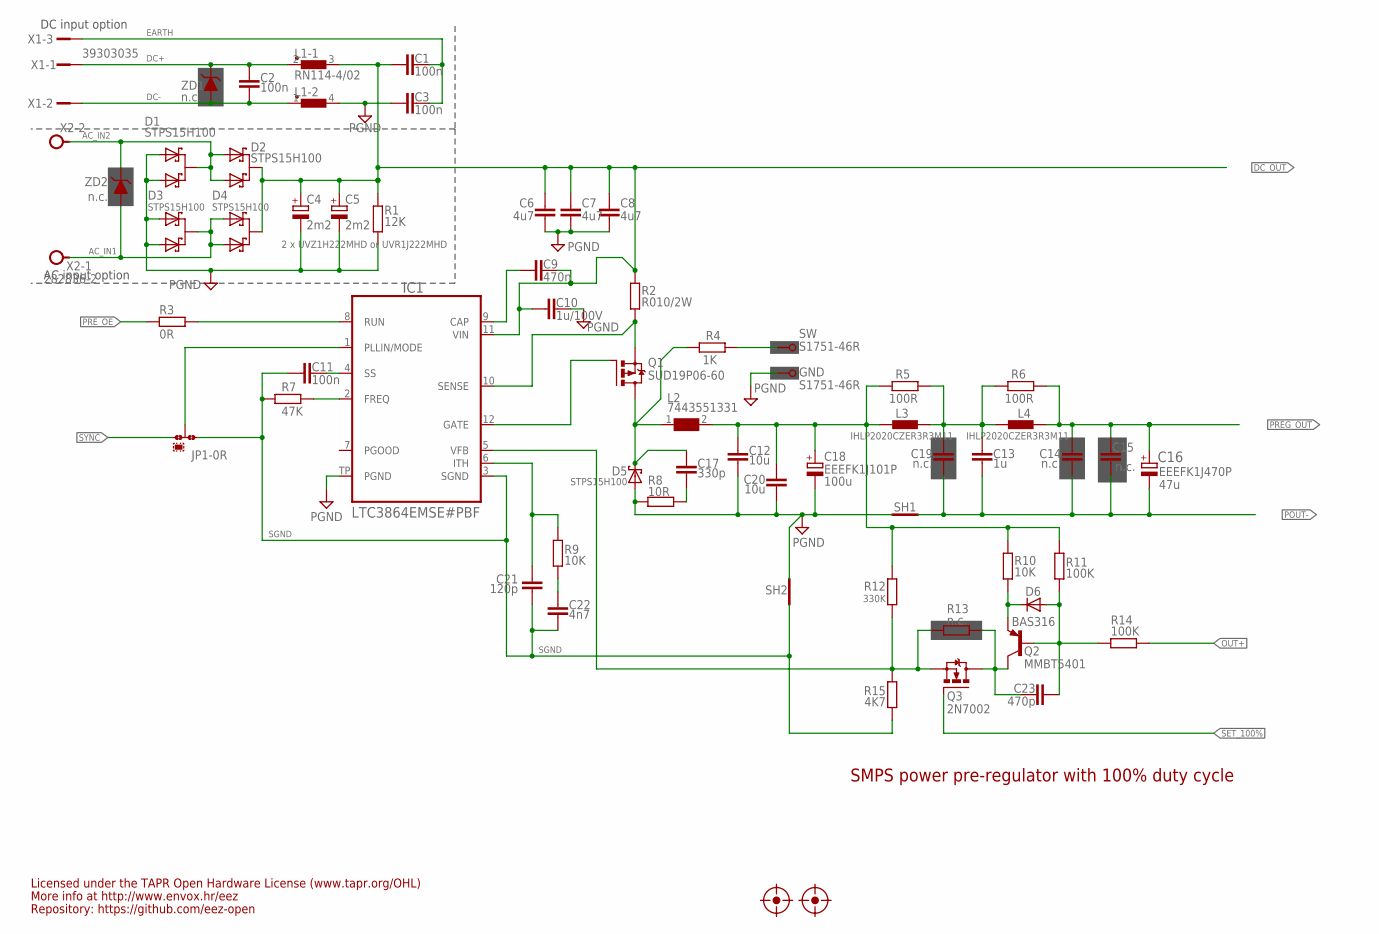
[picture p85: schematic EEZ PSU power board r5B9.sch, sheet 1, Power pre-regulator]

Parts:
C1, C2, C3: 100n; C1206
C4, C5: 2m2; ECAP7.5/18
C6, C7, C8: 4u7; C1210
C9: 470n; C0805
C10: 1u/100V; C1206
C11: 100n; C0603
C12, C20: 10u; C1210
C13: 1u; C0805
C14, C15, C19: n.c.; C0805
C16: EEEFK1J470P; CAPAE830X1050N
C17: 330p; C0805
C18: EEEFK1J101P; PANASONIC_F
C21: 120p; C0805
C22: 4n7; C0805
C23: 470p; C0805
D1, D2, D3, D4: STPS15H100; TO252@1
D5: STPS15H100; TO252
D6: BAS316; SOD323-W
FM1, FM2: FIDUCIAL_2; FIDUCIAL_DUAL
GND: S1751-46R
IC1: LTC3864EMSE#PBF; LTC_05-08-1666
JP1: 0R-JUMPA; A0R-JMP
L1: RN114-4/02; RN114
L2: 7443551331; WE-HCI_1350/1365
L3, L4: IHLP2020CZER3R3M11; IHLP-2020BZ-11
Q1: SUD19P06-60; TO229P990X239-3N
Q2: MMBT5401; SOT23-BEC
Q3: 2N7002; SOT103P240X110-3N
R1: 12K; R1206
R2: R010/2W; R2512
R3: 0R; R0805
R4: 1K; R0805
R5, R6: 100R; R0805
R7: 47K; R0805
R8: 10R; R1206
R9, R10: 10K; R0805
R11, R14: 100K; R0805
R12: 330K; R0805
R13: n.c.; R0805
R15: 4K7; R0805
SH1: Pgnd to Pout- short; SHORT_NOHOLE
SH2: Sgnd to Pgnd short; SHORT_NOHOLE
SW: S1751-46R
X1: 39303035; MINIFIT_6659-3
X2: 282836-2; TBLOCK5.0_2
ZD1, ZD2: n.c.; DO214AA

Connections:
!SET_100%: Q3.1 (G); also elsewhere on the board
AC_IN1: D3.3 (C), D4.1 (A1), D4.2 (A2), X2.1, ZD2.A (2)
AC_IN2: D1.3 (C), D2.1 (A1), D2.2 (A2), X2.2, ZD2.C (1)
DC+: C2.2, L1.2 (1), X1.1, ZD1.C (1)
DC-: C2.1, L1.1, X1.2, ZD1.A (2)
DC_OUT: C1.2, C4.+, C5.+, C6.1, C7.1, C8.1, C9.2, C10.1, D2.3 (C), D4.3 (C), IC1.11 (VIN), L1.3 (2), R1.1, R2.1; also elsewhere on the board
EARTH: C1.1, C3.2, X1.3
FB: IC1.5 (VFB), Q3.2 (S), R12.2, R13.2, R15.1
GND: C3.1, C4.-, C5.-, C6.2, C7.2, C8.2, C10.2, C12.2, C18.2 (-), C20.2, D1.1 (A1), D1.2 (A2), D3.1 (A1), D3.2 (A2), D5.1 (A), D5.2 (A), GND.P$1, IC1.TP (PGND), L1.4 (2), R1.2, R8.1, SH1.P$2 (GND_B), SH2.P$2 (GND_B); also elsewhere on the board
L_OUT: C12.1, C18.1 (+), C20.1, L2.2, L3.1, R5.1, R10.1, R11.1, R12.1
MODE: IC1.1 (PLLIN/MODE), JP1.2
unnamed: R4.2, SW.P$1
unnamed: D6.C, Q2.E, R10.2
unnamed: C21.1, IC1.6 (ITH), R9.2
unnamed: C22.1, R9.1
unnamed: C9.1, IC1.9 (CAP)
unnamed: IC1.12 (GATE), Q1.1 (G)
unnamed: IC1.2 (FREQ), R7.1
unnamed: C11.2, IC1.4 (SS)
unnamed: C23.1, Q2.C, Q3.3 (D), R13.1
unnamed: C13.1, C19.2, L3.2, L4.1, R5.2, R6.1
unnamed: IC1.8 (RUN), R3.1
unnamed: C17.2, R8.2
unnamed: C23.2, D6.A, Q2.B, R11.2, R14.1
OUT+: R14.2; also elsewhere on the board
POUT-: C13.2, C14.2, C15.2, C16.2, C19.1, SH1.P$1 (GND_A); also elsewhere on the board
PREG_OUT: C14.1, C15.1, C16.1, L4.2, R6.2; also elsewhere on the board
PRE_OE: R3.2; also elsewhere on the board
SENSE: IC1.10 (SENSE), Q1.3 (S), R2.2
SGND: C11.1, C21.2, C22.2, IC1.3 (SGND), JP1.1, R7.2, R15.2, SH2.P$1 (GND_A)
SW: C17.1, D5.3 (C), L2.1, Q1.2 (D), R4.1
SYNC: JP1.3; also elsewhere on the board

Notes on the sheet:
47u
2 x UVZ1H222MHD or UVR1J222MHD
Licensed under the TAPR Open Hardware License (www.tapr.org/OHL)
Repository: https://github.com/eez-open
More info at http://www.envox.hr/eez
SMPS power pre-regulator with 100% duty cycle
100u
DC input option
AC input option

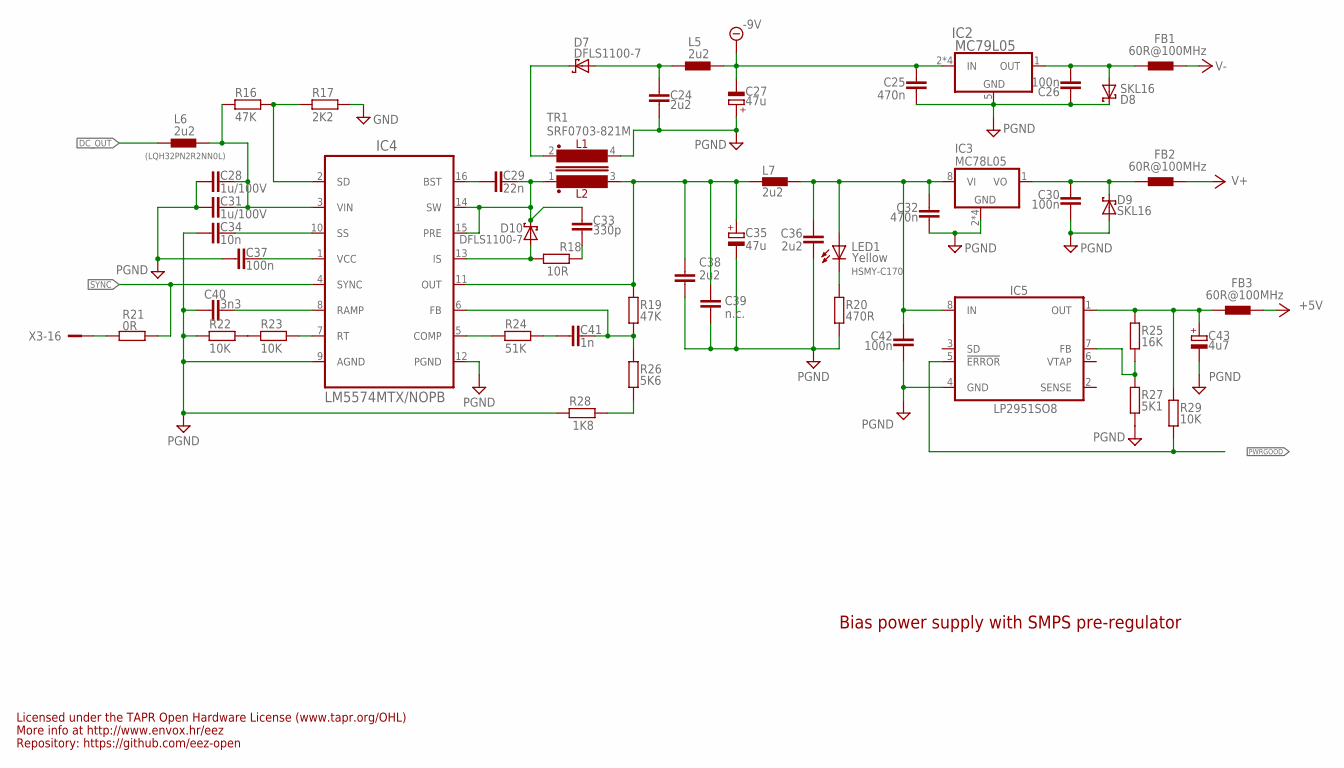
[picture p86: schematic EEZ PSU power board r5B9.sch, sheet 2, Bias power]

Parts:
C24, C36, C38: 2u2; C0805
C25, C32: 470n; C0805
C26, C30, C37, C42: 100n; C0603
C27, C35: 47u; CAPAE660X610N
C28, C31: 1u/100V; C1206
C29: 22n; C0805
C33: 330p; C0805
C34: 10n; C0805
C39: n.c.; C0805
C40: 3n3; C0805
C41: 1n; C0805
C43: 4u7; EC1206
D7, D10: DFLS1100-7; SOD123
D8, D9: SKL16; SOD123
FB1, FB2, FB3: 60R@100MHz; BEAD0603
IC2: MC79L05; SOIC127P600X173-8N
IC3: MC78L05; SOIC127P600X173-8N
IC4: LM5574MTX/NOPB; SOP65P640X110-16N
IC5: LP2951SO8; SOIC127P600X175-8N
L5, L6, L7: 2u2; L1210
LED1: HSMY-C170; LED_0805
R16, R19: 47K; R0805
R17: 2K2; R0805
R18: 10R; R1206
R20: 470R; R0805
R21: 0R; R0805
R22, R23, R29: 10K; R0805
R24: 51K; R0805
R25: 16K; R0805
R26: 5K6; R0805
R27: 5K1; R0805
R28: 1K8; R0805
TR1: SRF0703-821M; SRF0703
X3: SSW-113-02-T-D-RA; FARNELL 1805583

Connections:
+5V: FB3.P$2 (2); also elsewhere on the board
+VNR: C32.1, C36.1, C42.1, IC3.8 (VI), IC5.8 (IN), L7.2, LED1.A
-9V: C25.2, C27.2 (-), IC2.2 (IN), IC2.3 (IN), IC2.6 (IN), IC2.7 (IN), L5.2; also elsewhere on the board
DC_OUT: L6.1; also elsewhere on the board
DC_PREG1: C28.1, C31.1, IC4.3 (VIN), L6.2, R16.2
GND: C24.2, C25.1, C26.1, C27.1 (+), C28.2, C30.2, C31.2, C32.2, C34.2, C35.2 (-), C36.2, C37.1, C38.2, C39.2, C40.1, C42.2, C43.-, D8.C, D9.A, IC2.5 (GND), IC3.2 (GND), IC3.3 (GND), IC3.6 (GND), IC3.7 (GND), IC4.9 (AGND), IC4.12 (PGND), IC5.4 (GND), R17.1, R20.2, R22.2, R27.2, R28.1, TR1.4; also elsewhere on the board
IS: D10.A, IC4.13 (IS), R18.1
unnamed: C26.2, D8.A, FB1.P$1 (1), IC2.1 (OUT)
unnamed: C30.1, D9.C, FB2.P$1 (1), IC3.1 (VO)
unnamed: C43.+, FB3.P$1 (1), IC5.1 (OUT), R25.1, R29.1
unnamed: R21.2, X3.16
unnamed: LED1.C, R20.1
unnamed: C33.2, R18.2
unnamed: IC5.7 (FB), R25.2, R27.1
unnamed: C41.2, R24.2
unnamed: R26.2, R28.2
unnamed: R22.1, R23.2
unnamed: C41.1, IC4.6 (FB), R19.2, R26.1
unnamed: C29.2, IC4.16 (BST)
unnamed: IC4.5 (COMP), R24.1
unnamed: IC4.7 (RT), R23.1
unnamed: C37.2, IC4.1 (VCC)
unnamed: C40.2, IC4.8 (RAMP)
unnamed: C34.1, IC4.10 (SS)
unnamed: C24.1, D7.A, L5.1
unnamed: IC4.2 (SD), R16.1, R17.2
PWRGOOD: IC5.5 (!ERROR), R29.2; also elsewhere on the board
SW1: C29.1, C33.1, D10.C, IC4.14 (SW), IC4.15 (PRE), TR1.1
SYNC: IC4.4 (SYNC), R21.1; also elsewhere on the board
V+: FB2.P$2 (2); also elsewhere on the board
V-: FB1.P$2 (2); also elsewhere on the board
VOUT+: C35.1 (+), C38.1, C39.1, IC4.11 (OUT), L7.1, R19.1, TR1.3
VOUT-: D7.C, TR1.2

Notes on the sheet:
(LQH32PN2R2NN0L)
Bias power supply with SMPS pre-regulator
Yellow
Licensed under the TAPR Open Hardware License (www.tapr.org/OHL)
Repository: https://github.com/eez-open
More info at http://www.envox.hr/eez

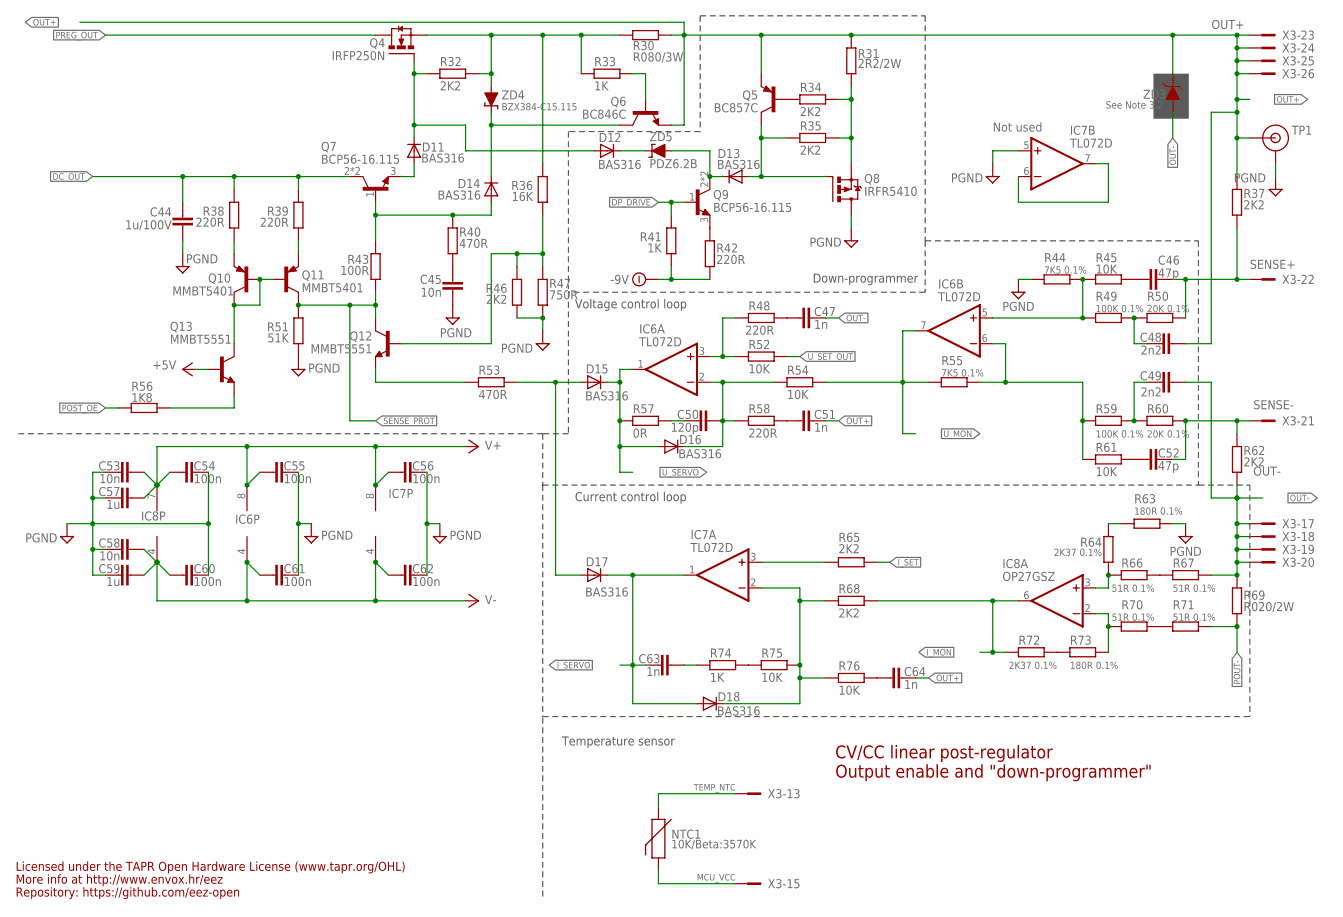
[picture p87: schematic EEZ PSU power board r5B9.sch, sheet 3, Post-regulator]

Parts:
C44: 1u/100V; C1206
C45, C53, C58: 10n; C0805
C46, C52: 47p; C0805
C47, C51, C63, C64: 1n; C0805
C48, C49: 2n2; C0805
C50: 120p; C0805
C54, C55, C56, C60, C61, C62: 100n; C0603
C57, C59: 1u; C0805
D11, D12, D13, D14, D15, D16, D17, D18: BAS316; SOD323-W
IC6, IC7: TL072D; SOIC127P600X173-8N
IC8: OP27GSZ; SOIC127P600X173-8N
NTC1: 10K/Beta:3570K; R_0204/5+0805
Q4: IRFP250N; TO247BH-CLR
Q5: BC857C; SOT23-BEC
Q6: BC846C; SOT23-BEC
Q7, Q9: BCP56-16.115; SOT230P700X180-4N
Q8: IRFR5410; TO229P990X239-3N
Q10, Q11: MMBT5401; SOT23-BEC
Q12, Q13: MMBT5551; SOT23-BEC
R30: R080/3W; R2512
R31: 2R2/2W; R2512
R32, R34, R35, R37, R46, R62, R65, R68: 2K2; R0805
R33, R41, R74: 1K; R0805
R36: 16K; R0805
R38, R39, R42, R48, R58: 220R; R0805
R40, R53: 470R; R0805
R43: 100R; R0805
R44, R55: 7K5 0.1%; R0805
R45, R52, R54, R61, R75, R76: 10K; R0805
R47: 750R; R0805
R49, R59: 100K 0.1%; R0805
R50, R60: 20K 0.1%; R0805
R51: 51K; R0805
R56: 1K8; R0805
R57: 0R; R0805
R63, R73: 180R 0.1%; R0805
R64, R72: 2K37 0.1%; R0805
R66, R67, R70, R71: 51R 0.1%; R0805
R69: R020/2W; R2512
TP1: TEST_POINT; TP_1.1MM
X3: SSW-113-02-T-D-RA; FARNELL 1805583
ZD3: See Note 3.2; DO214AA
ZD4: BZX384-C15.115; SOD323-W
ZD5: PDZ6.2B; SOD323-W

Connections:
!DP_DRIVE: Q9.1 (B), R41.1; also elsewhere on the board
+5V: Q13.B; also elsewhere on the board
-9V: R41.2, R42.2; also elsewhere on the board
DC_OUT: C44.1, Q7.2 (C), Q7.4 (C), R38.2, R39.2; also elsewhere on the board
GND: C44.2, C45.2, C53.1, C54.2, C55.1, C56.1, C57.1, C58.1, C59.1, C60.2, C61.1, C62.1, IC7.5 (+IN), Q8.2 (D), R44.1, R46.1, R47.1, R51.1, R63.1, TP1.GND; also elsewhere on the board
ISENSE+: IC8.3 (+IN), R64.2, R66.2
ISENSE-: IC8.2 (-IN), R70.2, R73.1
I_MON: IC8.6 (OUT), R68.1, R72.2; also elsewhere on the board
I_SERVO: C63.2, D17.C, D18.A, IC7.1 (OUT); also elsewhere on the board
I_SET: R65.1; also elsewhere on the board
MCU_VCC: NTC1.2, NTC1.2.1, X3.15
unnamed: Q9.3 (E), R42.1
unnamed: Q5.B, R34.2
unnamed: C46.2, R45.1
unnamed: R66.1, R67.2
unnamed: C52.2, R61.1
unnamed: R70.1, R71.2
unnamed: R72.1, R73.2
unnamed: R63.2, R64.1
unnamed: IC7.6 (-IN), IC7.7 (OUT)
unnamed: C49.1, R59.2, R60.1
unnamed: C50.2, R57.1
unnamed: C64.2, R76.1
unnamed: C47.2, R48.1
unnamed: C51.2, R58.1
unnamed: IC6.3 (+IN), R48.2, R52.2
unnamed: C50.1, D16.C, IC6.2 (-IN), R54.2, R58.2
unnamed: D18.C, IC7.2 (-IN), R68.2, R75.2, R76.2
unnamed: Q12.B, R36.1, R46.2, R47.2
unnamed: IC7.3 (+IN), R65.2
unnamed: D15.A, D17.A, R53.1
unnamed: D11.C, D12.A, Q4.G, R32.1
unnamed: D11.A, Q7.3 (E)
unnamed: D14.A, Q7.1 (B), R40.2, R43.1
unnamed: C45.1, R40.1
unnamed: C48.1, R49.2, R50.1
unnamed: D14.C, Q6.C, ZD4.C
unnamed: D12.C, ZD5.C
unnamed: Q12.E, R53.2
unnamed: Q8.3 (S), R31.1, R34.1, R35.1
unnamed: D13.A, Q5.C, Q8.1 (G), R35.2
unnamed: IC6.5 (+IN), R44.2, R45.2, R49.1
unnamed: IC6.6 (-IN), R55.2, R59.1, R61.2
unnamed: R74.2, R75.1
unnamed: C63.1, R74.1
unnamed: Q11.E, R39.1
unnamed: Q10.E, R38.1
unnamed: Q13.E, R56.2
unnamed: Q6.B, R33.1
OUT+: C48.2, C51.1, C64.1, Q5.E, Q6.E, R30.2, R31.2, R37.1, TP1.TIP, X3.23, X3.24, X3.25, X3.26, ZD3.C (1); also elsewhere on the board
OUT-: C47.1, C49.2, R62.2, R67.1, R69.1, X3.17, X3.18, X3.19, X3.20, ZD3.A (2); also elsewhere on the board
POST_OE: R56.1; also elsewhere on the board
POUT-: R69.2, R71.1; also elsewhere on the board
PREG_OUT: Q4.D; also elsewhere on the board
Q4_OUT: Q4.S, R30.1, R32.2, R33.2, R36.2, ZD4.A
Q7C: Q10.B, Q10.C, Q11.B, Q13.C
Q9C: D13.C, Q9.2 (C), Q9.4 (C), ZD5.A
SENSE+: C46.1, R37.2, R50.2, X3.22; also elsewhere on the board
SENSE-: C52.1, R60.2, R62.1, X3.21; also elsewhere on the board
SENSE_PROT: Q11.C, Q12.C, R43.2, R51.2; also elsewhere on the board
TEMP_NTC: NTC1.1, NTC1.1.1, X3.13
U_MON: IC6.7 (OUT), R54.1, R55.1; also elsewhere on the board
U_SERVO: D15.C, D16.A, IC6.1 (OUT), R57.2; also elsewhere on the board
U_SET_OUT: R52.1; also elsewhere on the board
V+: C53.2, C54.1, C55.2, C56.2, C57.2, IC6.8 (V+), IC7.8 (V+), IC8.7 (V+); also elsewhere on the board
V-: C58.2, C59.2, C60.1, C61.2, C62.2, IC6.4 (V-), IC7.4 (V-), IC8.4 (V-); also elsewhere on the board

Notes on the sheet:
Current control loop
Voltage control loop
CV/CC linear post-regulator
Output enable and "down-programmer"
Down-programmer
Not used
Licensed under the TAPR Open Hardware License (www.tapr.org/OHL)
Repository: https://github.com/eez-open
More info at http://www.envox.hr/eez
Temperature sensor

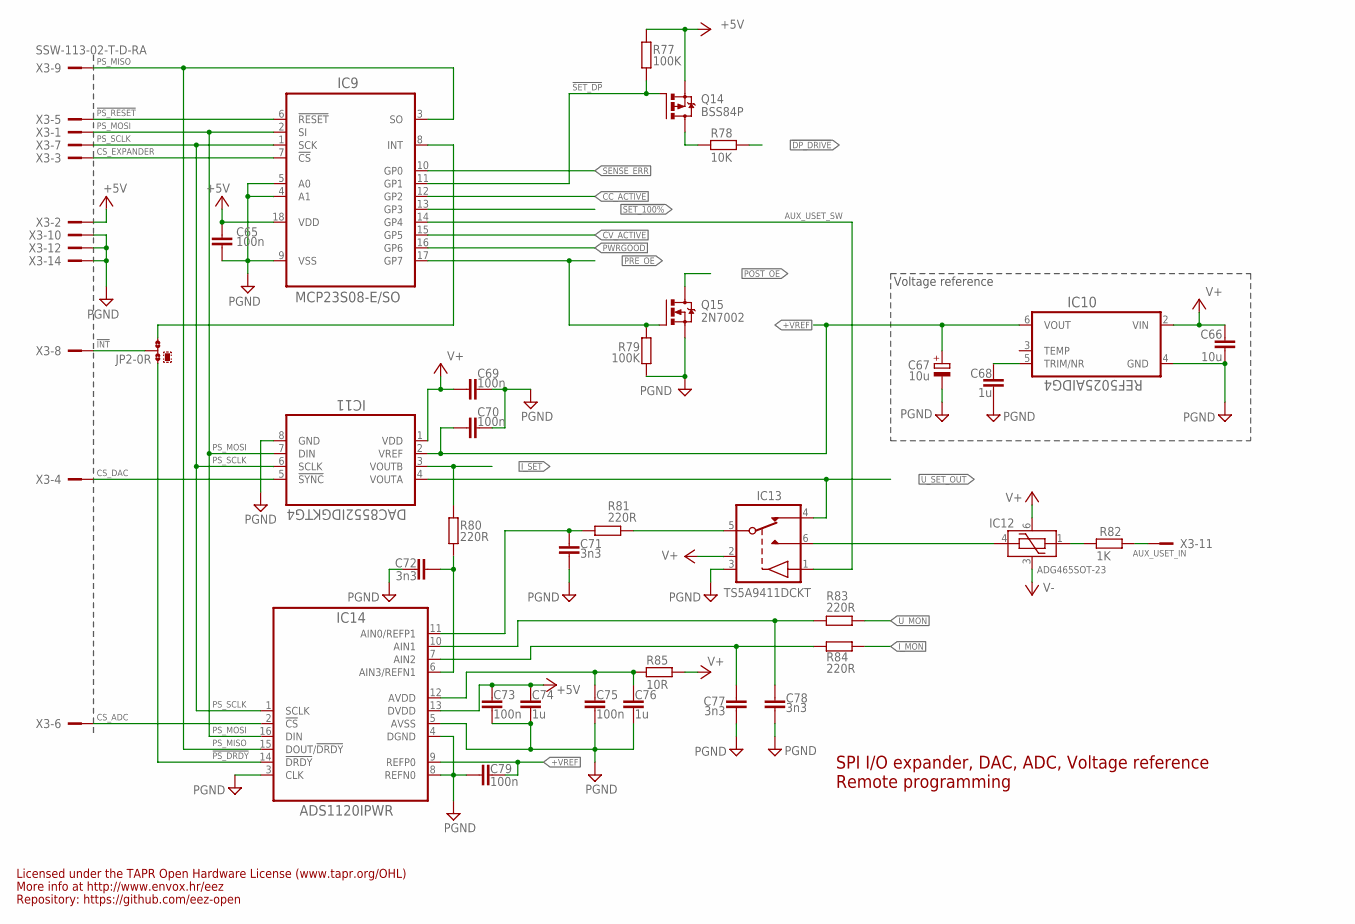
[picture p88: schematic EEZ PSU power board r5B9.sch, sheet 4, Digital control, voltage reference]

Parts:
C65, C69, C70, C73, C75, C79: 100n; C0603
C66: 10u; C1210
C67: 10u; EC1206
C68, C74, C76: 1u; C0805
C71, C72, C77, C78: 3n3; C0805
IC9: MCP23S08-E/SO; SOIC127P1030X265-18N
IC10: REF5025AIDG4; SOIC127P600X175-8N
IC11: DAC8552IDGKTG4; DGK8-M
IC12: ADG465SOT-23; SOT95P280X145-6N
IC13: TS5A9411DCKT; SOT65P210X110-6N
IC14: ADS1120IPWR; PW(R-PDSO-G16)
JP2: 0R-JUMPA; A0R-JMP
Q14: BSS84P; SOT95P237X112-3N
Q15: 2N7002; SOT103P240X110-3N; MPN 2N7002-7-F
R77, R79: 100K; R0805
R78: 10K; R0805
R80, R81, R83, R84: 220R; R0805
R82: 1K; R0805
R85: 10R; R1206
X3: SSW-113-02-T-D-RA; FARNELL 1805583

Connections:
!DP_DRIVE: R78.1; also elsewhere on the board
!INT: JP2.2, X3.8
!PS_DRDY: IC14.14 (!DRDY), JP2.3
!PS_RESET: IC9.6 (!RESET), X3.5
!SET_100%: IC9.13 (GP3); also elsewhere on the board
!SET_DP: IC9.11 (GP1), Q14.1 (G), R77.2
+5V: C65.1, C73.2, C74.2, IC9.18 (VDD), IC14.13 (DVDD), Q14.2 (S), R77.1, X3.2; also elsewhere on the board
+VREF: C67.+, C70.2, C79.2, IC10.6 (VOUT), IC11.2 (VREF), IC14.9 (REFP0)
AUX_USET_IN: R82.2, X3.11
AUX_USET_SW: IC9.14 (GP4), IC13.1 (IN)
CC_ACTIVE: IC9.12 (GP2); also elsewhere on the board
CS_ADC: IC14.2 (!CS), X3.6
CS_DAC: IC11.5 (!SYNC), X3.4
CS_EXPANDER: IC9.7 (!CS), X3.3
CV_ACTIVE: IC9.15 (GP5); also elsewhere on the board
DP_LED: Q14.3 (D), R78.2
GND: C65.2, C66.2, C67.-, C68.2, C69.1, C70.1, C71.1, C72.2, C73.1, C74.1, C75.1, C76.1, C77.1, C78.1, C79.1, IC9.4 (A1), IC9.5 (A0), IC9.9 (VSS), IC10.4 (GND), IC11.8 (GND), IC13.3 (GND), IC14.3 (CLK), IC14.4 (DGND), IC14.5 (AVSS), IC14.8 (REFN0), Q15.2 (S), R79.1, X3.10, X3.12, X3.14; also elsewhere on the board
INT_EXP: IC9.8 (INT), JP2.1
I_MON: R84.1; also elsewhere on the board
I_SET: IC11.3 (VOUTB), R80.1; also elsewhere on the board
unnamed: IC12.4 (VS), IC13.6 (S1)
unnamed: C68.1, IC10.5 (TRIM/NR)
unnamed: IC12.1 (VD), R82.1
unnamed: C78.2, IC14.10 (AIN1), R83.2
unnamed: C71.2, IC14.11 (AIN0/REFP1), R81.2
unnamed: C75.2, C76.2, IC14.12 (AVDD), R85.2
unnamed: C72.1, IC14.6 (AIN3/REFN1), R80.2
unnamed: C77.2, IC14.7 (AIN2), R84.2
POST_OE: Q15.3 (D); also elsewhere on the board
PRE_OE: IC9.17 (GP7), Q15.1 (G), R79.2; also elsewhere on the board
PS_MISO: IC9.3 (SO), IC14.15 (DOUT/!DRDY), X3.9
PS_MOSI: IC9.2 (SI), IC11.7 (DIN), IC14.16 (DIN), X3.1
PS_SCLK: IC9.1 (SCK), IC11.6 (SCLK), IC14.1 (SCLK), X3.7
PWRGOOD: IC9.16 (GP6); also elsewhere on the board
SENSE_ERR: IC9.10 (GP0); also elsewhere on the board
U_MON: R83.1; also elsewhere on the board
U_SET: IC13.5 (D), R81.1
U_SET_OUT: IC11.4 (VOUTA), IC13.4 (S2); also elsewhere on the board
V+: C66.1, C69.2, IC10.2 (VIN), IC11.1 (VDD), IC12.6 (VDD), IC13.2 (VDD), R85.1; also elsewhere on the board
V-: IC12.3 (VSS); also elsewhere on the board

Notes on the sheet:
SPI I/O expander, DAC, ADC, Voltage reference
Voltage reference
Licensed under the TAPR Open Hardware License (www.tapr.org/OHL)
Repository: https://github.com/eez-open
More info at http://www.envox.hr/eez
Remote programming

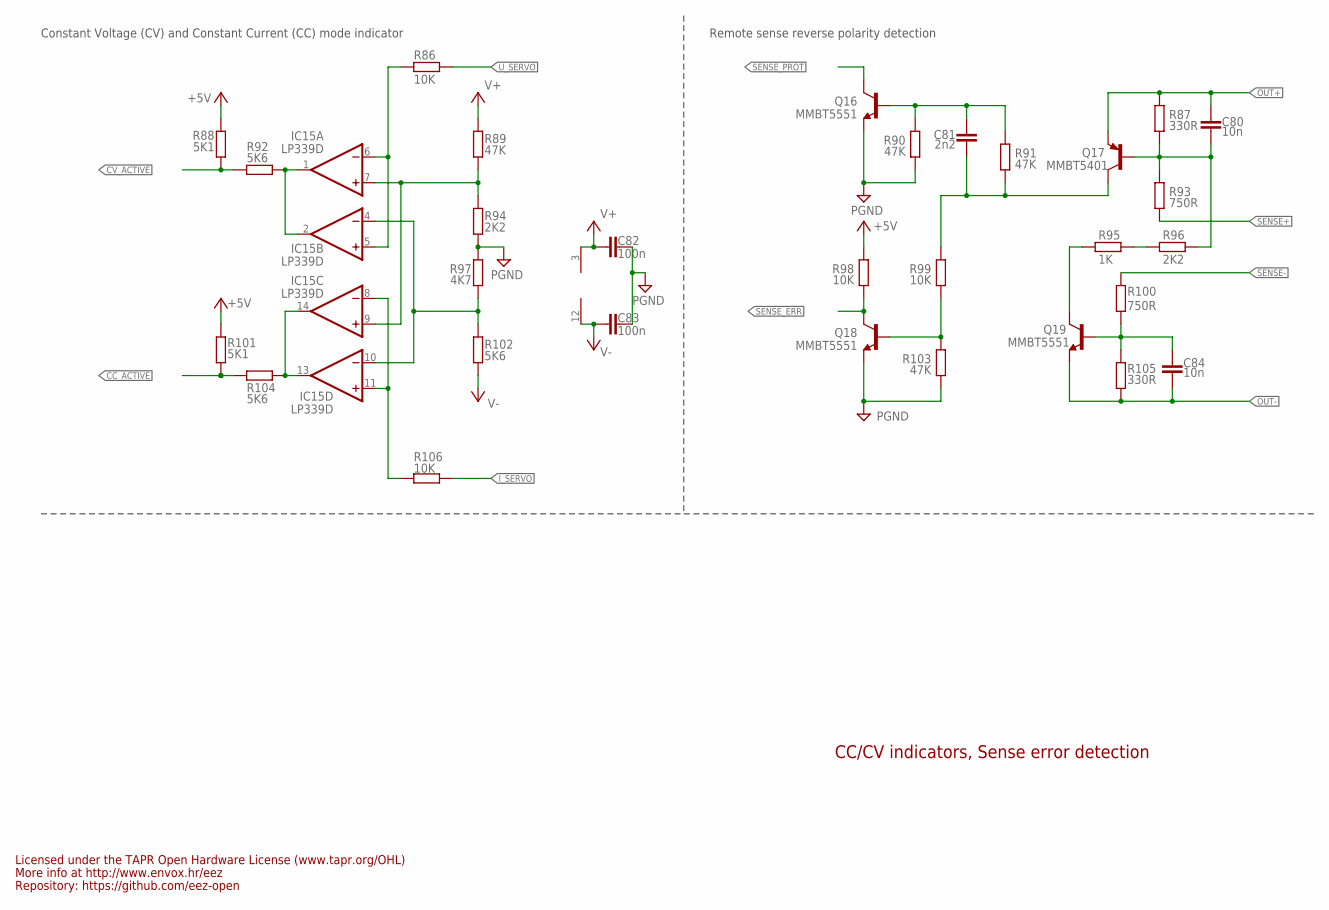
[picture p89: schematic EEZ PSU power board r5B9.sch, sheet 5, CC/CV, Remote sense protection]

Parts:
C80, C84: 10n; C0805
C81: 2n2; C0805
C82, C83: 100n; C0603
IC15: LP339D; SOIC127P600X175-14N
Q16, Q18, Q19: MMBT5551; SOT23-BEC
Q17: MMBT5401; SOT23-BEC
R86, R98, R99, R106: 10K; R0805
R87, R105: 330R; R0805
R88, R101: 5K1; R0805
R89, R90, R91, R103: 47K; R0805
R92, R102, R104: 5K6; R0805
R93, R100: 750R; R0805
R94, R96: 2K2; R0805
R95: 1K; R0805
R97: 4K7; R0805

Connections:
+5V: R88.2, R98.2, R101.2; also elsewhere on the board
CC_ACTIVE: R101.1, R104.2; also elsewhere on the board
CV_ACTIVE: R88.1, R92.2; also elsewhere on the board
GND: C82.1, C83.1, Q16.E, Q18.E, R90.1, R94.1, R97.2, R103.1; also elsewhere on the board
I_SERVO: R106.1; also elsewhere on the board
unnamed: C80.2, Q17.B, R87.1, R93.2, R96.2
unnamed: Q18.B, R99.1, R103.2
unnamed: C81.2, Q17.C, R91.1, R99.2
unnamed: IC15.1 (OUT), IC15.2 (OUT), R92.1
unnamed: Q19.C, R95.1
unnamed: IC15.13 (OUT), IC15.14 (OUT), R104.1
unnamed: C84.1, Q19.B, R100.1, R105.2
unnamed: C81.1, Q16.B, R90.2, R91.2
unnamed: IC15.5 (+IN), IC15.6 (-IN), R86.2
unnamed: IC15.8 (-IN), IC15.11 (+IN), R106.2
unnamed: IC15.7 (+IN), IC15.9 (+IN), R89.1, R94.2
unnamed: R95.2, R96.1
unnamed: IC15.4 (-IN), IC15.10 (-IN), R97.1, R102.2
OUT+: C80.1, Q17.E, R87.2; also elsewhere on the board
OUT-: C84.2, Q19.E, R105.1; also elsewhere on the board
SENSE+: R93.1; also elsewhere on the board
SENSE-: R100.2; also elsewhere on the board
SENSE_ERR: Q18.C, R98.1; also elsewhere on the board
SENSE_PROT: Q16.C; also elsewhere on the board
U_SERVO: R86.1; also elsewhere on the board
V+: C82.2, IC15.3 (V+), R89.2; also elsewhere on the board
V-: C83.2, IC15.12 (GND), R102.1; also elsewhere on the board

Notes on the sheet:
Constant Voltage (CV) and Constant Current (CC) mode indicator
CC/CV indicators, Sense error detection
Licensed under the TAPR Open Hardware License (www.tapr.org/OHL)
Repository: https://github.com/eez-open
More info at http://www.envox.hr/eez
Remote sense reverse polarity detection

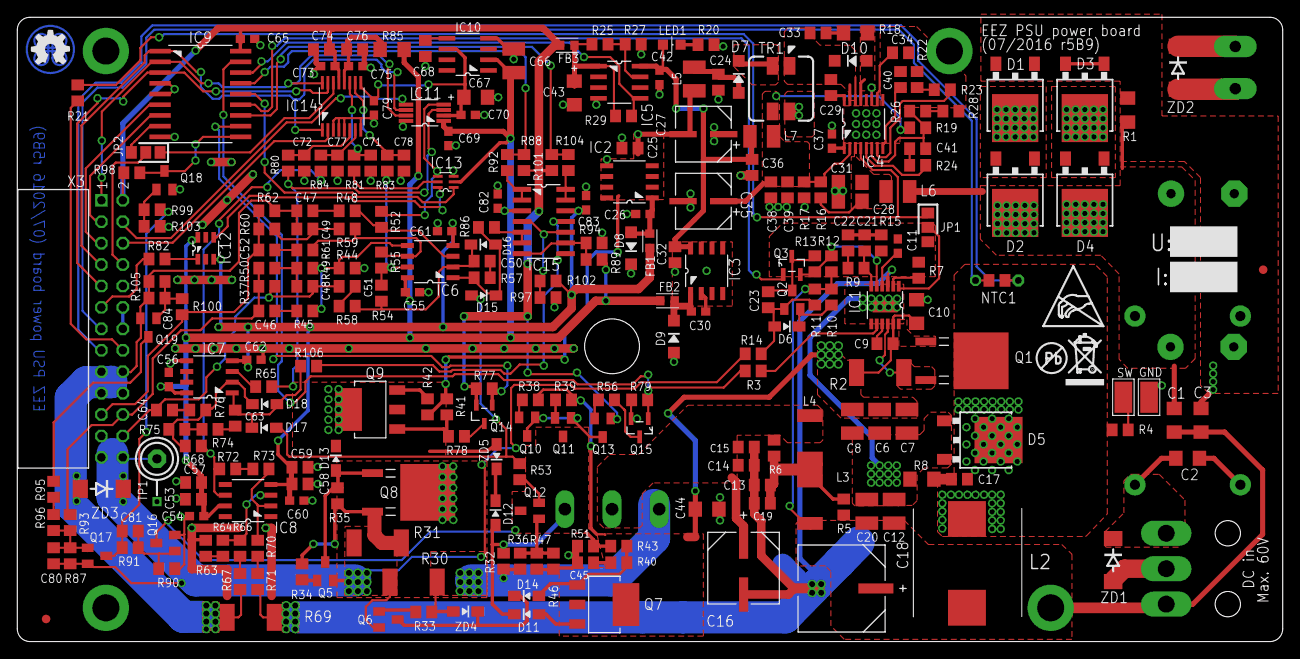
[picture p90: board EEZ PSU power board r5B9.brd from above]

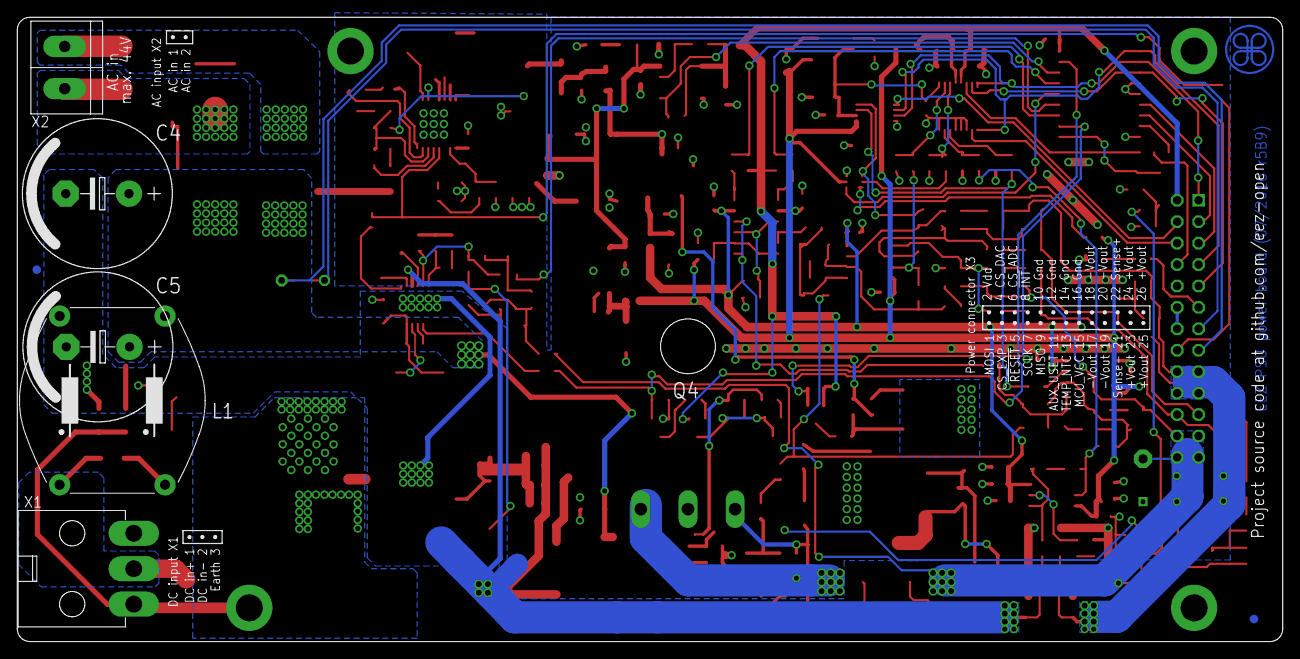
[picture p91: board EEZ PSU power board r5B9.brd from below]

Board: 3 copper layers, 150.0 x 74.0 mm, 276 parts (5 on the bottom side), 159 nets.

Other parts of the board:
EEZ_SIGNATURE: SIGNATURESMALL; SIGNATURE_5MM
U$2: RECYCLE_BIN1/8
U$3: PB_SMALL
U$4: ESD_SYMBOL
