bogdan-tirzioru/Powersupply/reaserch/psu-hw-master/Consolidated/Eagle files/EEZ PSU consolidated r5B9.brd

## EAGLE design reaserch/psu-hw-master/Consolidated/Eagle files/EEZ PSU consolidated r5B9.brd (2020-10-24)


Parts:
C1, C2, C3: 100n; C1206
C4, C5: 2m2; ECAP7.5/18
C6, C7, C8: 4u7; C1210
C9: 470n; C0805
C10: 1u/100V; C1206
C11: 100n; C0603
C12, C20: 10u; C1210
C13: 1u; C0805
C14, C15, C19: n.c.; C0805
C16: EEEFK1J470P; CAPAE830X1050N
C17: 330p; C0805
C18: EEEFK1J101P; PANASONIC_F
C21: 120p; C0805
C22: 4n7; C0805
C23: 470p; C0805
D1, D2, D3, D4: STPS15H100; TO252@1
D5: STPS15H100; TO252
D6: BAS316; SOD323-W
FM1, FM2: FIDUCIAL_2; FIDUCIAL_DUAL
GND: S1751-46R
IC1: LTC3864EMSE#PBF; LTC_05-08-1666
JP1: 0R-JUMPA; A0R-JMP
L1: RN114-4/02; RN114
L2: 7443551331; WE-HCI_1350/1365
L3, L4: IHLP2020CZER3R3M11; IHLP-2020BZ-11
Q1: SUD19P06-60; TO229P990X239-3N
Q2: MMBT5401; SOT23-BEC
Q3: 2N7002; SOT103P240X110-3N
R1: 12K; R1206
R2: R010/2W; R2512
R3: 0R; R0805
R4: 1K; R0805
R5, R6: 100R; R0805
R7: 47K; R0805
R8: 10R; R1206
R9, R10: 10K; R0805
R11, R14: 100K; R0805
R12: 330K; R0805
R13: n.c.; R0805
R15: 4K7; R0805
SH1: Pgnd to Pout- short; SHORT_NOHOLE
SH2: Sgnd to Pgnd short; SHORT_NOHOLE
SW: S1751-46R
X1: 39303035; MINIFIT_6659-3
X2: 282836-2; TBLOCK5.0_2
ZD1, ZD2: n.c.; DO214AA

Connections:
!SET_100%: Q3.1 (G); also elsewhere on the board
AC_IN1: D3.3 (C), D4.1 (A1), D4.2 (A2), X2.1, ZD2.A (2)
AC_IN2: D1.3 (C), D2.1 (A1), D2.2 (A2), X2.2, ZD2.C (1)
DC+: C2.2, L1.2 (1), X1.1, ZD1.C (1)
DC-: C2.1, L1.1, X1.2, ZD1.A (2)
DC_OUT: C1.2, C4.+, C5.+, C6.1, C7.1, C8.1, C9.2, C10.1, D2.3 (C), D4.3 (C), IC1.11 (VIN), L1.3 (2), R1.1, R2.1; also elsewhere on the board
EARTH: C1.1, C3.2, X1.3; also elsewhere on the board
FB: IC1.5 (VFB), Q3.2 (S), R12.2, R13.2, R15.1
GND: C3.1, C4.-, C5.-, C6.2, C7.2, C8.2, C10.2, C12.2, C18.2 (-), C20.2, D1.1 (A1), D1.2 (A2), D3.1 (A1), D3.2 (A2), D5.1 (A), D5.2 (A), GND.P$1, IC1.TP (PGND), L1.4 (2), R1.2, R8.1, SH1.P$2 (GND_B), SH2.P$2 (GND_B); also elsewhere on the board
L_OUT: C12.1, C18.1 (+), C20.1, L2.2, L3.1, R5.1, R10.1, R11.1, R12.1
MODE: IC1.1 (PLLIN/MODE), JP1.2
unnamed: R4.2, SW.P$1
unnamed: D6.C, Q2.E, R10.2
unnamed: C21.1, IC1.6 (ITH), R9.2
unnamed: C22.1, R9.1
unnamed: C9.1, IC1.9 (CAP)
unnamed: IC1.12 (GATE), Q1.1 (G)
unnamed: IC1.2 (FREQ), R7.1
unnamed: C11.2, IC1.4 (SS)
unnamed: C23.1, Q2.C, Q3.3 (D), R13.1
unnamed: C13.1, C19.2, L3.2, L4.1, R5.2, R6.1
unnamed: IC1.8 (RUN), R3.1
unnamed: C17.2, R8.2
unnamed: C23.2, D6.A, Q2.B, R11.2, R14.1
OUT+: R14.2; also elsewhere on the board
POUT-: C13.2, C14.2, C15.2, C16.2, C19.1, SH1.P$1 (GND_A); also elsewhere on the board
PREG_OUT: C14.1, C15.1, C16.1, L4.2, R6.2; also elsewhere on the board
PRE_OE: R3.2; also elsewhere on the board
SENSE: IC1.10 (SENSE), Q1.3 (S), R2.2
SGND: C11.1, C21.2, C22.2, IC1.3 (SGND), JP1.1, R7.2, R15.2, SH2.P$1 (GND_A)
SW: C17.1, D5.3 (C), L2.1, Q1.2 (D), R4.1
SYNC: JP1.3; also elsewhere on the board

Notes on the sheet:
47u
2 x UVZ1H222MHD or UVR1J222MHD
Licensed under the TAPR Open Hardware License (www.tapr.org/OHL)
Repository: https://github.com/eez-open
More info at http://www.envox.hr/eez
SMPS power pre-regulator with 100% duty cycle
100u
DC input option
AC input option


Parts:
C24, C36, C38: 2u2; C0805
C25, C32: 470n; C0805
C26, C30, C37, C42: 100n; C0603
C27, C35: 47u; CAPAE660X610N
C28, C31: 1u/100V; C1206
C29: 22n; C0805
C33: 330p; C0805
C34: 10n; C0805
C39: n.c.; C0805
C40: 3n3; C0805
C41: 1n; C0805
C43: 4u7; EC1206
D7, D10: DFLS1100-7; SOD123
D8, D9: SKL16; SOD123
FB1, FB2, FB3: 60R@100MHz; BEAD0603
IC2: MC79L05; SOIC127P600X173-8N
IC3: MC78L05; SOIC127P600X173-8N
IC4: LM5574MTX/NOPB; SOP65P640X110-16N
IC5: LP2951SO8; SOIC127P600X175-8N
L5, L6, L7: 2u2; L1210
LED1: HSMY-C170; LED_0805
R16, R19: 47K; R0805
R17: 2K2; R0805
R18: 10R; R1206
R20: 470R; R0805
R21: 0R; R0805
R22, R23, R29: 10K; R0805
R24: 51K; R0805
R25: 16K; R0805
R26: 5K6; R0805
R27: 5K1; R0805
R28: 1K8; R0805
TR1: SRF0703-821M; SRF0703
X3: SSW-113-02-T-D-RA; FARNELL 1805583

Connections:
+5V: FB3.P$2 (2); also elsewhere on the board
+VNR: C32.1, C36.1, C42.1, IC3.8 (VI), IC5.8 (IN), L7.2, LED1.A
-9V: C25.2, C27.2 (-), IC2.2 (IN), IC2.3 (IN), IC2.6 (IN), IC2.7 (IN), L5.2; also elsewhere on the board
DC_OUT: L6.1; also elsewhere on the board
DC_PREG1: C28.1, C31.1, IC4.3 (VIN), L6.2, R16.2
GND: C24.2, C25.1, C26.1, C27.1 (+), C28.2, C30.2, C31.2, C32.2, C34.2, C35.2 (-), C36.2, C37.1, C38.2, C39.2, C40.1, C42.2, C43.-, D8.C, D9.A, IC2.5 (GND), IC3.2 (GND), IC3.3 (GND), IC3.6 (GND), IC3.7 (GND), IC4.9 (AGND), IC4.12 (PGND), IC5.4 (GND), R17.1, R20.2, R22.2, R27.2, R28.1, TR1.4; also elsewhere on the board
IS: D10.A, IC4.13 (IS), R18.1
unnamed: C26.2, D8.A, FB1.P$1 (1), IC2.1 (OUT)
unnamed: C30.1, D9.C, FB2.P$1 (1), IC3.1 (VO)
unnamed: C43.+, FB3.P$1 (1), IC5.1 (OUT), R25.1, R29.1
unnamed: R21.2, X3.16
unnamed: LED1.C, R20.1
unnamed: C33.2, R18.2
unnamed: IC5.7 (FB), R25.2, R27.1
unnamed: C41.2, R24.2
unnamed: R26.2, R28.2
unnamed: R22.1, R23.2
unnamed: C41.1, IC4.6 (FB), R19.2, R26.1
unnamed: C29.2, IC4.16 (BST)
unnamed: IC4.5 (COMP), R24.1
unnamed: IC4.7 (RT), R23.1
unnamed: C37.2, IC4.1 (VCC)
unnamed: C40.2, IC4.8 (RAMP)
unnamed: C34.1, IC4.10 (SS)
unnamed: C24.1, D7.A, L5.1
unnamed: IC4.2 (SD), R16.1, R17.2
PWRGOOD: IC5.5 (!ERROR), R29.2; also elsewhere on the board
SW1: C29.1, C33.1, D10.C, IC4.14 (SW), IC4.15 (PRE), TR1.1
SYNC: IC4.4 (SYNC), R21.1; also elsewhere on the board
V+: FB2.P$2 (2); also elsewhere on the board
V-: FB1.P$2 (2); also elsewhere on the board
VOUT+: C35.1 (+), C38.1, C39.1, IC4.11 (OUT), L7.1, R19.1, TR1.3
VOUT-: D7.C, TR1.2

Notes on the sheet:
(LQH32PN2R2NN0L)
Bias power supply with SMPS pre-regulator
Yellow
Licensed under the TAPR Open Hardware License (www.tapr.org/OHL)
Repository: https://github.com/eez-open
More info at http://www.envox.hr/eez
