bogdan-tirzioru/Powersupply/reaserch/psu-hw-master/Consolidated/Eagle files/EEZ PSU consolidated r5B9.brd

## EAGLE design reaserch/psu-hw-master/Consolidated/Eagle files/EEZ PSU consolidated r5B9.brd (continued)


Parts:
C44: 1u/100V; C1206
C45, C53, C58: 10n; C0805
C46, C52: 47p; C0805
C47, C51, C63, C64: 1n; C0805
C48, C49: 2n2; C0805
C50: 120p; C0805
C54, C55, C56, C60, C61, C62: 100n; C0603
C57, C59: 1u; C0805
D11, D12, D13, D14, D15, D16, D17, D18: BAS316; SOD323-W
IC6, IC7: TL072D; SOIC127P600X173-8N
IC8: OP27GSZ; SOIC127P600X173-8N
NTC1: 10K/Beta:3570K; R_0204/5+0805
Q4: IRFP250N; TO247BH-CLR
Q5: BC857C; SOT23-BEC
Q6: BC846C; SOT23-BEC
Q7, Q9: BCP56-16.115; SOT230P700X180-4N
Q8: IRFR5410; TO229P990X239-3N
Q10, Q11: MMBT5401; SOT23-BEC
Q12, Q13: MMBT5551; SOT23-BEC
R30: R080/3W; R2512
R31: 2R2/2W; R2512
R32, R34, R35, R37, R46, R62, R65, R68: 2K2; R0805
R33, R41, R74: 1K; R0805
R36: 16K; R0805
R38, R39, R42, R48, R58: 220R; R0805
R40, R53: 470R; R0805
R43: 100R; R0805
R44, R55: 7K5 0.1%; R0805
R45, R52, R54, R61, R75, R76: 10K; R0805
R47: 750R; R0805
R49, R59: 100K 0.1%; R0805
R50, R60: 20K 0.1%; R0805
R51: 51K; R0805
R56: 1K8; R0805
R57: 0R; R0805
R63, R73: 180R 0.1%; R0805
R64, R72: 2K37 0.1%; R0805
R66, R67, R70, R71: 51R 0.1%; R0805
R69: R020/2W; R2512
TP1: TEST_POINT; TP_1.1MM
X3: SSW-113-02-T-D-RA; FARNELL 1805583
ZD3: See Note 3.2; DO214AA
ZD4: BZX384-C15.115; SOD323-W
ZD5: PDZ6.2B; SOD323-W

Connections:
!DP_DRIVE: Q9.1 (B), R41.1; also elsewhere on the board
+5V: Q13.B; also elsewhere on the board
-9V: R41.2, R42.2; also elsewhere on the board
DC_OUT: C44.1, Q7.2 (C), Q7.4 (C), R38.2, R39.2; also elsewhere on the board
GND: C44.2, C45.2, C53.1, C54.2, C55.1, C56.1, C57.1, C58.1, C59.1, C60.2, C61.1, C62.1, IC7.5 (+IN), Q8.2 (D), R44.1, R46.1, R47.1, R51.1, R63.1, TP1.GND; also elsewhere on the board
ISENSE+: IC8.3 (+IN), R64.2, R66.2
ISENSE-: IC8.2 (-IN), R70.2, R73.1
I_MON: IC8.6 (OUT), R68.1, R72.2; also elsewhere on the board
I_SERVO: C63.2, D17.C, D18.A, IC7.1 (OUT); also elsewhere on the board
I_SET: R65.1; also elsewhere on the board
MCU_VCC: NTC1.2, NTC1.2.1, X3.15
unnamed: Q9.3 (E), R42.1
unnamed: Q5.B, R34.2
unnamed: C46.2, R45.1
unnamed: R66.1, R67.2
unnamed: C52.2, R61.1
unnamed: R70.1, R71.2
unnamed: R72.1, R73.2
unnamed: R63.2, R64.1
unnamed: IC7.6 (-IN), IC7.7 (OUT)
unnamed: C49.1, R59.2, R60.1
unnamed: C50.2, R57.1
unnamed: C64.2, R76.1
unnamed: C47.2, R48.1
unnamed: C51.2, R58.1
unnamed: IC6.3 (+IN), R48.2, R52.2
unnamed: C50.1, D16.C, IC6.2 (-IN), R54.2, R58.2
unnamed: D18.C, IC7.2 (-IN), R68.2, R75.2, R76.2
unnamed: Q12.B, R36.1, R46.2, R47.2
unnamed: IC7.3 (+IN), R65.2
unnamed: D15.A, D17.A, R53.1
unnamed: D11.C, D12.A, Q4.G, R32.1
unnamed: D11.A, Q7.3 (E)
unnamed: D14.A, Q7.1 (B), R40.2, R43.1
unnamed: C45.1, R40.1
unnamed: C48.1, R49.2, R50.1
unnamed: D14.C, Q6.C, ZD4.C
unnamed: D12.C, ZD5.C
unnamed: Q12.E, R53.2
unnamed: Q8.3 (S), R31.1, R34.1, R35.1
unnamed: D13.A, Q5.C, Q8.1 (G), R35.2
unnamed: IC6.5 (+IN), R44.2, R45.2, R49.1
unnamed: IC6.6 (-IN), R55.2, R59.1, R61.2
unnamed: R74.2, R75.1
unnamed: C63.1, R74.1
unnamed: Q11.E, R39.1
unnamed: Q10.E, R38.1
unnamed: Q13.E, R56.2
unnamed: Q6.B, R33.1
OUT+: C48.2, C51.1, C64.1, Q5.E, Q6.E, R30.2, R31.2, R37.1, TP1.TIP, X3.23, X3.24, X3.25, X3.26, ZD3.C (1); also elsewhere on the board
OUT-: C47.1, C49.2, R62.2, R67.1, R69.1, X3.17, X3.18, X3.19, X3.20, ZD3.A (2); also elsewhere on the board
POST_OE: R56.1; also elsewhere on the board
POUT-: R69.2, R71.1; also elsewhere on the board
PREG_OUT: Q4.D; also elsewhere on the board
Q4_OUT: Q4.S, R30.1, R32.2, R33.2, R36.2, ZD4.A
Q7C: Q10.B, Q10.C, Q11.B, Q13.C
Q9C: D13.C, Q9.2 (C), Q9.4 (C), ZD5.A
SENSE+: C46.1, R37.2, R50.2, X3.22; also elsewhere on the board
SENSE-: C52.1, R60.2, R62.1, X3.21; also elsewhere on the board
SENSE_PROT: Q11.C, Q12.C, R43.2, R51.2; also elsewhere on the board
TEMP_NTC: NTC1.1, NTC1.1.1, X3.13
U_MON: IC6.7 (OUT), R54.1, R55.1; also elsewhere on the board
U_SERVO: D15.C, D16.A, IC6.1 (OUT), R57.2; also elsewhere on the board
U_SET_OUT: R52.1; also elsewhere on the board
V+: C53.2, C54.1, C55.2, C56.2, C57.2, IC6.8 (V+), IC7.8 (V+), IC8.7 (V+); also elsewhere on the board
V-: C58.2, C59.2, C60.1, C61.2, C62.2, IC6.4 (V-), IC7.4 (V-), IC8.4 (V-); also elsewhere on the board

Notes on the sheet:
Current control loop
Voltage control loop
CV/CC linear post-regulator
Output enable and "down-programmer"
Down-programmer
Not used
Licensed under the TAPR Open Hardware License (www.tapr.org/OHL)
Repository: https://github.com/eez-open
More info at http://www.envox.hr/eez
Temperature sensor


Parts:
C65, C69, C70, C73, C75, C79: 100n; C0603
C66: 10u; C1210
C67: 10u; EC1206
C68, C74, C76: 1u; C0805
C71, C72, C77, C78: 3n3; C0805
IC9: MCP23S08-E/SO; SOIC127P1030X265-18N
IC10: REF5025AIDG4; SOIC127P600X175-8N
IC11: DAC8552IDGKTG4; DGK8-M
IC12: ADG465SOT-23; SOT95P280X145-6N
IC13: TS5A9411DCKT; SOT65P210X110-6N
IC14: ADS1120IPWR; PW(R-PDSO-G16)
JP2: 0R-JUMPA; A0R-JMP
Q14: BSS84P; SOT95P237X112-3N
Q15: 2N7002; SOT103P240X110-3N; MPN 2N7002-7-F
R77, R79: 100K; R0805
R78: 10K; R0805
R80, R81, R83, R84: 220R; R0805
R82: 1K; R0805
R85: 10R; R1206
X3: SSW-113-02-T-D-RA; FARNELL 1805583

Connections:
!DP_DRIVE: R78.1; also elsewhere on the board
!INT: JP2.2, X3.8
!PS_DRDY: IC14.14 (!DRDY), JP2.3
!PS_RESET: IC9.6 (!RESET), X3.5
!SET_100%: IC9.13 (GP3); also elsewhere on the board
!SET_DP: IC9.11 (GP1), Q14.1 (G), R77.2
+5V: C65.1, C73.2, C74.2, IC9.18 (VDD), IC14.13 (DVDD), Q14.2 (S), R77.1, X3.2; also elsewhere on the board
+VREF: C67.+, C70.2, C79.2, IC10.6 (VOUT), IC11.2 (VREF), IC14.9 (REFP0)
AUX_USET_IN: R82.2, X3.11
AUX_USET_SW: IC9.14 (GP4), IC13.1 (IN)
CC_ACTIVE: IC9.12 (GP2); also elsewhere on the board
CS_ADC: IC14.2 (!CS), X3.6
CS_DAC: IC11.5 (!SYNC), X3.4
CS_EXPANDER: IC9.7 (!CS), X3.3
CV_ACTIVE: IC9.15 (GP5); also elsewhere on the board
DP_LED: Q14.3 (D), R78.2
GND: C65.2, C66.2, C67.-, C68.2, C69.1, C70.1, C71.1, C72.2, C73.1, C74.1, C75.1, C76.1, C77.1, C78.1, C79.1, IC9.4 (A1), IC9.5 (A0), IC9.9 (VSS), IC10.4 (GND), IC11.8 (GND), IC13.3 (GND), IC14.3 (CLK), IC14.4 (DGND), IC14.5 (AVSS), IC14.8 (REFN0), Q15.2 (S), R79.1, X3.10, X3.12, X3.14; also elsewhere on the board
INT_EXP: IC9.8 (INT), JP2.1
I_MON: R84.1; also elsewhere on the board
I_SET: IC11.3 (VOUTB), R80.1; also elsewhere on the board
unnamed: IC12.4 (VS), IC13.6 (S1)
unnamed: C68.1, IC10.5 (TRIM/NR)
unnamed: IC12.1 (VD), R82.1
unnamed: C78.2, IC14.10 (AIN1), R83.2
unnamed: C71.2, IC14.11 (AIN0/REFP1), R81.2
unnamed: C75.2, C76.2, IC14.12 (AVDD), R85.2
unnamed: C72.1, IC14.6 (AIN3/REFN1), R80.2
unnamed: C77.2, IC14.7 (AIN2), R84.2
POST_OE: Q15.3 (D); also elsewhere on the board
PRE_OE: IC9.17 (GP7), Q15.1 (G), R79.2; also elsewhere on the board
PS_MISO: IC9.3 (SO), IC14.15 (DOUT/!DRDY), X3.9
PS_MOSI: IC9.2 (SI), IC11.7 (DIN), IC14.16 (DIN), X3.1
PS_SCLK: IC9.1 (SCK), IC11.6 (SCLK), IC14.1 (SCLK), X3.7
PWRGOOD: IC9.16 (GP6); also elsewhere on the board
SENSE_ERR: IC9.10 (GP0); also elsewhere on the board
U_MON: R83.1; also elsewhere on the board
U_SET: IC13.5 (D), R81.1
U_SET_OUT: IC11.4 (VOUTA), IC13.4 (S2); also elsewhere on the board
V+: C66.1, C69.2, IC10.2 (VIN), IC11.1 (VDD), IC12.6 (VDD), IC13.2 (VDD), R85.1; also elsewhere on the board
V-: IC12.3 (VSS); also elsewhere on the board

Notes on the sheet:
SPI I/O expander, DAC, ADC, Voltage reference
Voltage reference
Licensed under the TAPR Open Hardware License (www.tapr.org/OHL)
Repository: https://github.com/eez-open
More info at http://www.envox.hr/eez
Remote programming


Parts:
C80, C84: 10n; C0805
C81: 2n2; C0805
C82, C83: 100n; C0603
IC15: LP339D; SOIC127P600X175-14N
Q16, Q18, Q19: MMBT5551; SOT23-BEC
Q17: MMBT5401; SOT23-BEC
R86, R98, R99, R106: 10K; R0805
R87, R105: 330R; R0805
R88, R101: 5K1; R0805
R89, R90, R91, R103: 47K; R0805
R92, R102, R104: 5K6; R0805
R93, R100: 750R; R0805
R94, R96: 2K2; R0805
R95: 1K; R0805
R97: 4K7; R0805

Connections:
+5V: R88.2, R98.2, R101.2; also elsewhere on the board
CC_ACTIVE: R101.1, R104.2; also elsewhere on the board
CV_ACTIVE: R88.1, R92.2; also elsewhere on the board
GND: C82.1, C83.1, Q16.E, Q18.E, R90.1, R94.1, R97.2, R103.1; also elsewhere on the board
I_SERVO: R106.1; also elsewhere on the board
unnamed: C80.2, Q17.B, R87.1, R93.2, R96.2
unnamed: Q18.B, R99.1, R103.2
unnamed: C81.2, Q17.C, R91.1, R99.2
unnamed: IC15.1 (OUT), IC15.2 (OUT), R92.1
unnamed: Q19.C, R95.1
unnamed: IC15.13 (OUT), IC15.14 (OUT), R104.1
unnamed: C84.1, Q19.B, R100.1, R105.2
unnamed: C81.1, Q16.B, R90.2, R91.2
unnamed: IC15.5 (+IN), IC15.6 (-IN), R86.2
unnamed: IC15.8 (-IN), IC15.11 (+IN), R106.2
unnamed: IC15.7 (+IN), IC15.9 (+IN), R89.1, R94.2
unnamed: R95.2, R96.1
unnamed: IC15.4 (-IN), IC15.10 (-IN), R97.1, R102.2
OUT+: C80.1, Q17.E, R87.2; also elsewhere on the board
OUT-: C84.2, Q19.E, R105.1; also elsewhere on the board
SENSE+: R93.1; also elsewhere on the board
SENSE-: R100.2; also elsewhere on the board
SENSE_ERR: Q18.C, R98.1; also elsewhere on the board
SENSE_PROT: Q16.C; also elsewhere on the board
U_SERVO: R86.1; also elsewhere on the board
V+: C82.2, IC15.3 (V+), R89.2; also elsewhere on the board
V-: C83.2, IC15.12 (GND), R102.1; also elsewhere on the board

Notes on the sheet:
Constant Voltage (CV) and Constant Current (CC) mode indicator
CC/CV indicators, Sense error detection
Licensed under the TAPR Open Hardware License (www.tapr.org/OHL)
Repository: https://github.com/eez-open
More info at http://www.envox.hr/eez
Remote sense reverse polarity detection

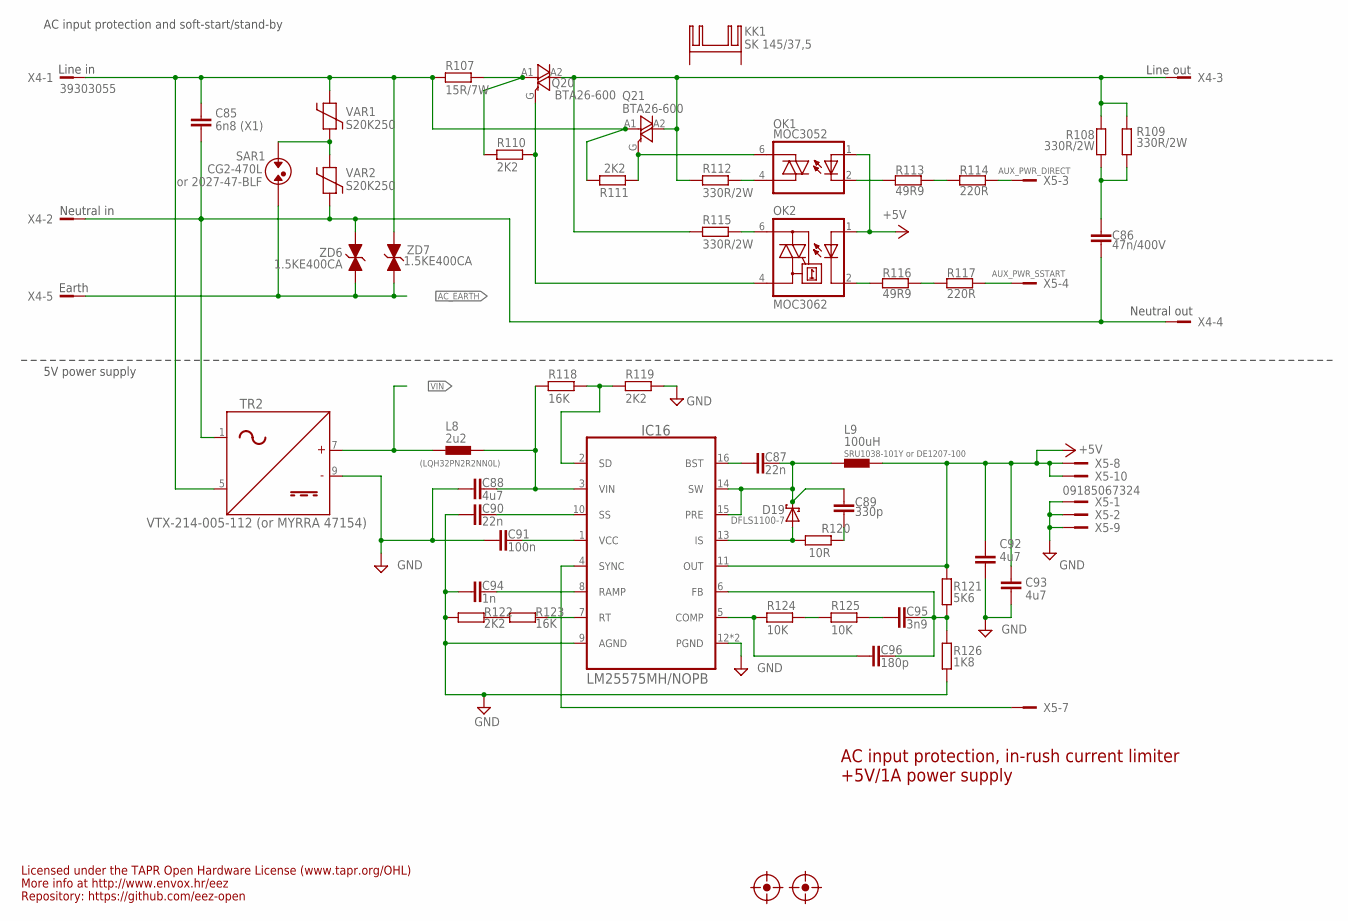
[picture p92: schematic EEZ PSU consolidated r5B9.sch, sheet 6, AC soft-start, +5V power]

Parts:
C85: 6n8 (X1); C102-064X133
C86: 47n/400V; C075-052X106
C87, C90: 22n; C0805
C88, C92, C93: 4u7; C1210
C89: 330p; C0805
C91: 100n; C0603
C94: 1n; C0805
C95: 3n9; C0805
C96: 180p; C0805
D19: DFLS1100-7; SOD123
FM3, FM4: FIDUCIAL_2; FIDUCIAL_DUAL
IC16: LM25575MH/NOPB; SOP65P640X110-17N
KK1: SK 145/37,5; SK145
L8: 2u2; L1210
L9: 100uH; MSS1278
OK1: MOC3052; DIL6-SMD
OK2: MOC3062; DIL6-SMD; MPN MOC3033S-M
Q20, Q21: BTA26-600; TOP3S-1
R107: 15R/7W; R_0913
R108, R109, R112, R115: 330R/2W; R2512
R110, R111, R119, R122: 2K2; R0805
R113, R116: 49R9; R0805
R114, R117: 220R; R0805
R118, R123: 16K; R0805
R120: 10R; R1206
R121: 5K6; R0805
R124, R125: 10K; R0805
R126: 1K8; R0805
SAR1: CG2-470L; SAR
TR2: VTX-214-005-112 (or MYRRA 47154); PCB_ACDC_MYRRA_5W
VAR1, VAR2: S20K250; VARISTOR
X4: 39303055; MINIFIT_6659-5
X5: 09185067324; IDC-10PIN
ZD6, ZD7: 1.5KE400CA; DO201-BIDIR

Connections:
+5V: C92.1, C93.1, IC16.11 (OUT), L9.2, OK1.1 (A), OK2.1 (A), R121.1, X5.8, X5.10; also elsewhere on the board
AC_EARTH: SAR1.P$2, X4.5, ZD6.C (1), ZD7.C (1); also elsewhere on the board
AC_IN1_MAIN: C85.1, Q21.A1, R107.1, R111.2, TR2.5 (IN2), VAR1.P$2, X4.1, ZD7.A (2)
AC_IN2_MAIN: C85.2, C86.1, TR2.1 (IN1), VAR2.P$1, X4.2, X4.4, ZD6.A (2)
AUX_PWR_DIRECT: R114.2, X5.3
AUX_PWR_SSTART: R117.2, X5.4
DC_PREG2: C88.1, IC16.3 (VIN), L8.2, R118.2
GND: C88.2, C90.2, C91.1, C92.2, C93.2, C94.1, IC16.9 (AGND), IC16.12 (PGND), IC16.TP (PGND), R119.1, R122.2, R126.2, TR2.9 (-), X5.1, X5.2, X5.9; also elsewhere on the board
IS1: D19.A, IC16.13 (IS), R120.1
unnamed: C95.2, R125.2
unnamed: C95.1, C96.1, IC16.6 (FB), R121.2, R126.1
unnamed: C87.2, IC16.16 (BST)
unnamed: C96.2, IC16.5 (COMP), R124.1
unnamed: IC16.7 (RT), R123.1
unnamed: C91.2, IC16.1 (VCC)
unnamed: C94.2, IC16.8 (RAMP)
unnamed: C90.1, IC16.10 (SS)
unnamed: IC16.4 (SYNC), X5.7
unnamed: IC16.2 (SD), R118.1, R119.2
unnamed: C89.2, R120.2
unnamed: OK1.6 (A2), Q21.G, R111.1
unnamed: OK2.4 (A1), Q20.G, R110.2
unnamed: OK2.6 (A2), R115.1
unnamed: R113.2, R114.1
unnamed: R116.2, R117.1
unnamed: OK1.4 (A1), R112.1
unnamed: Q20.A2, Q21.A2, R108.1, R109.1, R112.2, R115.2, X4.3
unnamed: C86.2, R108.2, R109.2
unnamed: SAR1.P$1, VAR1.P$1, VAR2.P$2
unnamed: Q20.A1, R107.2, R110.1
unnamed: R122.1, R123.2
unnamed: R124.2, R125.1
unnamed: OK2.2 (C), R116.1
unnamed: OK1.2 (C), R113.1
SW2: C87.1, C89.1, D19.C, IC16.14 (SW), IC16.15 (PRE), L9.1
VIN: L8.1, TR2.7 (+); also elsewhere on the board

Notes on the sheet:
AC input protection, in-rush current limiter
+5V/1A power supply
Line in
Neutral in
Earth
SRU1038-101Y or DE1207-100
Line out
Neutral out
or 2027-47-BLF
(LQH32PN2R2NN0L)
Licensed under the TAPR Open Hardware License (www.tapr.org/OHL)
Repository: https://github.com/eez-open
More info at http://www.envox.hr/eez
5V power supply
AC input protection and soft-start/stand-by

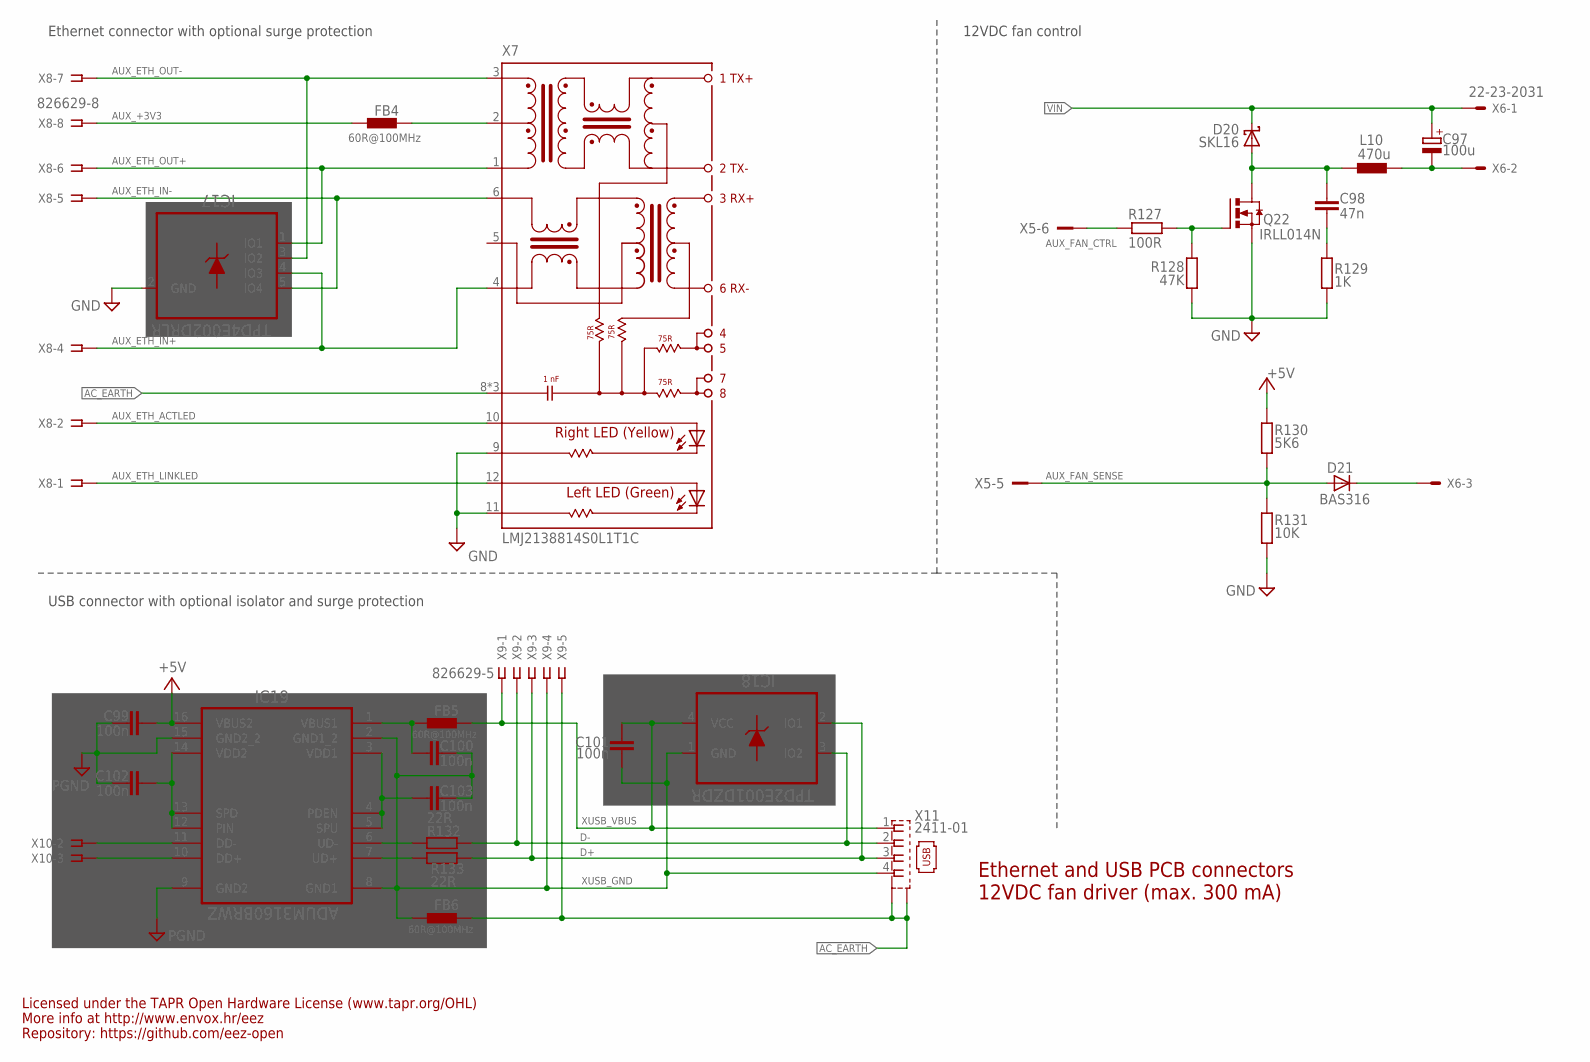
[picture p93: schematic EEZ PSU consolidated r5B9.sch, sheet 7, Ethernet, USB, Fan]

Parts:
C97: 100u; CAPAE660X610N
C98: 47n; C0805
C99, C100, C101, C102, C103: 100n; C0603
D20: SKL16; SOD123
D21: BAS316; SOD323-W
FB4, FB5, FB6: 60R@100MHz; BEAD0603
IC17: TPD4E002DRLR; SOT50P280X60-5N
IC18: TPD2E001DZDR; SOP192P292X122-4N
IC19: ADUM3160BRWZ; SOIC-16W
L10: 470u; DE0704
Q22: IRLL014N; SOT223
R127: 100R; R0805
R128: 47K; R0805
R129: 1K; R0805
R130: 5K6; R0805
R131: 10K; R0805
R132, R133: 22R; R0805
X5: 09185067324; IDC-10PIN
X6: 22-23-2031
X7: LMJ2138814S0L1T1C; RJ45-VERT
X8: 826629-8; SSW-108-02-S-S
X9, X10: 826629-5; SSW-105-02-S-S
X11: 2411-01; KUSBVX-BS1N

Connections:
+5V: C99.1, IC19.16 (VBUS2), R130.1; also elsewhere on the board
AC_EARTH: FB6.P$1 (1), X7.8 (SH), X7.SH1 (SH), X7.SH2 (SH), X9.5, X11.M1 (S1), X11.M2 (S2); also elsewhere on the board
AUX_+3V3: FB4.P$2 (2), X8.8
AUX_ETH_ACTLED: X7.10 (YELLOW_A), X8.2
AUX_ETH_IN+: IC17.4 (IO3), X7.4 (RD-), X8.4
AUX_ETH_IN-: IC17.5 (IO4), X7.6 (RD+), X8.5
AUX_ETH_LINKLED: X7.12 (GREEN-A), X8.1
AUX_ETH_OUT+: IC17.1 (IO1), X7.1 (TD-), X8.6
AUX_ETH_OUT-: IC17.3 (IO2), X7.3 (TD+), X8.7
AUX_FAN_CTRL: R127.2, X5.6
AUX_FAN_SENSE: D21.A, R130.2, R131.1, X5.5
D+: IC18.2 (IO1), R133.1, X9.3, X11.3
D-: IC18.3 (IO2), R132.1, X9.2, X11.2
FAN_OUT: C98.2, D20.A, L10.2, Q22.2 (D), Q22.4 (D)
GND: C99.2, C102.2, IC17.2 (GND), IC19.9 (GND2), IC19.15 (GND2_2), Q22.3 (S), R128.1, R129.1, R131.2, X7.9 (YELLOW-C), X7.11 (GREEN-C); also elsewhere on the board
MCU_D+: IC19.10 (DD+), X10.3
MCU_D-: IC19.11 (DD-), X10.2
unnamed: C98.1, R129.2
unnamed: Q22.1 (G), R127.1, R128.2
unnamed: C97.2 (-), L10.1, X6.2
unnamed: C103.1, IC19.3 (VDD1), IC19.4 (PDEN), IC19.5 (SPU)
unnamed: IC19.6 (UD-), R132.2
unnamed: IC19.7 (UD+), R133.2
unnamed: C100.1, FB5.P$2 (2), IC19.1 (VBUS1)
unnamed: C102.1, IC19.12 (PIN), IC19.13 (SPD), IC19.14 (VDD2)
unnamed: FB4.P$1 (1), X7.2 (CT)
unnamed: D21.C, X6.3
VIN: C97.1 (+), D20.C, X6.1; also elsewhere on the board
XUSB_GND: C100.2, C101.1, C103.2, FB6.P$2 (2), IC18.1 (GND), IC19.2 (GND1_2), IC19.8 (GND1), X9.4, X11.4
XUSB_VBUS: C101.2, FB5.P$1 (1), IC18.4 (VCC), X9.1, X11.1

Notes on the sheet:
Ethernet and USB PCB connectors
12VDC fan driver (max. 300 mA)
Licensed under the TAPR Open Hardware License (www.tapr.org/OHL)
Repository: https://github.com/eez-open
More info at http://www.envox.hr/eez
Ethernet connector with optional surge protection
12VDC fan control
USB connector with optional isolator and surge protection

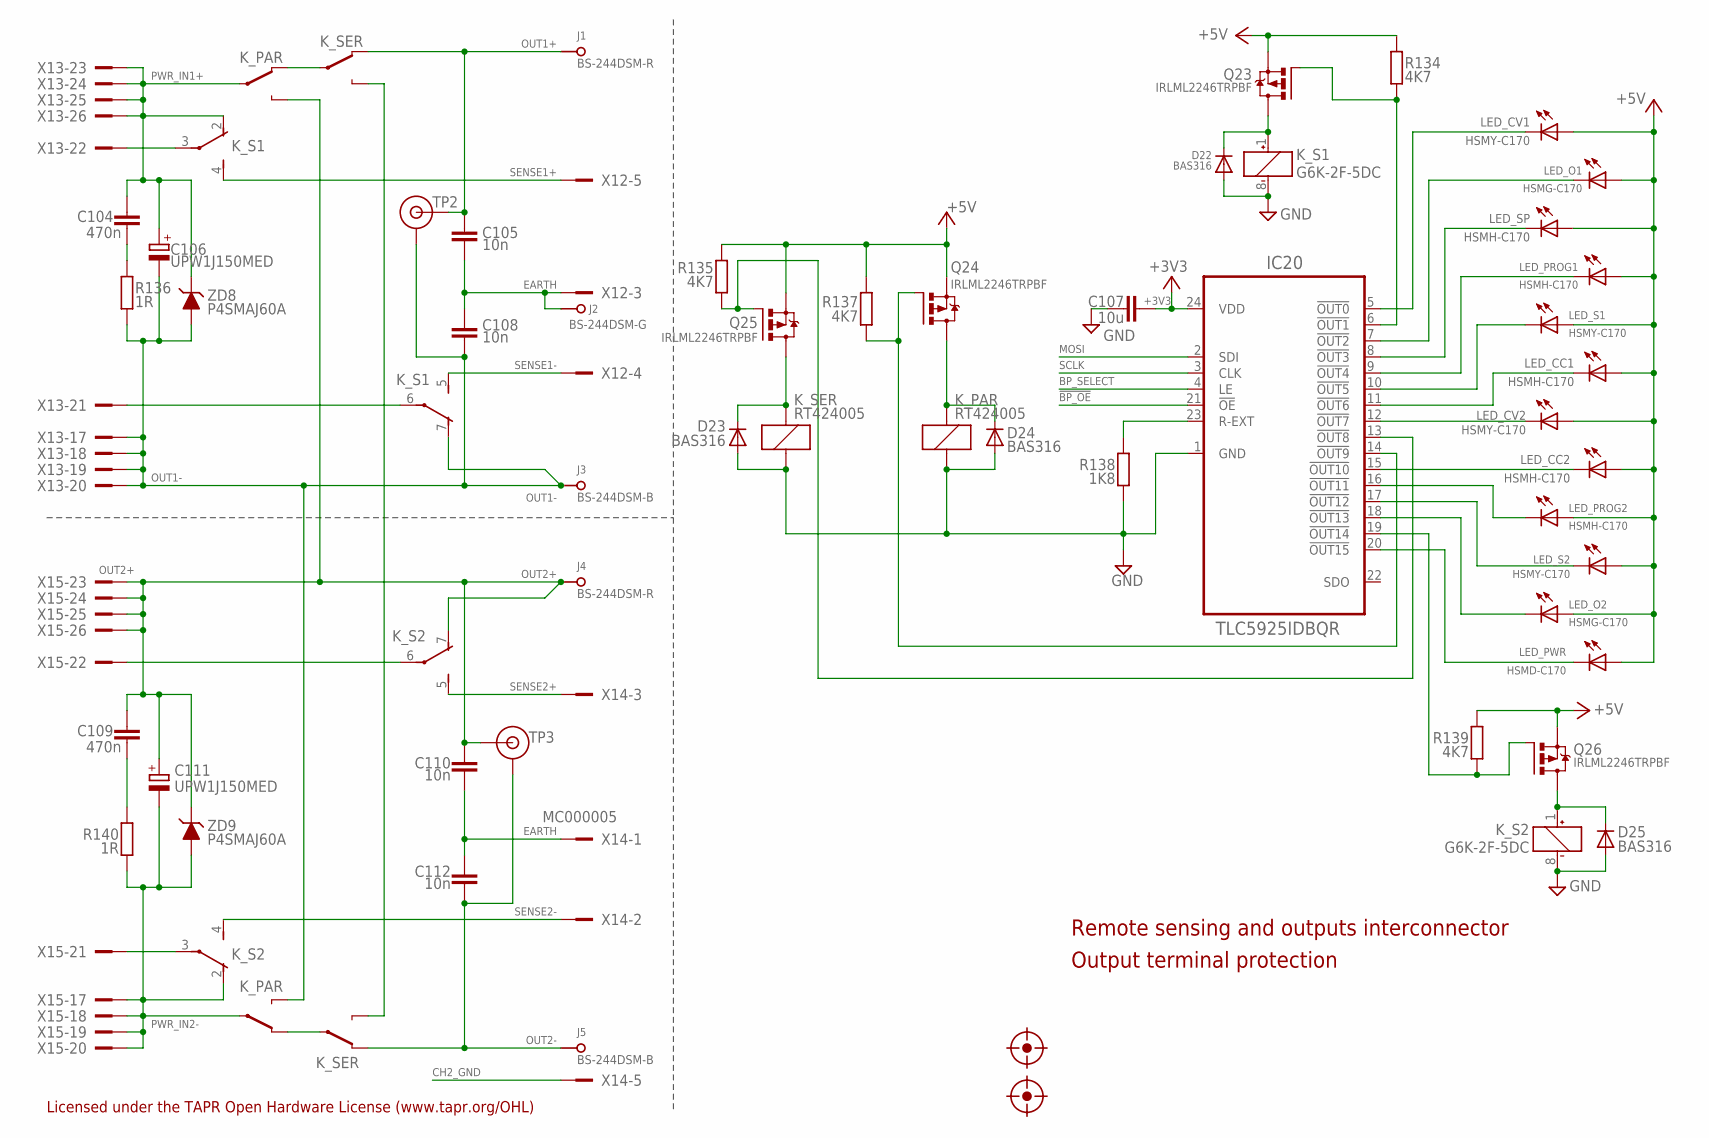
[picture p94: schematic EEZ PSU consolidated r5B9.sch, sheet 8, Binding posts relays, LED driver]

Parts:
C104, C109: 470n; C0805
C105, C108, C110, C112: 10n; C0805
C106, C111: UPW1J150MED; CAPAE660X610N_COMBO2
C107: 10u; C1210
D22, D23, D24, D25: BAS316; SOD323-W
FM5, FM6: FIDUCIAL_2; FIDUCIAL_DUAL
IC20: TLC5925IDBQR; SOP63P600X175-24N
J1, J4: BS-244DSM-R; BP_5_12
J2: BS-244DSM-G; BP_5_12
J3, J5: BS-244DSM-B; BP_5_12
K_PAR: RT424005; RT-C/016A5_ROUND
K_S1, K_S2: G6K-2F-5DC; G6K-2F; MPN G6K-2F DC24
K_SER: RT424005; RT-C/016A5_ROUND
LED_CC1, LED_CC2: HSMH-C170; LED_0805
LED_CV1, LED_CV2: HSMY-C170; LED_0805
LED_O1, LED_O2: HSMG-C170; LED_0805
LED_PROG1, LED_PROG2: HSMH-C170; LED_0805
LED_PWR: HSMD-C170; LED_0805
LED_S1, LED_S2: HSMY-C170; LED_0805
LED_SP: HSMH-C170; LED_0805
Q23, Q24, Q25, Q26: IRLML2246TRPBF; SOT95P237X112-3N
R134, R135, R137, R139: 4K7; R0805
R136, R140: 1R; R0805
R138: 1K8; R0805
TP2, TP3: TEST_POINT; TP_1.1MM
X12: MC000006; MC000006_MIRROR; FARNELL 2007972
X13, X15: TSW-113-07-F-D; FARNELL 2025182
X14: MC000005; MC000005_MIRROR
ZD8, ZD9: P4SMAJ60A; DO214AC

Connections:
!BP_OE: IC20.21 (!OE); also elsewhere on the board
!BP_OUT0: IC20.5 (!OUT0), LED_CV1.C
!BP_OUT1: IC20.6 (!OUT1), Q23.1 (G), R134.1
!BP_OUT2: IC20.7 (!OUT2), LED_O1.C
!BP_OUT3: IC20.8 (!OUT3), LED_SP.C
!BP_OUT4: IC20.9 (!OUT4), LED_PROG1.C
!BP_OUT5: IC20.10 (!OUT5), LED_S1.C
!BP_OUT6: IC20.11 (!OUT6), LED_CC1.C
!BP_OUT7: IC20.12 (!OUT7), LED_CV2.C
!BP_OUT8: IC20.13 (!OUT8), Q25.1 (G), R135.1
!BP_OUT9: IC20.14 (!OUT9), Q24.1 (G), R137.1
!BP_OUT10: IC20.15 (!OUT10), LED_CC2.C
!BP_OUT12: IC20.17 (!OUT12), LED_S2.C
!BP_OUT13: IC20.18 (!OUT13), LED_O2.C
!BP_OUT14: IC20.19 (!OUT14), Q26.1 (G), R139.1
!BP_OUT15: IC20.20 (!OUT15), LED_PWR.C
+3V3: C107.1, IC20.24 (VDD); also elsewhere on the board
+5V: LED_CC1.A, LED_CC2.A, LED_CV1.A, LED_CV2.A, LED_O1.A, LED_O2.A, LED_PROG1.A, LED_PROG2.A, LED_PWR.A, LED_S1.A, LED_S2.A, LED_SP.A, Q23.2 (S), Q24.2 (S), Q25.2 (S), Q26.2 (S), R134.2, R135.2, R137.2, R139.2; also elsewhere on the board
BP_SELECT: IC20.4 (LE); also elsewhere on the board
CH2_GND: X14.5, X14.5.1; also elsewhere on the board
EARTH: C105.2, C108.1, C110.2, C112.1, J2.P$1, X12.3, X12.3.1, X14.1, X14.1.1; also elsewhere on the board
GND: C107.2, D22.A, D23.A, D24.A, D25.A, IC20.1 (GND), K_PAR.A1 (C2), K_S1.8 (-), K_S2.8 (-), K_SER.A1 (C2), R138.1; also elsewhere on the board
MOSI: IC20.2 (SDI); also elsewhere on the board
unnamed: D22.C, K_S1.1 (+), Q23.3 (D)
unnamed: D25.C, K_S2.1 (+), Q26.3 (D)
unnamed: C104.2, R136.2
unnamed: C109.2, R140.2
unnamed: IC20.16 (!OUT11), LED_PROG2.C
unnamed: K_SER.14A (O), K_SER.14B (O)
unnamed: K_PAR.12A (S), K_SER.11B
unnamed: K_PAR.12B (S), K_SER.11A
unnamed: D23.C, K_SER.A2 (C1), Q25.3 (D)
unnamed: D24.C, K_PAR.A2 (C1), Q24.3 (D)
unnamed: IC20.23 (R-EXT), R138.2
OUT1+: C105.1, J1.P$1, K_SER.12B (S), TP2.TIP
OUT1-: C106.2 (-), C106.2.1 (-), C108.2, J3.P$1, K_PAR.14B (O), K_S1.7 (O), R136.1, TP2.GND, X13.17, X13.18, X13.19, X13.20, ZD8.A
OUT2+: C109.1, C110.1, C111.1 (+), C111.1.1 (+), J4.P$1, K_PAR.14A (O), K_S2.7 (O), TP3.TIP, X15.23, X15.24, X15.25, X15.26, ZD9.C
OUT2-: C112.2, J5.P$1, K_SER.12A (S), TP3.GND
PWR_IN1+: C104.1, C106.1 (+), C106.1.1 (+), K_PAR.11A, K_S1.2 (O), X13.23, X13.24, X13.25, X13.26, ZD8.C
PWR_IN2-: C111.2 (-), C111.2.1 (-), K_PAR.11B, K_S2.2 (O), R140.1, X15.17, X15.18, X15.19, X15.20, ZD9.A
SCLK: IC20.3 (CLK); also elsewhere on the board
SENSE1+: K_S1.4 (S), X12.5, X12.5.1
SENSE1-: K_S1.5 (S), X12.4, X12.4.1
SENSE1_IN+: K_S1.3, X13.22
SENSE1_IN-: K_S1.6, X13.21
SENSE2+: K_S2.5 (S), X14.3, X14.3.1
SENSE2-: K_S2.4 (S), X14.2, X14.2.1
SENSE2_IN+: K_S2.6, X15.22
SENSE2_IN-: K_S2.3, X15.21

Notes on the sheet:
Remote sensing and outputs interconnector
Output terminal protection
Licensed under the TAPR Open Hardware License (www.tapr.org/OHL)
