bogdan-tirzioru/Powersupply/reaserch/psu-hw-master/Consolidated/Eagle files/EEZ PSU consolidated r5B9.brd

## EAGLE design reaserch/psu-hw-master/Consolidated/Eagle files/EEZ PSU consolidated r5B9.brd (continued)

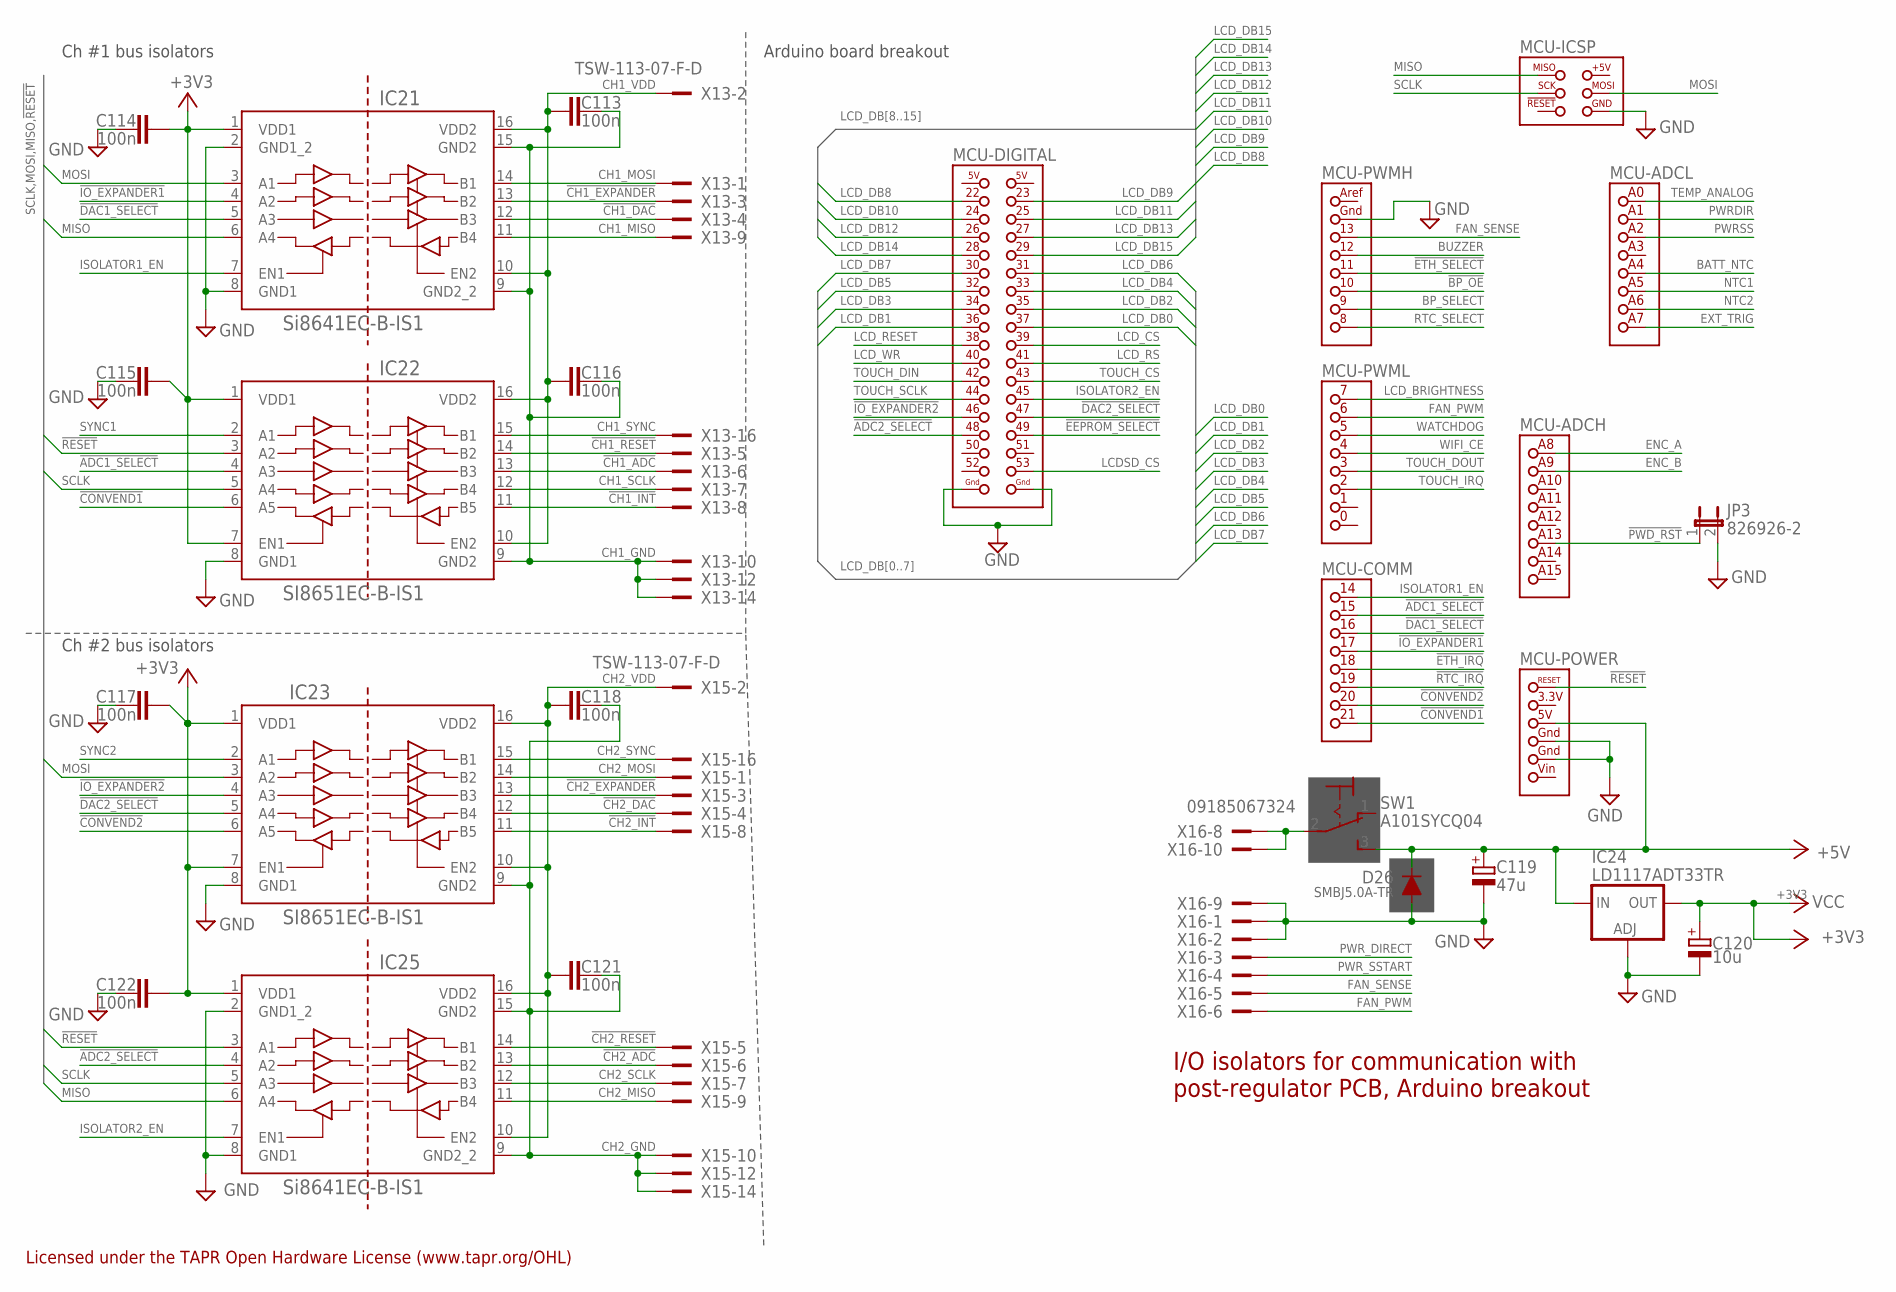
[picture p95: schematic EEZ PSU consolidated r5B9.sch, sheet 9, Isolators, Arduino]

Parts:
C113, C114, C115, C116, C117, C118, C121, C122: 100n; C0603
C119: 47u; CAPAE660X610N
C120: 10u; PANASONIC_C
D26: SMBJ5.0A-TR; DO214AA
IC21, IC25: Si8641EC-B-IS1; SOIC-16
IC22, IC23: SI8651EC-B-IS1; SOIC-16
IC24: LD1117ADT33TR; DPACK
JP3: 826926-2; JP1
MCU: Arduino Due; ARDUINO+ICSP_MIRROR
SW1: A101SYCQ04; M9040P
X13, X15: TSW-113-07-F-D; FARNELL 2025182
X16: 09185067324; IDC-10PIN

Connections:
!ADC1_SELECT: IC22.4 (A3), MCU.15
!ADC2_SELECT: IC25.4 (A2), MCU.48 (48(PL3))
!BP_OE: MCU.10; also elsewhere on the board
!CH1_ADC: IC22.13 (B3), X13.6
!CH1_DAC: IC21.12 (B3), X13.4
!CH1_EXPANDER: IC21.13 (B2), X13.3
!CH1_INT: IC22.11 (B5), X13.8
!CH1_RESET: IC22.14 (B2), X13.5
!CH2_ADC: IC25.13 (B2), X15.6
!CH2_DAC: IC23.12 (B4), X15.4
!CH2_EXPANDER: IC23.13 (B3), X15.3
!CH2_INT: IC23.11 (B5), X15.8
!CH2_RESET: IC25.14 (B1), X15.5
!CONVEND1: IC22.6 (A5), MCU.21
!CONVEND2: IC23.6 (A5), MCU.20
!DAC1_SELECT: IC21.5 (A3), MCU.16
!DAC2_SELECT: IC23.5 (A4), MCU.47 (47(PL4))
!EEPROM_SELECT: MCU.49 (49(PL2)); also elsewhere on the board
!ETH_IRQ: MCU.18; also elsewhere on the board
!ETH_SELECT: MCU.11; also elsewhere on the board
!IO_EXPANDER1: IC21.4 (A2), MCU.17
!IO_EXPANDER2: IC23.4 (A3), MCU.46 (46(PL5))
!PWD_RST: JP3.1, MCU.A13 (ADC13)
!RESET: IC22.3 (A2), IC25.3 (A1), MCU.RESET (!RESET); also elsewhere on the board
!RTC_IRQ: MCU.19; also elsewhere on the board
+3V3: C114.1, C115.1, C117.1, C120.1 (+), C122.1, IC21.1 (VDD1), IC22.1 (VDD1), IC22.7 (EN1), IC23.1 (VDD1), IC23.7 (EN1), IC24.4 (OUT), IC25.1 (VDD1); also elsewhere on the board
+5V: C119.1 (+), D26.C, IC24.3 (IN), MCU.5V, SW1.3 (S); also elsewhere on the board
BATT_NTC: MCU.A4 (ADC4); also elsewhere on the board
BP_SELECT: MCU.9 (9(PH6)); also elsewhere on the board
BUZZER: MCU.12; also elsewhere on the board
CH1_GND: C113.2, C116.2, IC21.9 (GND2_2), IC21.15 (GND2), IC22.9 (GND2), X13.10, X13.12, X13.14; also elsewhere on the board
CH1_MISO: IC21.11 (B4), X13.9
CH1_MOSI: IC21.14 (B1), X13.1
CH1_SCLK: IC22.12 (B4), X13.7
CH1_SYNC: IC22.15 (B1), X13.16
CH1_VDD: C113.1, C116.1, IC21.10 (EN2), IC21.16 (VDD2), IC22.10 (EN2), IC22.16 (VDD2), X13.2; also elsewhere on the board
CH2_GND: C118.2, C121.2, IC23.9 (GND2), IC25.9 (GND2_2), IC25.15 (GND2), X15.10, X15.12, X15.14; also elsewhere on the board
CH2_MISO: IC25.11 (B4), X15.9
CH2_MOSI: IC23.14 (B2), X15.1
CH2_SCLK: IC25.12 (B3), X15.7
CH2_SYNC: IC23.15 (B1), X15.16
CH2_VDD: C118.1, C121.1, IC23.10 (EN2), IC23.16 (VDD2), IC25.10 (EN2), IC25.16 (VDD2), X15.2
ENC_A: MCU.A8 (ADC8); also elsewhere on the board
ENC_B: MCU.A9 (ADC9); also elsewhere on the board
EXT_TRIG: MCU.A7 (ADC7); also elsewhere on the board
FAN_PWM: MCU.6 (6(PH3)), X16.6
FAN_SENSE: MCU.13, X16.5
GND: C114.2, C115.2, C117.2, C119.2 (-), C120.2 (-), C122.2, D26.A, IC21.2 (GND1_2), IC21.8 (GND1), IC22.8 (GND1), IC23.8 (GND1), IC24.1 (ADJ), IC25.2 (GND1_2), IC25.8 (GND1), JP3.2, MCU.GND, MCU.GND1, MCU.GND2, MCU.GND3, MCU.GND4, MCU.ICSP_GND (GND), X16.1, X16.2, X16.9; also elsewhere on the board
ISOLATOR1_EN: IC21.7 (EN1), MCU.14
ISOLATOR2_EN: IC25.7 (EN1), MCU.45 (45(PL6))
LCDSD_CS: MCU.53 (53(PB2/MOSI)); also elsewhere on the board
LCD_BRIGHTNESS: MCU.7 (7(PH4)); also elsewhere on the board
LCD_CS: MCU.39 (39(PC0)); also elsewhere on the board
LCD_DB0: MCU.37 (37(PC2)); also elsewhere on the board
LCD_DB1: MCU.36 (36(PC3)); also elsewhere on the board
LCD_DB2: MCU.35 (35(PC4)); also elsewhere on the board
LCD_DB3: MCU.34 (34(PC5)); also elsewhere on the board
LCD_DB4: MCU.33 (33(PC6)); also elsewhere on the board
LCD_DB5: MCU.32 (32(PC7)); also elsewhere on the board
LCD_DB6: MCU.31 (31(PA7)); also elsewhere on the board
LCD_DB7: MCU.30 (30(PA6)); also elsewhere on the board
LCD_DB8: MCU.22; also elsewhere on the board
LCD_DB9: MCU.23; also elsewhere on the board
LCD_DB10: MCU.24 (24(PA0)); also elsewhere on the board
LCD_DB11: MCU.25 (25(PA1)); also elsewhere on the board
LCD_DB12: MCU.26 (26(PA2)); also elsewhere on the board
LCD_DB13: MCU.27 (27(PA3)); also elsewhere on the board
LCD_DB14: MCU.28 (28(PA4)); also elsewhere on the board
LCD_DB15: MCU.29 (29(PA5)); also elsewhere on the board
LCD_RESET: MCU.38 (38(PC1)); also elsewhere on the board
LCD_RS: MCU.41 (41(PG2)); also elsewhere on the board
LCD_WR: MCU.40 (40(PD7)); also elsewhere on the board
MISO: IC21.6 (A4), IC25.6 (A4), MCU.ICSP_MISO (MISO); also elsewhere on the board
MOSI: IC21.3 (A1), IC23.3 (A2), MCU.ICSP_MOSI (MOSI); also elsewhere on the board
unnamed: SW1.2, X16.8, X16.10
NTC1: MCU.A5 (ADC5); also elsewhere on the board
NTC2: MCU.A6 (ADC6); also elsewhere on the board
PWRDIR: MCU.A1 (ADC1); also elsewhere on the board
PWRSS: MCU.A2 (ADC2); also elsewhere on the board
PWR_DIRECT: X16.3; also elsewhere on the board
PWR_SSTART: X16.4; also elsewhere on the board
RTC_SELECT: MCU.8 (8(PH5)); also elsewhere on the board
SCLK: IC22.5 (A4), IC25.5 (A3), MCU.ICSP_SCK (SCK); also elsewhere on the board
SYNC1: IC22.2 (A1); also elsewhere on the board
SYNC2: IC23.2 (A1); also elsewhere on the board
TEMP_ANALOG: MCU.A0 (ADC0); also elsewhere on the board
TOUCH_CS: MCU.43 (43(PG0)); also elsewhere on the board
TOUCH_DIN: MCU.42 (42(PG1)); also elsewhere on the board
TOUCH_DOUT: MCU.3 (3(PE5)); also elsewhere on the board
TOUCH_IRQ: MCU.2 (2(PE4)); also elsewhere on the board
TOUCH_SCLK: MCU.44 (44(PL7)); also elsewhere on the board
WATCHDOG: MCU.5 (5(PE3)); also elsewhere on the board
WIFI_CE: MCU.4 (4(PG5)); also elsewhere on the board

Notes on the sheet:
I/O isolators for communication with
post-regulator PCB, Arduino breakout
Ch #1 bus isolators
Ch #2 bus isolators
Arduino board breakout
Licensed under the TAPR Open Hardware License (www.tapr.org/OHL)

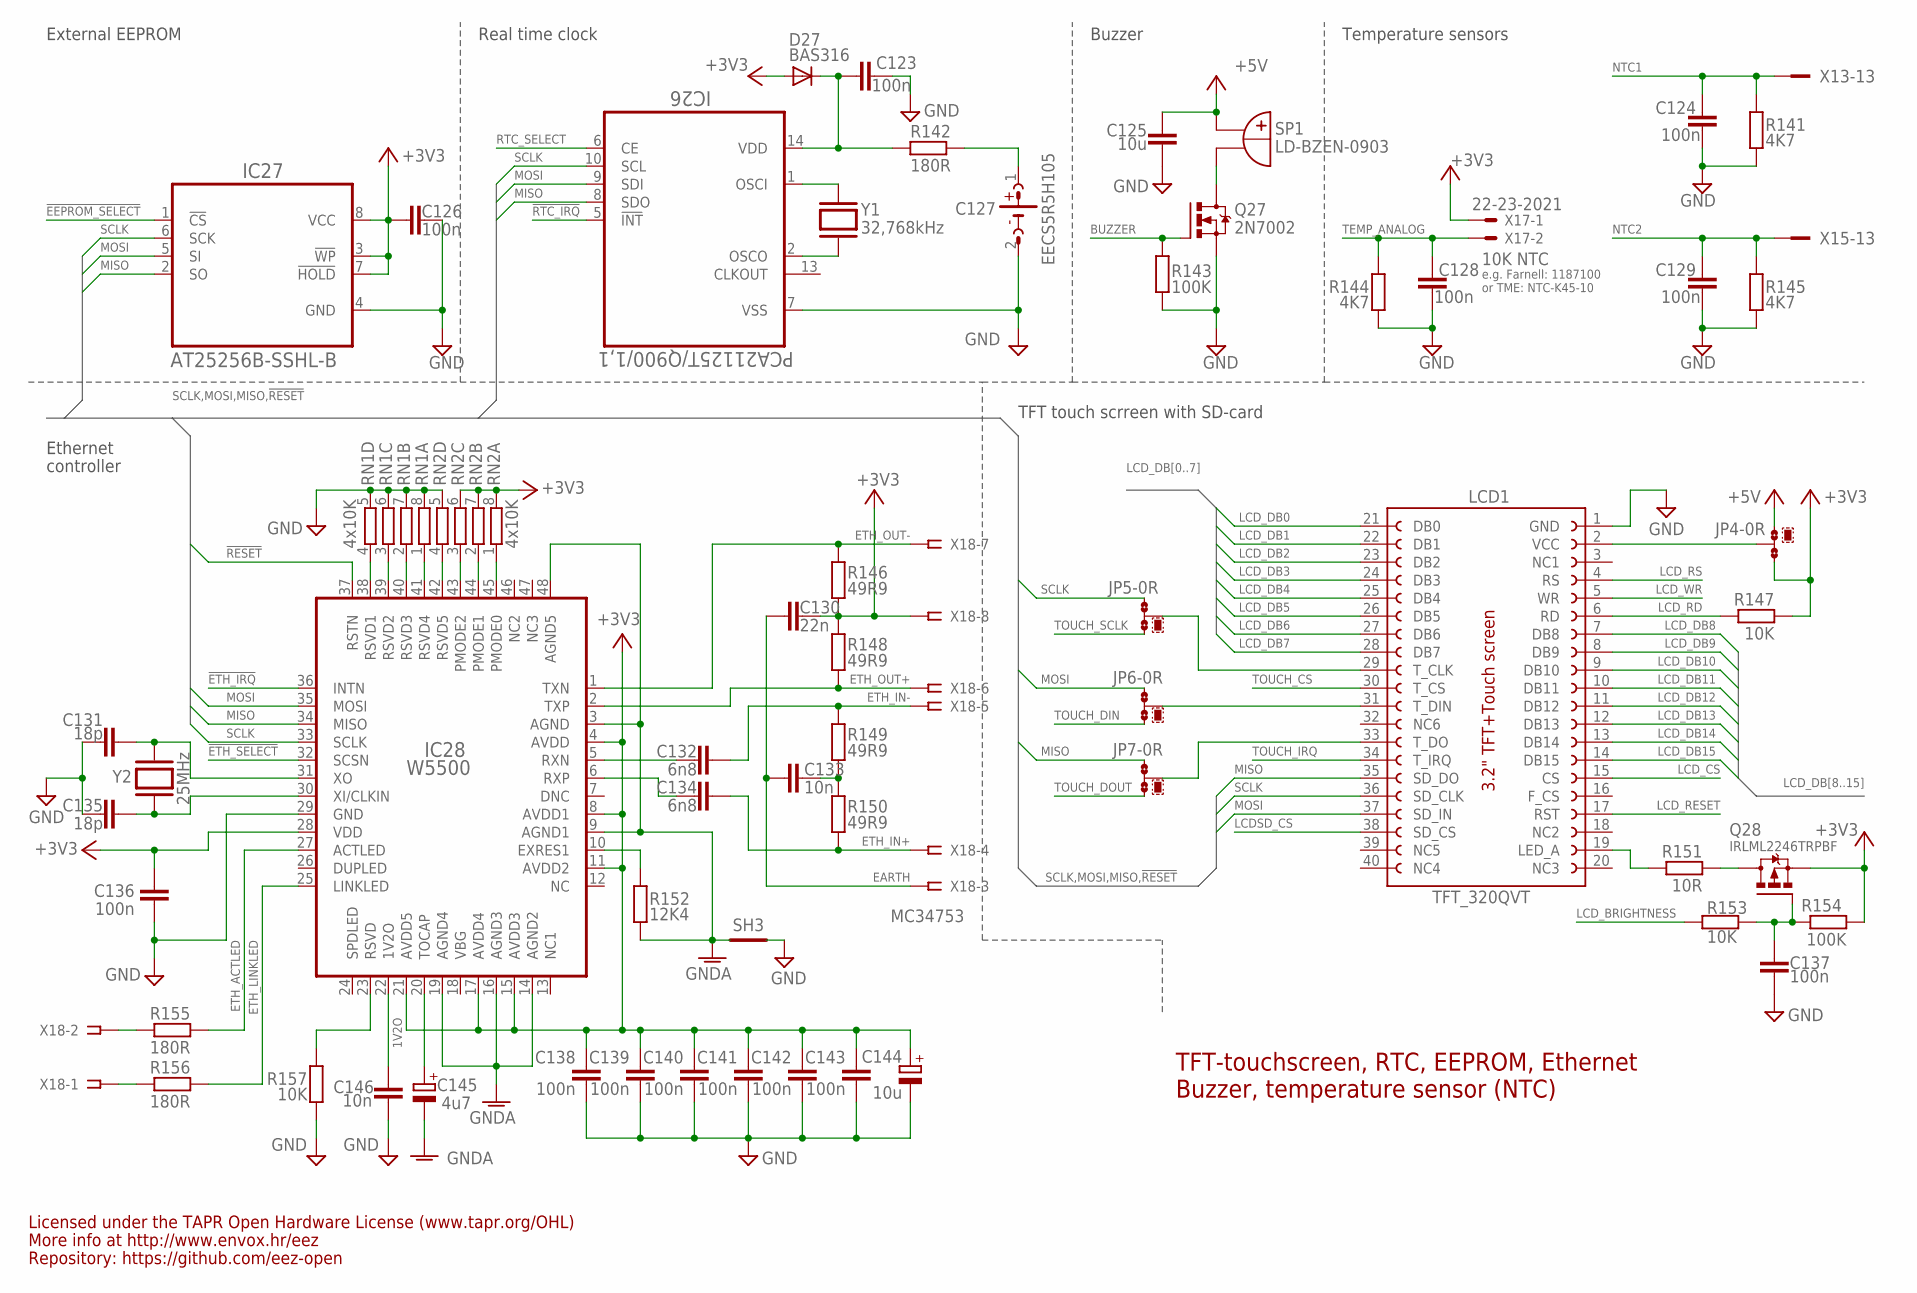
[picture p96: schematic EEZ PSU consolidated r5B9.sch, sheet 10, SPI peripherals, TFT display]

Parts:
C123, C124, C126, C128, C129, C136, C137, C138, C139, C140, C141, C142, C143: 100n; C0603
C125: 10u; C1210
C127: EECS5R5H105; SG-R20MM
C130: 22n; C0805
C131, C135: 18p; C0805
C132, C134: 6n8; C0603
C133, C146: 10n; C0805
C144: 10u; EC1206
C145: 4u7; EC1206
D27: BAS316; SOD323-W
IC26: PCA21125T/Q900/1,1; SOP65P640X120-14N
IC27: AT25256B-SSHL-B; SOIC127P600X175-8N
IC28: W5500; TQFP48-7X7
JP4, JP5, JP6, JP7: 0R-JUMPA; A0R-JMP
LCD1: TFT_320QVT; LCD_TFT_320QVT_MIRROR
Q27: 2N7002; SOT103P240X110-3N
Q28: IRLML2246TRPBF; SOT95P237X112-3N
R141, R144, R145: 4K7; R0805
R142, R155, R156: 180R; R0805
R143, R154: 100K; R0805
R146, R148, R149, R150: 49R9; R0805
R147, R153, R157: 10K; R0805
R151: 10R; R1206
R152: 12K4; R0805
RN1, RN2: 4x10K; CAY16
SH3: SHORTNOHOLE; SHORT_NOHOLE
SP1: LD-BZEN-0903
X13, X15: TSW-113-07-F-D; FARNELL 2025182
X17: 22-23-2021; MPN 22-23-2021
X18: MC34753; SSW-108-02-S-S; MPN SSW-108-02-S-S
Y1: 32,768kHz; R26_XTAL
Y2: 25MHz; HC-49/4H

Connections:
1V2O: C146.2, IC28.22 (1V2O)
!EEPROM_SELECT: IC27.1 (!CS); also elsewhere on the board
!ETH_IRQ: IC28.36 (INTN); also elsewhere on the board
!ETH_SELECT: IC28.32 (SCSN); also elsewhere on the board
!RESET: IC28.37 (RSTN); also elsewhere on the board
!RTC_IRQ: IC26.5 (!INT); also elsewhere on the board
+3V3: C126.1, C130.1, C136.2, C138.1, C139.1, C140.1, C141.1, C142.1, C143.1, C144.+, D27.A, IC27.3 (!WP), IC27.7 (!HOLD), IC27.8 (VCC), IC28.4 (AVDD), IC28.8 (AVDD1), IC28.11 (AVDD2), IC28.15 (AVDD3), IC28.17 (AVDD4), IC28.21 (AVDD5), IC28.28 (VDD), JP4.3, Q28.2 (S), R146.1, R147.2, R148.2, R154.2, RN2.6 (2), RN2.7 (2), RN2.8 (2), X17.1, X18.8; also elsewhere on the board
+5V: C125.2, JP4.1, SP1.+B (+); also elsewhere on the board
BUZZER: Q27.1 (G), R143.2; also elsewhere on the board
EARTH: C130.2, C133.2, X18.3; also elsewhere on the board
ETH_ACTLED: IC28.27 (ACTLED), R155.1
ETH_IN+: C134.1, R150.1, X18.4
ETH_IN-: C132.1, R149.2, X18.5
ETH_LINKLED: IC28.25 (LINKLED), R156.1
ETH_OUT+: IC28.2 (TXP), R148.1, X18.6
ETH_OUT-: IC28.1 (TXN), R146.2, X18.7
GND: C123.1, C124.1, C125.1, C126.2, C127.2 (-), C128.1, C129.1, C131.2, C135.2, C136.1, C137.1, C138.2, C139.2, C140.2, C141.2, C142.2, C143.2, C144.-, C146.1, IC26.7 (VSS), IC27.4 (GND), IC28.29 (GND), LCD1.1 (GND), Q27.2 (S), R141.2, R143.1, R144.2, R145.2, R157.1, RN1.5 (2), RN1.6 (2), RN1.7 (2), RN1.8 (2), RN2.5 (2), SH3.P$1 (GND_A); also elsewhere on the board
GNDA: C145.-, IC28.3 (AGND), IC28.9 (AGND1), IC28.14 (AGND2), IC28.16 (AGND3), IC28.19 (AGND4), IC28.48 (AGND5), R152.1, SH3.P$2 (GND_B)
LCDSD_CS: LCD1.38 (SD_CS); also elsewhere on the board
LCD_BRIGHTNESS: R153.1; also elsewhere on the board
LCD_CS: LCD1.15 (CS); also elsewhere on the board
LCD_DB0: LCD1.21 (DB0); also elsewhere on the board
LCD_DB1: LCD1.22 (DB1); also elsewhere on the board
LCD_DB2: LCD1.23 (DB2); also elsewhere on the board
LCD_DB3: LCD1.24 (DB3); also elsewhere on the board
LCD_DB4: LCD1.25 (DB4); also elsewhere on the board
LCD_DB5: LCD1.26 (DB5); also elsewhere on the board
LCD_DB6: LCD1.27 (DB6); also elsewhere on the board
LCD_DB7: LCD1.28 (DB7); also elsewhere on the board
LCD_DB8: LCD1.7 (DB8); also elsewhere on the board
LCD_DB9: LCD1.8 (DB9); also elsewhere on the board
LCD_DB10: LCD1.9 (DB10); also elsewhere on the board
LCD_DB11: LCD1.10 (DB11); also elsewhere on the board
LCD_DB12: LCD1.11 (DB12); also elsewhere on the board
LCD_DB13: LCD1.12 (DB13); also elsewhere on the board
LCD_DB14: LCD1.13 (DB14); also elsewhere on the board
LCD_DB15: LCD1.14 (DB15); also elsewhere on the board
LCD_RD: LCD1.6 (RD), R147.1
LCD_RESET: LCD1.17 (RST); also elsewhere on the board
LCD_RS: LCD1.4 (RS); also elsewhere on the board
LCD_WR: LCD1.5 (WR); also elsewhere on the board
LED_A: LCD1.19 (LED_A), R151.2
MISO: IC26.8 (SDO), IC27.2 (SO), IC28.34 (MISO), JP7.1, LCD1.35 (SD_DO); also elsewhere on the board
MOSI: IC26.9 (SDI), IC27.5 (SI), IC28.35 (MOSI), JP6.1, LCD1.37 (SD_IN); also elsewhere on the board
unnamed: Q27.3 (D), SP1.-B (-)
unnamed: JP4.2, LCD1.2 (VCC)
unnamed: Q28.3 (D), R151.1
unnamed: JP7.2, LCD1.33 (T_DO)
unnamed: JP5.2, LCD1.29 (T_CLK)
unnamed: JP6.2, LCD1.31 (T_DIN)
unnamed: C127.1 (+), R142.1
unnamed: IC28.23 (RSVD), R157.2
unnamed: C123.2, D27.C, IC26.14 (VDD), R142.2
unnamed: IC28.10 (EXRES1), R152.2
unnamed: C131.1, IC28.31 (XO), Y2.1
unnamed: C135.1, IC28.30 (XI/CLKIN), Y2.2
unnamed: C132.2, IC28.5 (RXN)
unnamed: C134.2, IC28.6 (RXP)
unnamed: R156.2, X18.1
unnamed: R155.2, X18.2
unnamed: IC28.43 (PMODE2), RN2.3 (1)
unnamed: IC28.44 (PMODE1), RN2.2 (1)
unnamed: IC28.45 (PMODE0), RN2.1
unnamed: IC28.42 (RSVD5), RN2.4 (1)
unnamed: IC28.38 (RSVD1), RN1.4 (1)
unnamed: C133.1, R149.1, R150.2
unnamed: IC28.39 (RSVD2), RN1.3 (1)
unnamed: IC28.41 (RSVD4), RN1.1
unnamed: IC28.40 (RSVD3), RN1.2 (1)
unnamed: C137.2, Q28.1 (G), R153.2, R154.1
unnamed: IC26.1 (OSCI), Y1.2
unnamed: IC26.2 (OSCO), Y1.1
NTC1: C124.2, R141.1, X13.13; also elsewhere on the board
NTC2: C129.2, R145.1, X15.13; also elsewhere on the board
RTC_SELECT: IC26.6 (CE); also elsewhere on the board
SCLK: IC26.10 (SCL), IC27.6 (SCK), IC28.33 (SCLK), JP5.1, LCD1.36 (SD_CLK); also elsewhere on the board
TEMP_ANALOG: C128.2, R144.1, X17.2; also elsewhere on the board
TOCAP: C145.+, IC28.20 (TOCAP)
TOUCH_CS: LCD1.30 (T_CS); also elsewhere on the board
TOUCH_DIN: JP6.3; also elsewhere on the board
TOUCH_DOUT: JP7.3; also elsewhere on the board
TOUCH_IRQ: LCD1.34 (T_IRQ); also elsewhere on the board
TOUCH_SCLK: JP5.3; also elsewhere on the board

Notes on the sheet:
TFT-touchscreen, RTC, EEPROM, Ethernet
e.g. Farnell: 1187100
10K NTC
or TME: NTC-K45-10
Buzzer, temperature sensor (NTC)
External EEPROM
Real time clock
Buzzer
Temperature sensors
TFT touch scrreen with SD-card
Ethernet
controller
Licensed under the TAPR Open Hardware License (www.tapr.org/OHL)
Repository: https://github.com/eez-open
More info at http://www.envox.hr/eez

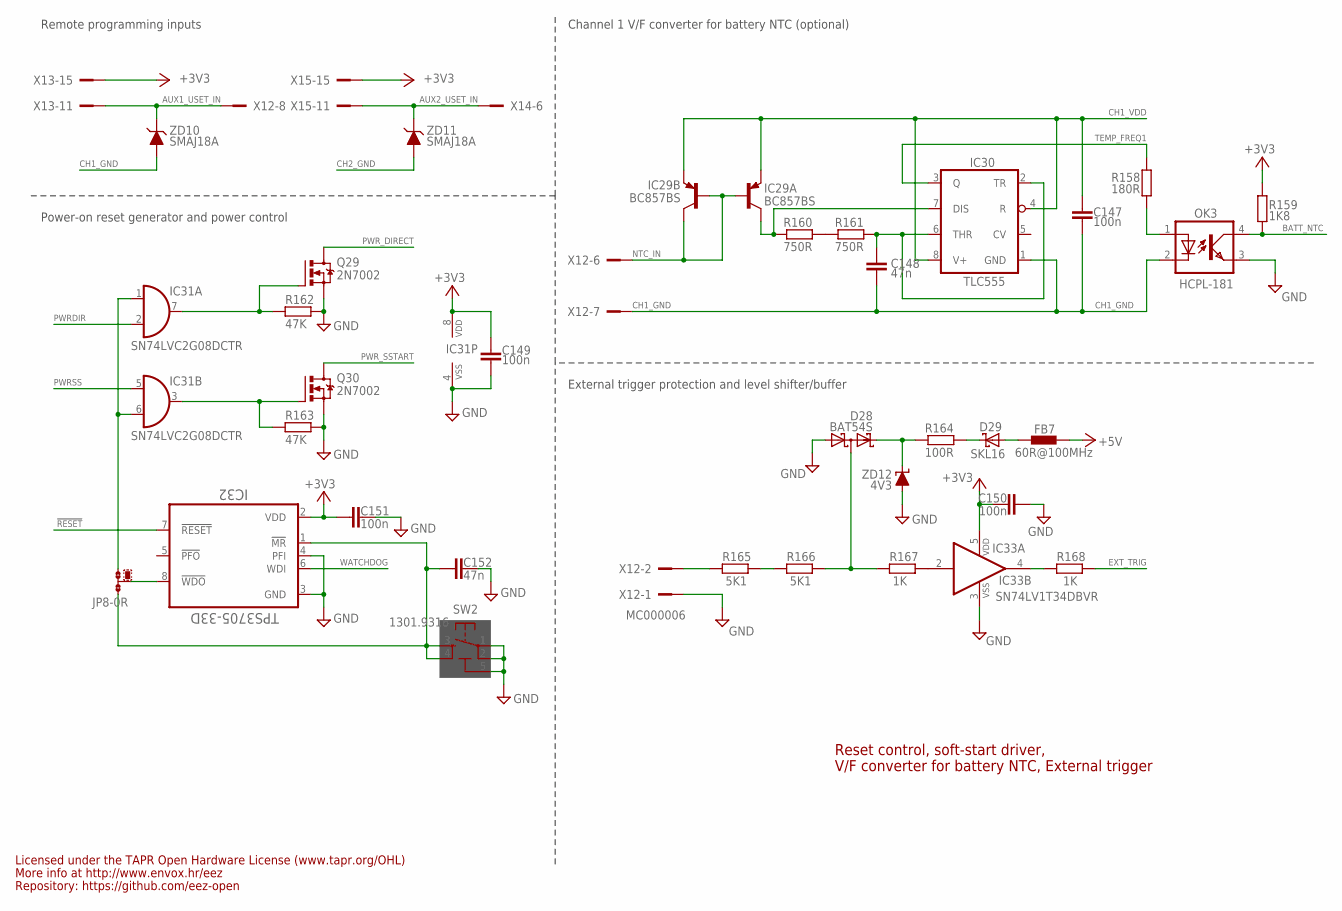
[picture p97: schematic EEZ PSU consolidated r5B9.sch, sheet 11, Reset, load temp, digital input]

Parts:
C147, C149, C150, C151: 100n; C0603
C148, C152: 47n; C0805
D28: BAT54S; SOT23
D29: SKL16; SOD123
FB7: 60R@100MHz; BEAD0603
IC29: BC857BS; SOT65P210X110-6N
IC30: TLC555; SOIC127P600X175-8N
IC31: SN74LVC2G08DCTR; SOP65P400X130-8N
IC32: TPS3705-33D; SOIC127P600X175-8N
IC33: SN74LV1T34DBVR; SOT95P280X145-5N
JP8: 0R-JUMPA; A0R-JMP
OK3: HCPL-181
Q29, Q30: 2N7002; SOT103P240X110-3N
R158: 180R; R0805
R159: 1K8; R0805
R160, R161: 750R; R0805
R162, R163: 47K; R0805
R164: 100R; R0805
R165, R166: 5K1; R0805
R167, R168: 1K; R0805
SW2: 1301.9316; TACTM-6XN
X12: MC000006; MC000006_MIRROR; FARNELL 2007972
X13, X15: TSW-113-07-F-D; FARNELL 2025182
X14: MC000005; MC000005_MIRROR
ZD10, ZD11: SMAJ18A; DO214AC
ZD12: 4V3; MINIMELF

Connections:
!MR: C152.2, IC32.1 (!MR), JP8.1, SW2.3, SW2.4
!RESET: IC32.7 (!RESET); also elsewhere on the board
!RESET1: IC31.1 (I0), IC31.6 (I1), JP8.3
+3V3: C149.2, C150.1, C151.2, IC31.8 (VDD), IC32.2 (VDD), IC33.5 (VDD), R159.1, X13.15, X15.15; also elsewhere on the board
+5V: FB7.P$1 (1); also elsewhere on the board
AUX1_USET_IN: X12.8, X12.8.1, X13.11, ZD10.C
AUX2_USET_IN: X14.6, X14.6.1, X15.11, ZD11.C
BATT_NTC: OK3.4 (COL), R159.2; also elsewhere on the board
CH1_GND: C147.2, C148.1, IC30.1 (GND), OK3.2 (C), X12.7, X12.7.1, ZD10.A; also elsewhere on the board
CH1_VDD: C147.1, IC29.1 (E), IC29.4 (E), IC30.4 (R), IC30.8 (V+); also elsewhere on the board
CH2_GND: ZD11.A; also elsewhere on the board
EXT_TRIG: R168.1; also elsewhere on the board
GND: C149.1, C150.2, C151.1, C152.1, D28.1 (A1), IC31.4 (VSS), IC32.3 (GND), IC32.4 (PFI), IC33.3 (VSS), OK3.3 (EMIT), Q29.2 (S), Q30.2 (S), R162.2, R163.2, SW2.1, SW2.2, SW2.5 (5-GND), X12.1, X12.1.1, ZD12.A; also elsewhere on the board
unnamed: IC31.7 (O), Q29.1 (G), R162.1
unnamed: C148.2, IC30.2 (TR), IC30.6 (THR), R161.2
unnamed: IC29.6 (C), IC30.7 (DIS), R160.1
unnamed: OK3.1 (A), R158.2
unnamed: D28.3 (C1A2), R166.1, R167.2
unnamed: IC33.2 (I), R167.1
unnamed: IC33.4 (O), R168.2
unnamed: R165.2, X12.2, X12.2.1
unnamed: D28.2 (C2), R164.1, ZD12.C
unnamed: D29.C, R164.2
unnamed: D29.A, FB7.P$2 (2)
unnamed: IC32.8 (!WDO), JP8.2
unnamed: IC31.3 (O), Q30.1 (G), R163.1
unnamed: R165.1, R166.2
unnamed: R160.2, R161.1
NTC_IN: IC29.2 (B), IC29.3 (C), IC29.5 (B), X12.6, X12.6.1
PWRDIR: IC31.2 (I1); also elsewhere on the board
PWRSS: IC31.5 (I0); also elsewhere on the board
PWR_DIRECT: Q29.3 (D); also elsewhere on the board
PWR_SSTART: Q30.3 (D); also elsewhere on the board
TEMP_FREQ1: IC30.3 (Q), R158.1
WATCHDOG: IC32.6 (WDI); also elsewhere on the board

Notes on the sheet:
Channel 1 V/F converter for battery NTC (optional)
External trigger protection and level shifter/buffer
Remote programming inputs
Licensed under the TAPR Open Hardware License (www.tapr.org/OHL)
Repository: https://github.com/eez-open
More info at http://www.envox.hr/eez
Power-on reset generator and power control
Reset control, soft-start driver,
V/F converter for battery NTC, External trigger

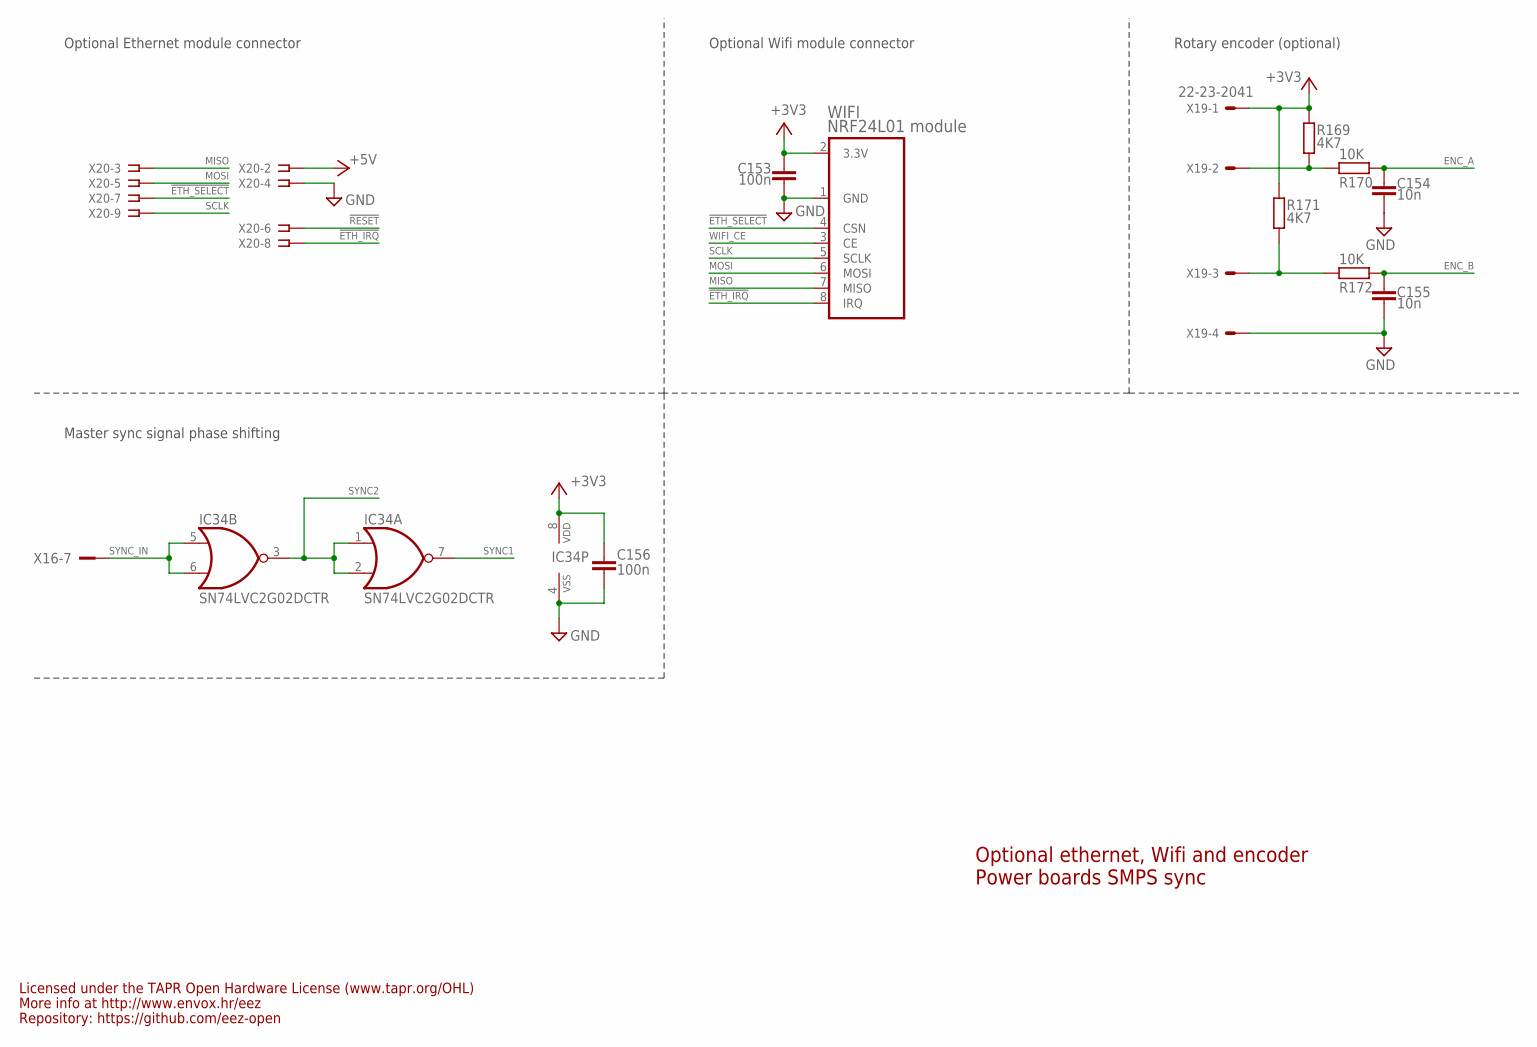
[picture p98: schematic EEZ PSU consolidated r5B9.sch, sheet 12, Optional conn., Master sync]

Parts:
C153, C156: 100n; C0603
C154, C155: 10n; C0805
IC34: SN74LVC2G02DCTR; SOP65P400X130-8N
R169, R171: 4K7; R0805
R170, R172: 10K; R0805
WIFI: NRF24L01 module; MOD-NRF24L01_MIRROR
X16: 09185067324; IDC-10PIN
X19: 22-23-2041
X20: SSW-105-02-S-D

Connections:
!ETH_IRQ: WIFI.8 (IRQ), X20.8; also elsewhere on the board
!ETH_SELECT: WIFI.4 (CSN), X20.7; also elsewhere on the board
!RESET: X20.6; also elsewhere on the board
+3V3: C153.1, C156.1, IC34.8 (VDD), R169.1, R171.1, WIFI.2 (3.3V), X19.1; also elsewhere on the board
+5V: X20.2; also elsewhere on the board
ENC_A: C154.2, R170.1; also elsewhere on the board
ENC_B: C155.1, R172.1; also elsewhere on the board
GND: C153.2, C154.1, C155.2, C156.2, IC34.4 (VSS), WIFI.1 (GND), X19.4, X20.4; also elsewhere on the board
MISO: WIFI.7 (MISO), X20.3; also elsewhere on the board
MOSI: WIFI.6 (MOSI), X20.5; also elsewhere on the board
unnamed: R169.2, R170.2, X19.2
unnamed: R171.2, R172.2, X19.3
SCLK: WIFI.5 (SCLK), X20.9; also elsewhere on the board
SYNC1: IC34.7 (O); also elsewhere on the board
SYNC2: IC34.1 (I0), IC34.2 (I1), IC34.3 (O); also elsewhere on the board
SYNC_IN: IC34.5 (I0), IC34.6 (I1), X16.7
WIFI_CE: WIFI.3 (CE); also elsewhere on the board

Notes on the sheet:
Optional Ethernet module connector
Optional Wifi module connector
Rotary encoder (optional)
Master sync signal phase shifting
Optional ethernet, Wifi and encoder
Power boards SMPS sync
Licensed under the TAPR Open Hardware License (www.tapr.org/OHL)
Repository: https://github.com/eez-open
More info at http://www.envox.hr/eez

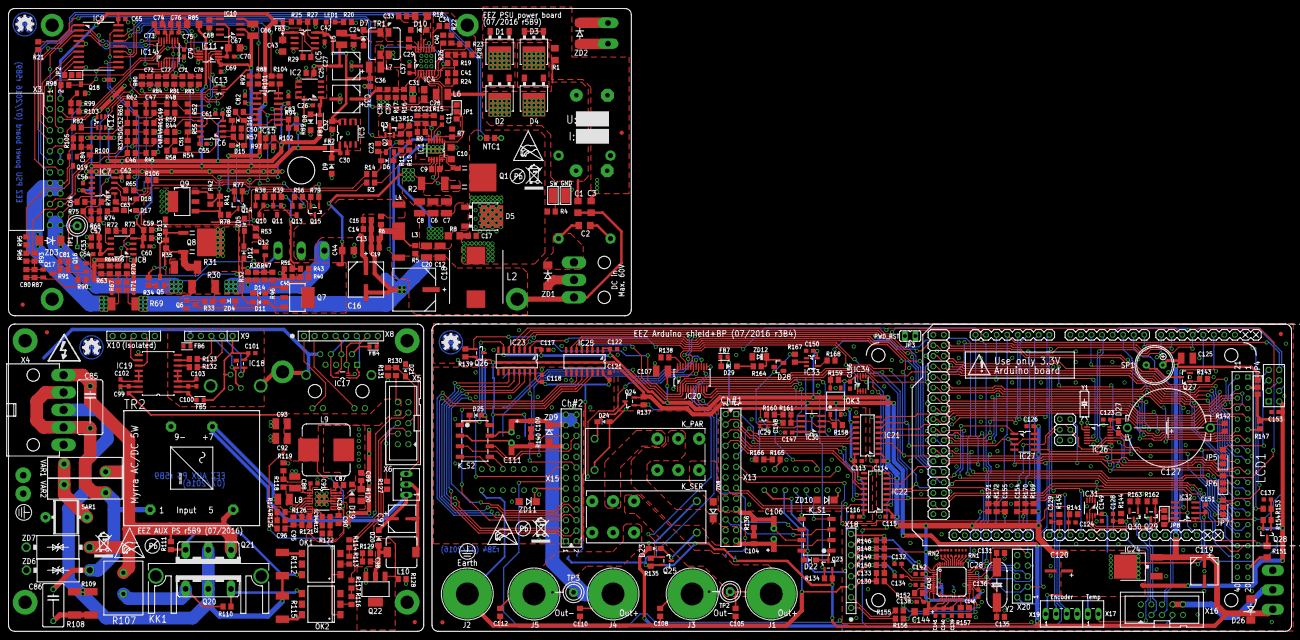
[picture p99: board EEZ PSU consolidated r5B9.brd from above]

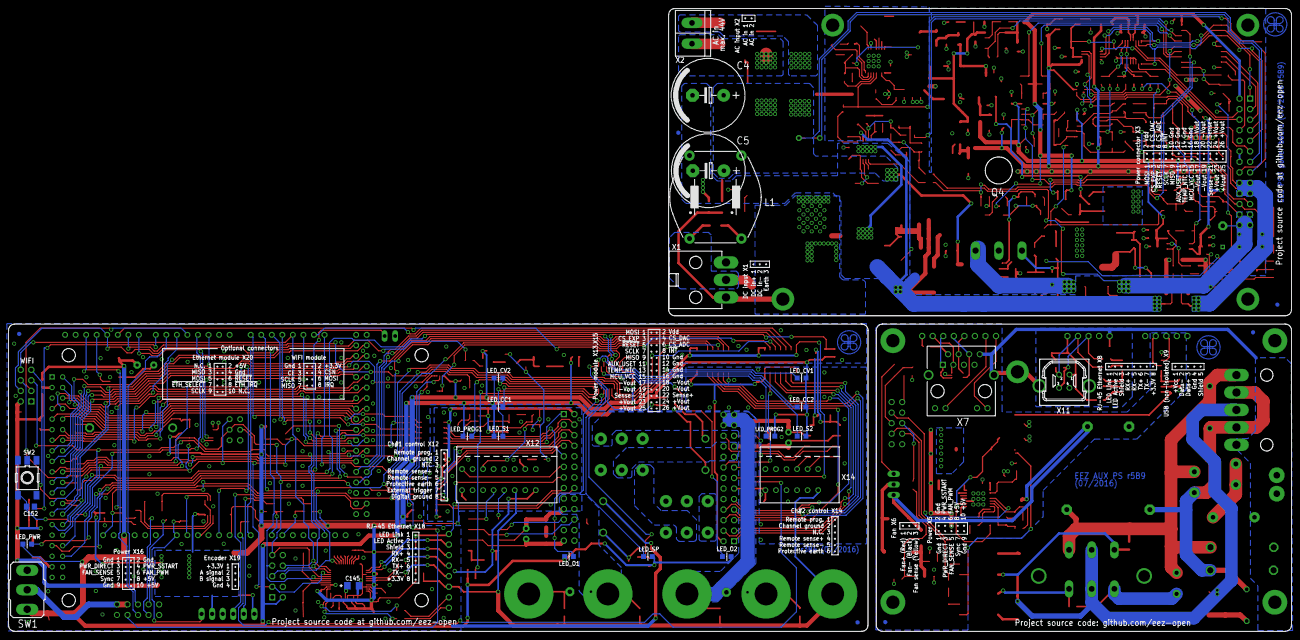
[picture p100: board EEZ PSU consolidated r5B9.brd from below]

Board: 3 copper layers, 309.0 x 150.0 mm, 546 parts (23 on the bottom side), 413 nets.

Other parts of the board:
EEZ_SIGNATURE, EEZ_SIGNATURE1, EEZ_SIGNATURE2: SIGNATURESMALL; SIGNATURE_5MM
U$1, U$2, U$8: RECYCLE_BIN1/8
U$3, U$5, U$9: PB_SMALL
U$4, U$6, U$7: ESD_SYMBOL
