bogdan-tirzioru/Powersupply/firmware/powersupply/Src/main.c

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

/* Includes ------------------------------------------------------------------*/
#include "main.h"
#include "cmsis_os.h"

/* USER CODE BEGIN Includes */
#include "types.h"
#include "Display_2raw.h"
#include "processing.h"
/* USER CODE END Includes */

ADC_HandleTypeDef hadc1;
ADC_HandleTypeDef hadc2;
ADC_HandleTypeDef hadc3;

CRYP_HandleTypeDef hcryp;
__ALIGN_BEGIN static const uint32_t pKeyAES[4] __ALIGN_END = {
                            0x00000000,0x00000000,0x00000000,0x00000000};

CRC_HandleTypeDef hcrc;

DAC_HandleTypeDef hdac;

IWDG_HandleTypeDef hiwdg;

RNG_HandleTypeDef hrng;

RTC_HandleTypeDef hrtc;

SPI_HandleTypeDef hspi3;

TIM_HandleTypeDef htim1;
TIM_HandleTypeDef htim3;

UART_HandleTypeDef huart1;

WWDG_HandleTypeDef hwwdg;

osThreadId defaultTaskHandle;
void SystemClock_Config(void);
void MX_GPIO_Init(void);
void MX_ADC1_Init(void);
void MX_ADC2_Init(void);
void MX_ADC3_Init(void);
void MX_AES_Init(void);
void MX_CRC_Init(void);
void MX_DAC_Init(void);
void MX_IWDG_Init(void);
void MX_RNG_Init(void);
void MX_RTC_Init(void);
void MX_SPI3_Init(void);
void MX_TIM3_Init(void);
void MX_USART1_UART_Init(void);
void MX_USB_OTG_HS_USB_Init(void);
void MX_WWDG_Init(void);
void MX_TIM1_Init(void);
void StartDefaultTask(void const * argument);

/**
  * @brief  The application entry point.
  * @retval int
  */
int main(void)
{
  

  /* MCU Configuration--------------------------------------------------------*/

  /* Reset of all peripherals, Initializes the Flash interface and the Systick. */
  HAL_Init();

  /* Configure the system clock */
  SystemClock_Config();

  /* Initialize all configured peripherals */
  MX_GPIO_Init();
  MX_ADC1_Init();
  MX_ADC2_Init();
  MX_ADC3_Init();
  //MX_AES_Init();
  //MX_CRC_Init();
  //MX_DAC_Init();
  //MX_IWDG_Init();
  //MX_RNG_Init();
  //MX_RTC_Init();
  //MX_SPI3_Init();
  //MX_TIM3_Init();
  //MX_USART1_UART_Init();
  //MX_USB_OTG_HS_USB_Init();
  //MX_WWDG_Init();
  //MX_TIM1_Init();
  /* USER CODE BEGIN RTOS_MUTEX */
  /* add mutexes, ... */
  /* USER CODE END RTOS_MUTEX */

  /* USER CODE BEGIN RTOS_SEMAPHORES */
  /* add semaphores, ... */
  /* USER CODE END RTOS_SEMAPHORES */

  /* USER CODE BEGIN RTOS_TIMERS */
  /* start timers, add new ones, ... */
  /* USER CODE END RTOS_TIMERS */

  /* USER CODE BEGIN RTOS_QUEUES */
  /* add queues, ... */
  /* USER CODE END RTOS_QUEUES */

  /* Create the thread(s) */
  /* definition and creation of defaultTask */
  osThreadDef(defaultTask, StartDefaultTask, osPriorityNormal, 0, 128);
  defaultTaskHandle = osThreadCreate(osThread(defaultTask), NULL);

  /* USER CODE BEGIN RTOS_THREADS */
  /* add threads, ... */
  /* USER CODE END RTOS_THREADS */

  /* Start scheduler */
  osKernelStart();
  
  /* We should never get here as control is now taken by the scheduler */

  /* Infinite loop */
  /* USER CODE BEGIN WHILE */
  while (1)
  {
    /* USER CODE END WHILE */

    /* USER CODE BEGIN 3 */
  }
  /* USER CODE END 3 */
}

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
/* USER CODE BEGIN 4 */

#define ADC_TIMEOUT 100
uint32_t ADC_LiniarVoltage;
uint32_t ADC_LiniarCurrent;


double d_ADCV1,d_ADCV2;
double d_Usense,d_Isense;

uint32_t ui32counter;
/* USER CODE END 4 */

/* USER CODE BEGIN Header_StartDefaultTask */
/**
  * @brief  Function implementing the defaultTask thread.
  * @param  argument: Not used 
  * @retval None
  */
/* USER CODE END Header_StartDefaultTask */
void StartDefaultTask(void const * argument)
{
  /* USER CODE BEGIN 5 */
  ADC_ChannelConfTypeDef sConfig;

  T_UBYTE ub_DisplayPosible= 0;
  /*Initialization of task counter*/
  ui32counter = 0;
  /*Initialization of LCD Display*/
  InitDisplay2raw();
  /*start capturing in encoder module*/
//  HAL_TIM_Encoder_Start_IT(&htim3,TIM_CHANNEL_ALL);
  /*start pwm module*/
//  HAL_TIM_PWM_Start(&htim4,TIM_CHANNEL_1);
  sConfig.Rank = ADC_REGULAR_RANK_1;
  sConfig.SamplingTime = ADC_SAMPLETIME_3CYCLES;
  /* Infinite loop */
  for(;;)
  {
	  HAL_GPIO_TogglePin(LCD_C1_GPIO_Port,LCD_C1_Pin);
	  /*refresh watch dog*/
	//  HAL_WWDG_Refresh(&hwwdg);
	  /*counter task*/
	  ui32counter++;

	  sConfig.Channel = ADC_CHANNEL_0;
	  HAL_ADC_ConfigChannel(&hadc1, &sConfig);
	  HAL_ADC_Start(&hadc1);

	  sConfig.Channel = ADC_CHANNEL_1;
	  HAL_ADC_ConfigChannel(&hadc2, &sConfig);
	  HAL_ADC_Start(&hadc2);

	  sConfig.Channel = ADC_CHANNEL_2;
	  HAL_ADC_ConfigChannel(&hadc1, &sConfig);
	  HAL_ADC_Start(&hadc3);

	  HAL_ADC_PollForConversion(&hadc1,ADC_TIMEOUT);
	  HAL_ADC_PollForConversion(&hadc2,ADC_TIMEOUT);
	  HAL_ADC_PollForConversion(&hadc3,ADC_TIMEOUT);
	  /*get actual voltage ADC1VMeas*/
	  ADC_LiniarVoltage = HAL_ADC_GetValue(&hadc1);
	  d_ADCV1 = Convert_to_Voltage(ADC_LiniarVoltage);
	  d_Usense = ADC_to_Physical_VoltageDivider(d_ADCV1,10000,1100);
	  if (ub_DisplayPosible == 1)
		  SetDisplay_VoltageD(d_Usense,(T_UBYTE *)&ubDisplay_buf[0]);

	  /*get actual voltage ADC1IMeas*/
	  ADC_LiniarCurrent = HAL_ADC_GetValue(&hadc2);
	  d_ADCV2 = Convert_to_Voltage(ADC_LiniarCurrent);
	  //d_Isense = ADC_to_PhysicalINA169(d_ADCV2,0.27,4700);
	  d_Isense = ADC_to_PhysicalIntrumentationAmplifier(d_ADCV2,0.33,3.33);
	  if (ub_DisplayPosible == 1)
		  SetDisplay_CurrentD(d_Isense,(T_UBYTE *)&ubDisplay_buf[0]);
	  ub_DisplayPosible = Dispaly2raw_task();
	  osDelay(2);
  }
  /* USER CODE END 5 */ 
}

/**
  * @brief  Period elapsed callback in non blocking mode
  * @note   This function is called  when TIM10 interrupt took place, inside
  * HAL_TIM_IRQHandler(). It makes a direct call to HAL_IncTick() to increment
  * a global variable "uwTick" used as application time base.
  * @param  htim : TIM handle
  * @retval None
  */
void HAL_TIM_PeriodElapsedCallback(TIM_HandleTypeDef *htim)
{
  if (htim->Instance == TIM10) {
    HAL_IncTick();
  }
}

/**
  * @brief  This function is executed in case of error occurrence.
  * @retval None
  */
void Error_Handler(void)
{
  /* USER CODE BEGIN Error_Handler_Debug */
  /* User can add his own implementation to report the HAL error return state */

  /* USER CODE END Error_Handler_Debug */
}

#ifdef  USE_FULL_ASSERT
/**
  * @brief  Reports the name of the source file and the source line number
  *         where the assert_param error has occurred.
  * @param  file: pointer to the source file name
  * @param  line: assert_param error line source number
  * @retval None
  */
void assert_failed(uint8_t *file, uint32_t line)
{ 
  /* USER CODE BEGIN 6 */
  /* User can add his own implementation to report the file name and line number,
     tex: printf("Wrong parameters value: file %s on line %d\r\n", file, line) */
  /* USER CODE END 6 */
}
#endif /* USE_FULL_ASSERT */

/************************ (C) COPYRIGHT STMicroelectronics *****END OF FILE****/
