bogdan-tirzioru/Powersupply/(commit log)

2019-06-02 initial version
    [Connectors.SchDoc, Ethernet.SchDoc, MB1137.PcbLib, MB1137.PrjPCB, MB1137.SCHLIB, MB1137.SchDoc, MCU_144.SchDoc, ST_LINK_V2-1.SCHDOC]
2019-06-08 Fix the computation of voltage output and display voltage
    [Display_2raw.c, main.c, processing.c]
2019-06-11 Add delay and fix the intensity measured
    [Display_2raw.c, Display_2raw.h, dwt_delay.c, main.c]
2019-06-13 Implementation of encoder and pwm out
2019-06-15 add atium schematic, first version to factory
    [4GBJ406F.PCBLIB, 4GBJ406F.PrjPcb, 4GBJ406F.SCHLIB, B41888C7478M000.PCBLIB, B41888C7478M000.PrjPcb, B41888C7478M000.SCHLIB, INA169NA.PCBLIB, INA169NA.SCHLIB]
2019-06-15 some major updates to schmatic, based on latest findings
    [powersupply_grid8_0.SchDoc, powersupply_grid8_1.SchDoc]
2019-06-17 remove buck from schematic
    [powersupply_grid8_0.SchDoc]
2019-06-17 duplicate the liniar part and adnotate the schematic
    [powersupply_grid8_0.SchDoc, powersupply_grid8_1.SchDoc]
2019-07-13 new display caracter display 2x16 change driver MC21605H6W-SPR3-V2 /SPLC780d
2019-07-13 bug fix initialisation of disply
    [Display_2raw.c, Display_2raw.h, main.c]
2019-07-15 fix the initialisation of LCD
    [Display_2raw.c]
2019-07-15 fix display , delay and add second line, disable blink
    [Display_2raw.c, Display_2raw.h]
2019-07-16 activate the second aquisition on the ADC1 and add extra digit on the display for voltage
2019-07-17 add second digit on the voltage
2019-08-30 bugfix the load rezistor and double parameter in computing the current
    [main.c, processing.c, processing.h]
2019-08-30 add extradigit to measure current
2019-08-30 change back the schematic as original as in factory
    [powersupply_grid8_0.SchDoc, powersupply_grid8_1.SchDoc]
2019-10-25 Redegin schematic with 2 analog channels
    [powersupply_grid8_0.SchDoc, powersupply_grid8_1.SchDoc]
2019-12-10 add schematic for new generation of power supply, only one channel
    [powersupply_grid8.PrjPcb, powersupply_grid8_0.SchDoc, powersupply_grid8_1.SchDoc, powersuppy.PcbDoc]
2019-12-15 add led for current limitation
    [powersupply_grid8_0.SchDoc, powersupply_grid8_1.SchDoc, powersuppy.PcbDoc]
2019-12-16 add led for current limit
    [powersuppy.PcbDoc]
2019-12-17 work on the pcb rev B
    [powersupply_grid8_0.SchDoc, powersupply_grid8_1.SchDoc, powersuppy.PcbDoc]
2019-12-17 step routing 2 in B sample
    [Copy of powersuppy.PcbDoc, powersupply_grid8_0.SchDoc, powersupply_grid8_1.SchDoc, powersuppy.PcbDoc]
2019-12-17 step 3 layout sample B
    [powersupply_grid8_0.SchDoc, powersupply_grid8_1.SchDoc, powersuppy.PcbDoc]
2019-12-18 add 3v3 liniar regulator
    [powersupply_grid8.PrjPcb, powersupply_grid8_0.SchDoc, powersupply_grid8_1.SchDoc, powersuppy.PcbDoc]
2019-12-19 create lib for IFX91041EJV33
    [IFX91041.PcbLib, IFX91041.SchLib, PcbLib1.PcbLib, powersupply_grid8_1.SchDoc]
2019-12-19 add components for buck converter
    [DE1207.PcbLib, IFX91041.SchLib, diode_sk.SCHLIB, powersupply_grid8_0.SchDoc, powersupply_grid8_1.SchDoc]
2019-12-20 more tracks routed in the analog area
    [powersupply_grid8_1.SchDoc, powersuppy.PcbDoc]
2019-12-21 place gnd planes
    [powersupply_grid8_0.SchDoc, powersupply_grid8_1.SchDoc, powersuppy.PcbDoc]
2019-12-21 rework some of dgnd traces
    [powersuppy.PcbDoc]
2019-12-27 new pcb layout version
    [powersupply_grid8.PrjPcb, powersuppy.PcbDoc]
2020-01-01 prepare for factory sampleB
    [powersupply_grid8.PrjPcb, powersupply_grid8_0.SchDoc, powersupply_grid8_1.SchDoc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]
2020-02-19 Initial version for Sample B
2020-02-22 firmware update for sampleB
    [powersupply_grid8.PrjPcb]
2020-03-11 extra logs
    [4GBJ406F.PrjPcb, B41888C7478M000.PrjPcb, KF33BD-TR.PrjPcb, PCV-2-564-08L.PrjPcb, Panasonic-EEEFT_EEEH.PrjPcb, WE-CBF.PrjPcb, WE-CNSW.PrjPcb, con-3m.PrjPcb]
2020-06-01 document the sample A schematic
2020-06-07 include same trimming in the current sense, compensate the output offset
2020-10-24 reaserch folder
    [EEZ PSU AUX PS r5B9 BOM.ods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]
2020-11-06 documentes relacting the oscilations of series tranzistor
    [lm317.xlsx]
2021-10-17 add doc for fearther testing
    [powersuppy.PcbDoc]
