bogdan-tirzioru/Powersupply/(notices)

Notices in the files:
firmware/powersupply/Inc/main.h:
© Copyright (c) 2020 STMicroelectronics.
All rights reserved.
This software component is licensed by ST under Ultimate Liberty license
firmware/powersupply/Src/dwt_delay.c:
under the terms of the GNU General Public License as published by
the Free Software Foundation, either version 3 of the License,
or (at your option) any later version.
